BigBiglinn/INSULIN_PUMP/docs/handover/ROUTING_STAGES.md

# Staged re-route log (branch `placement-opt`)

**Board status:** NOT fully connected, NOT electrically verified, NOT fabrication-ready.

**Recovery points (never amended):**
- tag `baseline-routing-e8d141c`: the routed board before placement optimisation;
- commit `9da03dc`: the approved v2 placement, ripped up and not routed.

## 0. Pre-routing reconciliation (owner gate 2)

The full table is in `validation/logs/unrouted_reconciliation.md`, generated by `scripts/reconcile_unrouted.py`. It lists every pair, both endpoints and every pad on each affected net.

The 80 unconnected pairs, each assigned to exactly one group:

| Group | Pairs | Nets | Content |
|---|---|---|---|
| W: WBA55-related, waiting for the ST documents | 12 | 8 | HSE_IN/OUT, LSE_IN, RF_MCU, WBA_VDD11/VDDANA/VDDRF/VDDRFPA. Unchanged since the baseline. |
| P: placeholder or intentionally unfitted endpoint | 11 | 7 | Pairs ending on DNP or PLACEHOLDER parts: R312 bleeder, Q302/R309/R310 output switch, Q303 level shifter, T301 transformer, and R714 RS-485 termination (DNP) |
| R: opened by the approved placement rip-up | 44 | 23 | All on the 23 nets listed in `validation/logs/placement_move_log.txt` |
| G: genuine, existed before placement | 13 | 12 | +3V3, CHG_INT_N, ENC_A_S, ENC_I, ENC_I_M, I2C_SDA ×2, MAIN_SWCLK, PMD_MOSI_M, PMD_READY_M, PMD_SCLK_M, VBAT_FUSED, VBAT_SENSE |

**Correction to the earlier "14 genuine" figure.** One of those 14, RS485_B (R714.2 ↔ U701.7), has R714 as its only missing end, and R714 is DNP (the RS-485 terminator). It is therefore counted under P. The genuine count is 13.

Of the 22 genuine baseline pairs:
- 13 are in G;
- 1 (RS485_B) is in P;
- 8 were on nets that the placement rip-up has since removed in full (CON_SUP_RX/TX, +48V_MOT ×2, ENC_VCC, FLY_PGOOD ×2, FLY_SS). Those connections are now inside groups R and P.

## 0.1 Topology gate for the flyback / 48 V output (owner gate 3)

| Net(s) | Defined by the schematic and ratings? | Decision |
|---|---|---|
| FLY_GATE, FLY_CS, FLY_RT, FLY_SS, FLY_FB (low-voltage node), FLY_COMP, FLY_COMP_RC; FLY_PGOOD local part (U301.11 / R302 / TP302); U301 VCC to C304; PGND pin to EP | Yes. Every part is fitted with status DS, CALC or DECIDED. Connections follow LM51551 SNVSB75E Table 7-1 and Fig. 10-12. Part values are preliminary but do not change the connections. | **Route in Stage 1** |
| FLY_SW, FLY_SEC, FLY_CLAMP (and VBAT/GND at T301) | **No.** T301 is a PLACEHOLDER footprint with an assumed pinout (U-04 / FL-4). The clamp loop geometry depends on the real part (FL-1). | **Blocked:** needs the transformer choice |
| +48V_MOT to J703, TP301, C702 | **No.** The J703 (JST SH, 1.0 mm pitch) rating and the HV48 clearance rule are unapproved (U-17 / FL-6 / CF-6). | **Blocked:** needs approval |
| +48V_RAW (D301 / C309 / C310 / C311 / C312 / R307 / R311) and FLY_SNUB | **Not safely.** Secondary OVP (U-23 / FL-8) may need space on +48V_RAW. The output switch and bleeder (U-06, M8 deferred) share the net. The snubber values depend on T301. | **Blocked:** needs the OVP and output-switch decision |
| FLY_EN | Defined, but it is a safety net (see below) | Its own later stage, reviewed separately |

## 0.2 Safety-control nets (owner gate 6)

**FLY_EN** (K-10, fail-off). Intended pads, from `scripts/design.py`, sheet "Kill path":
- U301.12 (LM51551 UVLO/EN);
- R401.1 (4.7 k pull-down to GND: fail-off default);
- R402.2 (1 k from MCU_48V_EN, so the supervisor can overpower the main MCU);
- Q401.3 (BSS138 drain; gate = SUP_VETO with the R403 10 k pull-up, so the veto is ON by default);
- TP401.1;
- Q303.1, a DNP PLACEHOLDER level shifter for the undesigned output switch. It is optional until U-06 is decided and will remain an unconnected P item.

Intended levels:
- MCU high: 3.3 V × 4.7 / 5.7 = 2.72 V, so the converter runs.
- Pull-down only, or Q401 on: about 0 V, below the 0.4 V EN minimum (SNVSB75E), so it shuts down.

A completed route proves only copper continuity. It does not prove fail-off behaviour; that still needs SG-03/SG-05 on hardware (bench validation is outside this digital handover).

**HB_S2M** (supervisor to main heartbeat): U601.13 (STM32C031 PA2, USART2_TX) to U501.12 (STM32WBA55 PA1, LPUART1_RX), point to point, with no other parts. The pins were checked against the STM32CubeMX 6.18.1 database (`validation/logs/pinmap_check.md`). Routing it does not prove the heartbeat or timeout logic, which is firmware and needs bench verification.

Neither net is routed in Stage 1.

## 1. Stage 1: LM51551 controller nets (11 Oct 2026)

**Checkpoints:**
- `route-stage1-before`: tag, before Stage 1;
- `route-stage1a-hand`: tag, after the power-critical hand routes.

**Route specifications:** `validation/routing/stage1_hand.json` (1a) and `validation/routing/stage1_hand_b.json` (1b), applied with `scripts/route_stage.py hand`.

**Why not Freerouting:** Freerouting 2.1.0 ignored both `-inc` (ignore net classes) and `-mp` (maximum passes). It routed nets outside the stage and did not stop, so I stopped it and used none of its output. Every Stage 1 route is an explicit, reviewable geometry that was checked by DRC.

### 1.1 Results against `route-stage1-before`

Full comparison: `validation/routing/stage1_vs_checkpoint.txt`, from `scripts/compare_stage.py`.

| Check | route-stage1-before | Stage 1 done |
|---|---|---|
| ERC | 6 power_pin_not_driven (U501, intentional) + 1 lib_symbol_mismatch | identical (schematic not modified) |
| DRC copper (clearance, short, crossing, hole, edge) | 0 | 0 |
| Schematic parity | 0 | 0 |
| via_dangling / track_dangling | 6 / 1 | 6 / 1 (same items) |
| Silkscreen warnings (overlap / over copper / edge / mirrored) | 82 / 73 / 3 / 2 | identical |
| Unconnected pairs | 80 | **67** |
| Nets whose copper changed | n/a | FLY_GATE, FLY_CS, FLY_FB, FLY_SS, FLY_RT, FLY_COMP, FLY_COMP_RC, FLY_PGOOD, plus GND and VBAT plane stubs at U301 and C305; **nothing outside this list** |
| BOM re-export | n/a | byte-identical to the committed BOM |

**The 13 net closures:**
- FLY_COMP ×2
- FLY_COMP_RC
- FLY_CS ×4
- FLY_FB ×2
- FLY_GATE
- FLY_PGOOD R302.1–TP302.1
- FLY_RT
- FLY_SS

**Explanation of every changed or "new" unconnected pair:**
- **FLY_PGOOD:** the pair `R302.1–U301.11` is now reported as `Track–U301.11`. The R302/TP302 part is routed; U301.11 is still not connected (blocked, see §1.3). `U301.11–U501.28` is unchanged; it belongs to the signal stage.
- **SW48_GATE, VBAT_FUSED, VBAT_SENSE, WBA_VDDRFPA:** one pair each was relabelled by KiCad after the zone refill, which chose a different nearest endpoint. No copper on these nets changed, and the per-net pair counts are unchanged. These are not new gaps.

### 1.2 Check against the LM51551 layout guidance (SNVSB75E section 10.5.1)

| Item | As routed | Assessment |
|---|---|---|
| Gate drive U301.3 → Q301.4 | 4.67 mm, 0.3 mm wide, **2 vias**. The B.Cu segment is 2.9 mm. | Short, but not ideal. The vias are forced because the gate path must cross the Q301 → R305 current path (the Q301 gate pin faces R305). The B.Cu segment references In2 (VBAT polygon), not the In1 GND plane, so its return path couples through the VBAT plane and its decoupling. **Review item.** |
| Switch current path Q301 source (pads 1–3) → R305.1 | about 6.3 mm, 0.5 mm wide (bar over the source pads), F.Cu, no vias | Meets the "small loop" intent for its part of the loop. 0.5 mm on 1 oz copper is adequate for about 1.1 A rms (FLYBACK_DESIGN.md), with 3.1 A peaks. A wider pour is preferable when the clamp and transformer area is finalised. |
| Kelvin sense U301.5 → R305.1 | 6.8 mm, 0.2 mm wide, F.Cu, no vias. Lands on R305.1 separately from the power track, about 0.6 mm from it. | The sense trace shares no copper with the power path, so the 0.5 mm power track's resistance is outside the measurement. Remaining items: the sense lands at the outer (left) half of the pad rather than its inner edge; the CS return side (R305.2 → GND) goes through the plane, not a Kelvin trace to U301 PGND (this is **FL-3**); and the sense trace runs parallel to the power track for about 3.3 mm. **Review items.** |
| VCC / BIAS (U301.1, .2) → C304.1 | Pins 1 and 2 joined, then 3.9 mm, 0.3 mm wide, to C304.1. C304.1 and C304.2 each keep their own plane via. The 3 old VCC/PGND plane vias next to U301 were removed. | Follows "CVCC near the device": the capacitor is now in the direct VCC path instead of being reached only through the plane. C304's ground returns through a plane via (2.2 µF, 1.6 mm from the pins). |
| PGND (U301.4) → exposed pad | 0.7 mm direct, 0.25 mm wide | Pin 4 now joins the exposed pad directly. |
| Exposed pad (U301.13) to the GND plane | One stub plus 1 via (from the earlier fan-out) | **Review item:** only one via. SNVSB75E's thermal guidance favours several vias under or around the pad. Adding thermal vias is a layout addition I have not made. |
| FB node (U301.8, R307.2, R308.1) | 9.5 mm, 0.15 mm wide, 2 vias, B.Cu hop of 3.55 mm under the R/C column. At least 3.7 mm from the gate segment; nowhere near FLY_SW (x ≥ 170). | The top-layer paths are blocked by the 0.6 mm HV48 clearance around R307.1 (+48V_RAW) and by a GND via. Routing it longer than ideal is a deliberate trade for keeping the high-impedance node away from switching copper. |
| RT, SS, COMP, COMP_RC | 3.4–7.2 mm, F.Cu, no vias | Short and direct; the AGND-side parts keep their own plane vias. |
| C305.2 (SS cap) ground | Its fan-out via was removed. It now shares R308.2's existing GND plane via (0.73 mm track). | Still a direct plane connection. This was needed to open the pin 8 (FB) escape. |

### 1.3 Blocker found in Stage 1 (resolved by D1 option 1, see §3)

**FLY_PGOOD U301.11 → R302.1 is not routed.**

Pin 11 sits between pin 10 (RT, routed) and pin 12 (FLY_EN, reserved). The only direct escape to the west is blocked by R301.2's GND fan-out via at (163.82, 160.0). Moving that via is not possible without one of these:

1. **Rotate R301, R302, C305 and R308 by 180°**, so that their signal pads face U301 and their GND pads face away. This is the cleanest fix but is a component move.
2. **Tie the RT, SS and FB-bottom grounds to the U301 AGND pin or exposed pad with local copper.** This is the SNVSB75E AGND recommendation, but it is the **FL-3** grounding decision.
3. **Give pin 11 the escape via reserved for FLY_EN** (about (164.2, 161.0)). This would push FLY_EN onto a worse path, so it needs a FLY_EN decision first.

### 1.4 Not routed in Stage 1, by design

- FLY_EN (Stage 2, safety review);
- HB_S2M;
- FLY_PGOOD U301.11 → U501.28 (signal stage);
- FLY_SW, FLY_SEC, FLY_CLAMP and FLY_SNUB (T301 placeholder);
- +48V_RAW and +48V_MOT (OVP, output switch, J703 rating);
- all WBA55-dependent nets.

**Pre-existing item noted:** the SW48_GATE autorouted track (a DNP placeholder net) runs on F.Cu at x = 170.33, between Q301's source and drain pads. It passes DRC. It should be removed or re-routed when the output switch (U-06 / M8) is decided, because it lies next to the switch node.

### 1.5 Updated reports

- `validation/drc/pump_v2-drc.rpt` and `.json`
- `validation/erc/pump_v2-erc.rpt`
- `validation/logs/unrouted_reconciliation.md` (W 12 / P 11 / R 31 / G 13 = 67)
- `validation/logs/unrouted_nets.txt` (older grouping, kept for continuity; it still counts RS485_B as genuine)
- `validation/logs/unrouted_corridors.txt`
- `validation/routing/stage1_fcu_controller.png` (F.Cu around U301/Q301; the F.Cu GND pour is shown filled)

## 2. Stage 2: encoder supply, PMD401 5 V, supervisor console (11 Oct 2026)

**Checkpoints:**
- `route-stage2-before` (= `route-stage1-done` copper; the docs commit 4510a91 is in between);
- `route-stage2-done`.

**Route specification:** `validation/routing/stage2_hand.json`, applied with `scripts/route_stage.py hand`. Full comparison: `validation/routing/stage2_vs_checkpoint.txt`.

**Scope change:** +3V3 to R302 was taken out of Stage 2. The approved D1 rotation of R302 moves the pad it lands on, so it is routed in the D1 milestone.

**Freerouting:** I tried it once more, with the restriction set in its own settings file (`ignore_net_classes`, `max_passes`, `job_timeout`). It ignored all three: 51 passes, no timeout, and every net routed. I stopped it, discarded its output and restored the settings file. Every Stage 2 route is explicit.

### 2.1 Routes

| Net | Path | Width | Layers / vias |
|---|---|---|---|
| ENC_VCC | JP701.2 → C701.1 → J705.3. C701 sits in series on the path, so the decoupling capacitor is between the jumper and the connector. | 0.3 mm | F.Cu, 0 vias |
| PMD_5V | JP701.3 → via → B.Cu under the ENC_A/ENC_SHLD F.Cu wall, east of the RS-485 B.Cu run → J702.2 → B.Cu between the PMD_MOSI via and the J702.MP GND via → J701.3 | 0.3 mm | F/B, 3 vias |
| CON_SUP_RX | U601.32 → corridor between the U601 right-hand pins and SUP_VETO (0.25 / 0.26 mm gaps) → via → B.Cu under HB_M2S → J503.4 | 0.2 mm | F/B, 1 via |
| CON_SUP_TX | U601.29 → east below the SUP_VETO via → north at x = 157.85, between SUP_PARK and the flyback controller parts → via → B.Cu north of the J503 row → J503.3 | 0.2 mm | F/B, 1 via |

**Review notes:**
- **CON_SUP_TX** runs about 32 mm, partly past the edge of the flyback controller area (about 2.0 mm edge to edge from the FB via at (160.2, 156.4), about 2.8 mm from the R308 pad). It is a low-speed console UART, so this is acceptable for a bench prototype.
- **CON_SUP_RX** squeezes between the U601 pins and the SUP_VETO track with 0.25 mm gaps. That is legal under the generic rules (0.15 mm), but tight.
- **PMD_5V** is a long B.Cu run along the connector edge. Its current is small: the PMD401 "5V Out" feeds only the encoder, and only when JP701 is set to 2–3.

### 2.2 Results against `route-stage2-before`

| Check | route-stage2-before | route-stage2-done |
|---|---|---|
| ERC | 6 intentional U501 errors + 1 cosmetic U701 warning | identical (schematic not modified) |
| DRC copper (clearance, short, crossing, hole, edge) | 0 | 0 |
| Schematic parity | 0 | 0 |
| via_dangling / track_dangling | 6 / 1 | 6 / 1 (same items) |
| Silkscreen warnings | 82 / 73 / 3 / 2 | identical |
| Unconnected pairs | 67 | **61** |
| Nets whose copper changed | n/a | ENC_VCC, PMD_5V, CON_SUP_TX, CON_SUP_RX only (29 items added, 0 removed) |
| BOM re-export | n/a | byte-identical |

**Pairs closed (6):** ENC_VCC ×2, PMD_5V ×2, CON_SUP_TX, CON_SUP_RX.

**Relabelled pairs:** +3V3, VBAT_FUSED, WBA_VDDRF and WBA_VDDRFPA each show one pair with different reported endpoints after the zone refill. No copper on these nets changed and the per-net counts are unchanged. **No regressions.**

**Electrical testing:** none performed. Copper continuity is not functional verification.

## 3. D1 milestone: R301 / R302 / C305 / R308 rotation (11 Oct 2026)

**Approval:** owner-approved option 1, subject to clearance and connectivity checks.

**Checkpoints:**
- `route-d1-before` (= commit 3f7ba36, `route-stage2-done`);
- `route-d1-done`.

**Route specification:** `validation/routing/d1_rotation.json`, applied with `scripts/route_stage.py hand`, which gained `rotate` and exact-segment `remove_tracks` support. Full comparison: `validation/routing/d1_vs_checkpoint.txt`. Render: `validation/routing/d1_fcu_controller.png`.

**Freerouting:** not used.

### 3.1 What the rotation affected (inspected before any change)

Rotating each part 180° in place swaps its pad positions. Eight copper items landed on the four parts. All of them came from Stage 1 or the original plane fan-out; **no Stage 2 copper was affected.**

| Pad (before) | Copper on it | Action |
|---|---|---|
| R308.2 GND, C305.2 GND | Stubs to a shared GND via at (162.82, 157.47) | Via and stubs removed. After rotation that via would sit between the FB and SS pads. |
| R301.2 GND | Stub to a GND via at (163.82, 160.0) | Removed. It would have landed on the RT pad, and it was the via blocking the U301.11 escape. |
| R302.2 +3V3 | Stub to a +3V3 via at (163.82, 161.8) | Removed. It would have landed on the PGOOD pad, and it never reached a +3V3 plane, because In2 is the VBAT polygon there. |
| R308.1 FB | B.Cu hop with 2 vias from the FB node | Removed. R308.1 now faces U301, so no via is needed. |
| C305.1 SS, R301.1 RT | Stage 1b SS and RT routes | Replaced by shorter direct routes |
| R302.1 PGOOD | Stage 1b TP302 link | Replaced |

### 3.2 New copper

| Net | Route | Width | Vias |
|---|---|---|---|
| FLY_FB | FB vertical closed at the old via jog. Stub (163.55, 156.4) → R308.1. The U301.8 → R307.2 section from Stage 1 is unchanged. | 0.15 mm | **0** (was 2) |
| FLY_SS | U301.9 → under the FB corner → C305.1 | 0.15 mm | 0 |
| FLY_RT | U301.10 → R301.1 | 0.15 mm | 0 |
| FLY_PGOOD | U301.11 → (164.1, 159.75) → x = 163.6 → R302.1. TP302 → channel between the R301 and R302 rows → R302.1. | 0.15 / 0.2 mm | 0 |
| GND | R308.2, C305.2 and R301.2 each get their **own** stub and GND plane via on the west side (x = 160.2) | 0.3 mm | 3 |
| +3V3 | R302.2 → south → west along y = 162.9 → via at (154.6, 163.6), over the In2 +3V3 region (x < 155) | 0.25 mm | 1 |

**Grounding topology unchanged.** Every GND pad still has its own direct plane via, as before. The only difference is which side of the part the via sits on. No local AGND copper, no new GND-to-GND links, and no AGND/PGND change (FL-3 untouched).

### 3.3 Results against commit 3f7ba36 (`route-stage2-done`)

| Check | 3f7ba36 | route-d1-done |
|---|---|---|
| ERC | 6 intentional U501 errors + 1 cosmetic U701 warning | identical (schematic not modified) |
| DRC copper (clearance, short, crossing, hole, edge) | 0 | 0 |
| Schematic parity | 0 | 0 |
| via_dangling / track_dangling | 6 / 1 | 6 / 1 (same items) |
| silk_overlap / silk_over_copper | 82 / 73 | **83 / 71** (see below) |
| silk_edge / unmirrored text | 3 / 2 | 3 / 2 |
| Unconnected pairs | 61 | **59** |
| Footprints changed | n/a | R301, R302, C305 and R308 only: orientation 0° → 180°, positions unchanged |
| Nets whose copper changed | n/a | FLY_FB, FLY_SS, FLY_RT, FLY_PGOOD, GND (local stubs and vias), +3V3 (R302 only). Nothing else. |
| BOM re-export | n/a | byte-identical |

**Pairs closed (2):**
- FLY_PGOOD U301.11 ↔ R302 (local part now complete);
- +3V3 to R302.

**Relabelled pairs, with no copper change on the net:**
- FLY_PGOOD's remaining U501.28 gap is now reported from a track end. It is Stage 5a.
- RS485_B, SW48_GATE, VBAT_FUSED, WBA_VDDRF and WBA_VDDRFPA each show different endpoints after the zone refill. Their per-net counts are unchanged.

**Silkscreen changes:** every one involves the reference text of a rotated part, which rotated with it: 15 items removed, 14 added. They are cosmetic, to be cleaned up with U-32.

**Regressions: none.**

### 3.4 Checks specific to this milestone

| Item | Result |
|---|---|
| HV48 clearance near R307.1 (+48V_RAW) | DRC 0. The nearest new copper is the GND via at (160.2, 156.4), about 1.15 mm from the R307.1 pad (rule 0.6 mm). |
| FLY_EN escape for Stage 3 (pin 12 → via site (164.2, 161.0)) | Still free. The via site is 0.223 mm from the new PGOOD track and the stub path is at least 0.273 mm from foreign copper (rule 0.15 mm). This is only checked at the escape; the full FLY_EN route is Stage 3. |
| FB node | Now 0 vias and shorter. The high-impedance node stays on F.Cu, away from switching copper. |
| CON_SUP_TX (Stage 2) | Unchanged. The nearest D1 copper is the GND vias at x = 160.2, about 1.9 mm away. |

**Electrical testing:** none performed. Copper continuity is not functional verification.

## 4. Stage 3: safety-control nets FLY_EN and HB_S2M (11 Oct 2026)

**Checkpoints:**
- `route-stage3-before` (= commit 6a4367b, `route-d1-done`);
- `route-stage3-done`.

**Route specification:** `validation/routing/stage3_hand.json`, applied with `scripts/route_stage.py hand`. Full comparison and clearance margins: `validation/routing/stage3_vs_checkpoint.txt`.

**Freerouting:** not used.

### 4.1 Pre-routing review (owner items 2–4)

| Item | Evidence | Conclusion |
|---|---|---|
| FLY_EN intent | `scripts/design.py`, sheet "Kill path" (K-10): U301.12 UVLO/EN, R401 4.7 k to GND (fail-off), R402 1 k from MCU_48V_EN, Q401 drain, TP401 | Connect U301.12, R401.1, R402.2, Q401.3 and TP401.1 |
| LM51551 pin 12 (TI SNVSB75E, Rev E, Aug 2023: pin table, §7 electrical characteristics, §9.3.1, §9.3.5) | UVLO/EN/SYNC. Enable 0.4 / 0.52 / 0.7 V; UVLO rising 1.425 / 1.5 / 1.575 V; below VEN, shutdown after about 35 µs. "Must not be left floating." Falling edges on this pin act as a **sync input**. 5 µA UVLO hysteresis current. | Levels as designed: 2.72 V when the MCU drives it, about 0 V with the pull-down or the veto. The 5 µA × 825 Ω gives about 4 mV, which is negligible. **Layout consequence:** keep FLY_EN away from the switch node, so coupled negative glitches cannot act as sync pulses. |
| Q401 pinout (Nexperia BSS138, `docs/datasheets/bss138_nexperia.pdf`, Table 2) | 1 = G, 2 = S, 3 = D | Matches the schematic: G = SUP_VETO, S = GND, D = FLY_EN |
| HB_S2M intent | `scripts/design.py`; `validation/logs/pinmap_check.md` (STM32CubeMX 6.18.1 database) | U601.13 = PA2 USART2_TX (supervisor) → U501.12 = PA1 LPUART1_RX (main). Point to point, no other parts. |
| Q303 (on FLY_EN) | DNP PLACEHOLDER level shifter for the undesigned K-12 output switch (U-06) | **Not connected.** It depends on the unresolved output-switch design. FLY_EN – Q303.1 stays an unconnected P item by design. |
| FLY_EN escape (the 0.223 mm item from D1) | Re-measured along the **full** route after routing (§4.3) | Legal everywhere (rule 0.15 mm). Tightest gap 0.224 mm, at the escape. |

### 4.2 Routes

| Net | Path | Length / vias |
|---|---|---|
| FLY_EN | **Local tree, F.Cu 0.2 mm:**<br>- R402.2 → TP401;<br>- R401.1 → (between the R401/R402 and R405 rows) → TP401;<br>- TP401 → Q401.3, entering from above, clear of the SUP_VETO diagonal.<br>**Long run:** via at (173.4, 133.0), then one straight B.Cu run to the Stage 1 escape via (164.2, 161.0), then U301.12. | 47.4 mm, 2 vias |
| HB_S2M | U501.12 → escape south-west past the pin 11 +3V3 via → F.Cu west at y = 122.3 → south at x = 134.5 → via at (134.5, 161.3) → B.Cu east at y = 161.3 → via under the U601 body at (147.25, 161.3), between SUP_NRST and HB_M2S → U601.13 from its inner end | 64.9 mm, 2 vias |

**Why HB_S2M is long.** U501.12 sits at the corner next to the WBA55 supply-placeholder block (C510–C513, R511–R513, their VDDRF / VDDRFPA F.Cu tracks, and the LSE_OUT / VDDHPA / VDDRFPA B.Cu runs at y ≈ 127.8–128.5). A direct southward route would need a via in that block, and there is no legal space for one on either layer. It would also pre-empt the WBA55 supply layout that D5 defers until the ST documents arrive. The chosen route goes around the block's west edge and touches none of that circuitry.

### 4.3 Clearance margins along the full routes (edge to edge; rule 0.15 mm, HV48 0.6 mm)

| Net | Tightest foreign copper | Next | Switching copper (FLY_SW / GATE / CS / CLAMP / SEC) |
|---|---|---|---|
| FLY_EN | 0.224 mm FLY_PGOOD track (U301 escape) | 0.274 mm U301.11; 0.349 mm U301 EP (GND); 0.423 mm GND via (B.Cu); 0.516 mm SUP_VETO | nearest is the U301.3 gate pin at 1.79 mm. The B.Cu run is at least 2.7 mm from the gate B.Cu segment and about 5 mm from the switch node. |
| HB_S2M | 0.199 mm SUP_NRST (U601 corner) | 0.249 mm U601.14 (HB_M2S); 0.274 mm U501.11 / +3V3 stub | none within 3 mm |

No HV48 net is within the 0.6 mm class clearance of either route.

### 4.4 Results against `route-d1-done`

| Check | route-d1-done | route-stage3-done |
|---|---|---|
| ERC | 6 intentional U501 errors + 1 cosmetic U701 warning | identical (schematic not modified) |
| DRC copper (clearance, short, crossing, hole, edge) | 0 | 0 |
| Schematic parity | 0 | 0 |
| via_dangling / track_dangling | 6 / 1 | 6 / 1 (same items) |
| Silkscreen (overlap / over copper / edge / mirrored) | 83 / 71 / 3 / 2 | identical |
| Unconnected pairs | 59 | **54** |
| Footprints changed | n/a | none |
| Nets whose copper changed | n/a | FLY_EN (+13 items) and HB_S2M (+8 items) only; 0 removed anywhere |
| BOM re-export | n/a | byte-identical |

**Pairs closed (5):**
- FLY_EN R402.2–TP401, R401.1–TP401, TP401–Q401.3 and Q401.3–U301.12;
- HB_S2M U501.12–U601.13.

**Remaining FLY_EN pair:** the DNP placeholder Q303.1 only, which is intentional.

**Relabelled pairs, with no copper change on the net:** CHG_INT_N, SW48_GATE, VBAT_FUSED and WBA_VDDRFPA.

**Regressions: none.**

### 4.5 Safety-control review notes (not resolved by routing)

- **Continuity is not behaviour.** A routed FLY_EN proves only copper continuity. Fail-off behaviour (pull-down default, veto overriding the MCU, shutdown below VEN) needs **SG-03 / SG-05 on hardware**. Neither has been performed.
- **FLY_EN and the VBAT plane.** The FLY_EN B.Cu run lies under the controller area, over the In2 VBAT polygon, which carries the pulsed flyback primary current. The node impedance is about 825 Ω (1 k ∥ 4.7 k). Coupled ripple is expected to be small but has **not been analysed or measured**. The UVLO/SYNC pin interprets falling edges as sync pulses, which is why this needs bench confirmation.
- **HB_S2M length.** HB_S2M is long (64.9 mm) and runs parallel to the board's west region. It is a low-speed UART heartbeat. Its timeout and fault behaviour are firmware, untested.
- **Tight gaps.** HB_S2M passes 0.199 mm from SUP_NRST and 0.249 mm from HB_M2S at the U601 corner. That is legal under the generic rules; a fab rule check is still needed (U-16).
- **Q303 is unconnected.** If the output switch (U-06) is designed with this level shifter, FLY_EN's routing must be revisited.

**Electrical testing:** none performed.

## 5. Stage 4: encoder connections (11 Oct 2026)

**Checkpoints:**
- `route-stage4-before` (= commit a6fd898, `route-stage3-done`);
- `route-stage4-done`.

**Route specification:** `validation/routing/stage4_hand.json`, applied with `scripts/route_stage.py hand`. Full comparison and margins: `validation/routing/stage4_vs_checkpoint.txt`.

**Freerouting:** not used.

### 5.1 Pre-routing verification (owner item 2)

| Net | Endpoints (board = schematic, parity 0) | Intent (source) |
|---|---|---|
| ENC_B | J705.4, D708.1, R709.2, R712.2 | Encoder B from J705 → TVS D708 (E-07) → R709 100 Ω to the main MCU (ENC_B_M, U501 PA8 TIM2_CH2) and R712 100 Ω to the supervisor (S-07). `scripts/design.py` |
| ENC_B_S | R712.1, U601.18 | Supervisor encoder B: U601 PA7 TIM3_CH2 (CubeMX check, `pinmap_check.md`) |
| ENC_A_S | R711.1, U601.17 | Supervisor encoder A: U601 PA6 TIM3_CH1 (CubeMX check) |
| ENC_I | J705.1, R710.2, D709.1 | Encoder index → TVS D709 → R710 to the main MCU (ENC_I_M). R710.2 and D709.1 were already joined; only J705.1 was missing. |

**Caveats recorded, not resolved by routing:**
- J705's pinout is **ASSUMED**: it mirrors the PMD401 sensor connector, "VERIFY vs LL06 encoder cable" (U-14). ENC_A, ENC_VCC and GND were already routed to it on the same assumption.
- D707–D709 are **TBD** TVS parts (U-15). The SOD-323 footprint and the shunt connection are defined; if the chosen part changes the footprint, the pad connections must be re-checked.

**Not touched:** RS485_B → R714, which waits for the owner decision (D3).

### 5.2 Routing method: `scripts/grid_route.py` (new)

Freerouting is not used. I wrote a small, deterministic, two-layer grid router (A\*, 8-directional, via cost 4 mm) that routes **one named connection at a time**:
- All existing copper is a fixed obstacle, at rule clearance + 0.05 mm margin (0.2 mm; 0.7 mm to HV48 nets).
- RF_ANT and RF_MCU get 1 mm extra on every layer; LSE_IN and LSE_OUT get 0.8 mm.
- No via inside any pad.
- **Owner keep-outs:**
  - the WBA55 / U501 / RF / crystal / SWD region, x 129.5–162.5, y 100.5–134 (D5);
  - the flyback / 48 V block, x 159.6–200, y 140.5–168.

Its output is an ordinary explicit route specification (pad-centre endpoints, 45° geometry), which then goes through the same apply, DRC and compare steps.

**Bug found and fixed during this stage.** In the first ENC_A_S / ENC_B_S run, the keep-out rectangles were not applied: a zero-radius rectangle marked no cells. ENC_A_S came out under C518 (the LSE load-capacitor placeholder) inside the WBA55 keep-out. That output was discarded and the router fixed. The Stage 4a routes (ENC_B and ENC_I) were then checked point by point and lie wholly outside both keep-outs. The two supervisor lines were routed on a 0.05 mm grid, so the 0.5 mm-pitch U601 pins sit on grid. One generated ENC_B overlap (duplicated same-net copper at x = 179.1) was merged by hand before applying.

### 5.3 Routes

| Net | Length (net copper) | Vias | Path summary |
|---|---|---|---|
| ENC_B | 58.1 mm | 2 | R712.2 → D708.1 → R709.2 on F.Cu, in the encoder-interface row. J705.4 → north-west on F.Cu along x = 201.6, then diagonally → B.Cu hop → R712.2. |
| ENC_I | 60.8 mm (including pre-existing copper) | 4 (2 new) | J705.1 → via → B.Cu diagonal and vertical at x = 192.6 → via → D709.1 |
| ENC_A_S | 68.0 mm | 4 | U601.17 → via under the U601 body → B.Cu north-east, then north at x = 159.0 in the corridor between the two keep-outs → x = 162.55 along the keep-out edge → F.Cu up x = 168.25 → R711.1 |
| ENC_B_S | 71.8 mm | 4 | U601.18 → via under the U601 body → B.Cu around the ENC_A_S via (small hook) → F.Cu north at x = 153.1 (between HB_M2S and SUP_VETO) → along the keep-out edge → B.Cu → F.Cu up x = 169.1 → R712.1 |

### 5.4 Clearance margins (edge to edge; rule 0.15 mm)

| Net | Tightest foreign copper | Switching or 48 V copper within 3 mm |
|---|---|---|
| ENC_B | 0.199 mm (ENC_A_S via, JP701.3, PMD_5V via); 0.249 mm R704.2, R710.1 | none |
| ENC_I | **0.151 mm PMD_MOSI (B.Cu)**. **Pre-existing:** it is the old ENC_I via at (181.08, 106.63), identical at `route-stage4-before`. Next: 0.189 mm R703.1, then 0.199 mm R705.1 | none |
| ENC_A_S | 0.199 mm ENC_B; 0.209 mm HB_M2S; 0.220 mm SUP_SWCLK (B.Cu) | none |
| ENC_B_S | 0.199 mm CON_SUP_RX (B.Cu); 0.208 mm SUP_SWDIO; 0.221 mm SUP_VETO | none |

### 5.5 Results against `route-stage3-done`

| Check | route-stage3-done | route-stage4-done |
|---|---|---|
| ERC | 6 intentional U501 errors + 1 cosmetic U701 warning | identical (schematic not modified) |
| DRC copper (clearance, short, crossing, hole, edge) | 0 | 0 |
| Schematic parity | 0 | 0 |
| via_dangling / track_dangling | 6 / 1 | 6 / 1 (same items) |
| Silkscreen | 83 / 71 / 3 / 2 | identical |
| Unconnected pairs | 54 | **48** |
| Footprints changed | n/a | none |
| Nets whose copper changed | n/a | ENC_A_S (+19 items), ENC_B (+21), ENC_B_S (+24), ENC_I (+11); 0 removed anywhere |
| BOM re-export | n/a | byte-identical |

**Pairs closed (6):** ENC_B ×3, ENC_I (J705.1), ENC_A_S, ENC_B_S.

**Relabelled pairs, with no copper change on the net:** CHG_INT_N, ENC_I_M and WBA_VDDRFPA.

**Regressions: none.**

### 5.6 Concerns

- **New finding about Stage 3 (HB_S2M near the LSE crystal).** The HB_S2M F.Cu run at x = 134.5 passes 0.60 mm from the Y502 pad 1 (LSE_IN), just outside the Y502 courtyard (x ≤ 134.07). It also crosses the LSE_OUT B.Cu trace at (134.5, 128.46), with both inner planes (In1 GND, In2) between them. It passes DRC, but ST oscillator guidance generally keeps signal lines away from the 32.768 kHz crystal and its traces. The crystal layout is still waiting for the ST documents (D5), so this route may **constrain or conflict with** that layout. **Recommendation:** re-route HB_S2M further west or north when the LSE layout is fixed. Not changed in Stage 4, as instructed.
- **Long supervisor encoder lines.** ENC_A_S and ENC_B_S are 68–72 mm, with 4 vias each. They are slow quadrature inputs, but their signal integrity and their susceptibility to the 48 V switching have not been analysed.
- **Vias under the U601 body.** Three vias now sit under the U601 LQFP body (HB_S2M, ENC_A_S, ENC_B_S). That is acceptable for a package without an exposed pad if the vias are tented; confirm with the assembler (U-16).
- **Pre-existing 0.151 mm gap** (ENC_I via to PMD_MOSI), at the rule minimum. Check against the real fab rules.
- **J705 pinout and TVS parts.** J705's pinout is assumed (U-14) and the TVS parts are TBD (U-15).

**Electrical testing:** none performed. Routing checks are not evidence of electrical operation.

## 6. Stage 5a: U501 side 25–36 connections (11 Oct 2026). Result: **no copper changed, three blockers**

**Checkpoint:** `route-stage5a-before` (= commit a3ef25b, `route-stage4-done`). The board and all KiCad files are identical to that checkpoint.

**Freerouting:** not used.

**HB_S2M:** not re-routed (owner instruction). See §6.3.

### 6.1 Verification of the three connections

| Net (open pair) | Pin (STM32CubeMX 6.18.1, `pinmap_check.md`) | Electrical level and supply evidence | Copper / corridor finding | Decision |
|---|---|---|---|---|
| **FLY_PGOOD** (U501.28 ↔ R302/TP302 copper) | U501.28 = PA12, GPIO: confirmed | LM51551 PGOOD is open-drain (SNVSB75E), pulled up to +3V3 by R302 100 k. Pin voltage ≤ VBIAS + 0.3 V holds for VBAT ≥ 3.0 V. A 3.3 V level on a VDD-domain pin needs no 5 V tolerance. **Electrically confirmed.** | **Pin 28 cannot be escaped.** The pre-existing escapes of pin 29 (RS485_RO, diagonal from (151.84, 119.75) to (153.04, 120.96)) and pin 30 (LED_MAIN, diagonal from (151.91, 119.25) to (153.6, 120.94)) cross directly in front of pin 28 on F.Cu. MAIN_SWDIO (pin 27) turns down beside it. A 0.15 mm track straight east from pin 28 would hit RS485_RO and LED_MAIN. There is no room for a via between the pad end (x = 151.88) and those tracks. `scripts/grid_route.py` (0.05 mm grid, `validation/routing/stage5a_request.json`) found no exit from the pad. | **Left open. Blocker: needs re-routing of pre-existing RS485_RO and LED_MAIN copper (approval D7).** |
| **PMD_READY_M** (R706.1 ↔ U501.33) | U501.33 = PB15, GPIO: confirmed | The PMD401 manual (150025-01, §3.5) gives Ready as an output with a "~20k pull-up" but **does not state the pull-up rail** (3.3 V or 5 V). If it is 5 V, PB15 must be 5 V-tolerant: **U-10, which needs DS14127 (unread).** | not attempted | **Left open: depends on an unresolved electrical property (D8).** |
| **MAIN_SWCLK** (existing stub ↔ U501.26) | U501.26 = PA14 SWCLK: confirmed; 3.3 V internal SWD | Level fine | The existing B.Cu stub from J502 ends at (145.91, 124.19), south-west of U501 and beside the LSE pins 16/17 and the LSE_OUT escape. Pin 26 is on the opposite (right) side. Under the QFN, B.Cu is blocked by the MAIN_SWDIO run along the bottom pin row, and F.Cu is the exposed pad. Any completion must cross the LSE pin-escape area, or replace the approved SWD copper. | **Left open: depends on the crystal layout (D5) or on re-routing existing SWD copper (approval).** |

**Consistency note.** The 5 V-tolerance question behind PMD_READY_M (U-10) applies equally to the PMD401- and encoder-facing nets that were already routed at the baseline and in Stage 4 (PMD_FAULT_M, PMD_SCLK_M side, ENC_A_M/B_M/I_M and so on). It is a **schematic-level** risk: leaving one track open does not remove it. It is resolved only by the ST datasheet (FT pin list), by PiezoMotor confirming the pull-up rail, or by a schematic change.

### 6.2 Checks (no copper change)

| Check | route-stage4-done | after Stage 5a |
|---|---|---|
| ERC | 6 power_pin_not_driven (intentional) + 1 lib_symbol_mismatch | identical |
| DRC copper | 0 | 0 |
| Schematic parity | 0 | 0 |
| Unconnected pairs | 48 | **48** (unchanged) |
| Warnings | 6 / 1 / 3 / 83 / 71 / 2 | identical |

**Regressions: none.** Nothing was routed.

### 6.3 Outstanding layout issue: HB_S2M near the LSE crystal (recorded; owner instruction not to re-route yet)

The Stage 3 HB_S2M F.Cu run at x = 134.5 passes **0.60 mm from Y502 pad 1 (LSE_IN)**, just outside the Y502 courtyard (x ≤ 134.07). It also **crosses the LSE_OUT B.Cu trace** at (134.5, 128.46), with In1 (GND) and In2 between the layers. It passes DRC. The 32.768 kHz crystal layout is pending the ST crystal and layout documentation (D5).

**Action:** revisit and re-route HB_S2M once the LSE crystal placement and routing constraints are settled.

**Electrical testing:** none performed.

## 7. D7 investigation: freeing U501 pin 28 (FLY_PGOOD) by re-routing the pin 29 and pin 30 escapes (11 Oct 2026). Result: **not feasible within the approved scope; no copper changed**

**Owner decisions:**
- **D7:** investigate a controlled re-route of RS485_RO (pin 29) and LED_MAIN (pin 30) only. Present the proposal before any copper change.
- **D8:** PMD_READY_M and other possibly voltage-incompatible inputs stay unrouted.
- **D9:** MAIN_SWCLK is deferred to a joint review with the crystal layout and the SWD stub.

**Method.** Everything was done on scratch copies of the board at `route-stage5a-done`. The project PCB is unchanged (`git diff route-stage5a-done -- hardware/kicad/` is empty). Evidence is in `validation/routing/d7_investigation/`. Freerouting was not used.

### 7.1 Current geometry at pin 28 (measured, F.Cu edge to edge)

| Neighbour | Gap from the pin 28 pad |
|---|---|
| RS485_RO diagonal (151.84, 119.75) → (153.04, 120.96), crossing in front of pin 28 | **0.163 mm** |
| MAIN_SWDIO escape (pin 27) | 0.274 mm |
| RS485_RO stub at pin 29 | 0.274 mm |
| LED_MAIN diagonal (153.60, 120.94) → (151.91, 119.25), also crossing in front | 0.565 mm |
| **0.6 mm via anywhere on y = 120.25 between x = 151.93 and 153.33** | **no legal position** (rule 0.15 mm) |

**Pre-existing leftovers found on these two nets:**
- LED_MAIN's pin 30 stub has duplicated, overlapping segments: (151.44, 119.25)–(151.57, 119.25) appears twice.
- RS485_RO has a zero-length segment at (151.44, 119.75).

### 7.2 Why pins 29 and 30 alone cannot free pin 28

The F.Cu region to the right of pins 26–33 is a pocket only about **2.2 mm wide**:
- It runs from the pin ends at x = 151.88 to a wall of F.Cu verticals: MAIN_BOOT0 at x = 154.15, MAIN_NRST at 154.53, **WBA_VDDHPA (a WBA55 supply placeholder) at 155.16**, and MAIN_SWO at 155.81.
- Its top is taken by the MAIN_BOOT0 (pin 34) and MAIN_NRST (pin 36) escape diagonals.

Inside the pocket, the escape vias of **pin 32 (RS485_DI, at (152.68, 118.12))** and **pin 31 (RS485_DE, at (152.81, 119.36))** sit directly in front of pins 30 and 29. Each lower pin's escape is therefore pushed down one row, and pin 28 is the one left without an exit. Re-routing pins 29 and 30 cannot change that while the pin 31 and 32 vias stay.

The pocket is also enclosed by the **RF_ANT placeholder feed** (L502 → J501):
- F.Cu up x = 162.15, then diagonally north-west to J501;
- B.Cu along y = 131.1, beside the crystal/RF capacitor row.

Any route out of U501's right-hand side must therefore cross **under RF_ANT on B.Cu**. Nine existing nets already do so: RS485_RO, RS485_DE, RS485_DI, MCU_48V_EN, PMD_FAULT_M, ENC_A_M, ENC_B_M, PMD_SS_M and WBA_VDDHPA.

### 7.3 Scratch variants

| Variant | Scope | Result |
|---|---|---|
| A | RS485_RO and LED_MAIN escapes removed. FLY_PGOOD first, RF_ANT avoided on all layers. | FLY_PGOOD: **no route**. It cannot leave the pocket without crossing RF_ANT. |
| A′ | As A, but RF_ANT avoided on its own layer only (B.Cu crossing allowed) | FLY_PGOOD routes (70.8 mm, 4 vias), but its escape then **blocks RS485_RO and LED_MAIN: no route for either** |
| C | **Expanded scope:** pins 28–31 hand fan-out, RS485_DE via moved to (154.6, 118.75) | DRC **fails**: new escapes cross MAIN_NRST, MAIN_BOOT0, MAIN_SWO and WBA_VDDHPA (6 tracks_crossing, 1 clearance, 1 short with MAIN_NRST). The moved via sits beyond the wall. |
| D | **Expanded scope:** RS485_DI and RS485_DE vias also freed; two routing orders | One of RS485_RO / LED_MAIN always left **unroutable** |

### 7.4 Expected consequences of any eventual fix (for the decision)

**Copper changed.** A fix would have to re-fan the right and top escapes of U501 pins 24–38 together:
- RS485_DI, RS485_DE, LED_MAIN, RS485_RO, FLY_PGOOD and MAIN_SWDIO;
- probably MAIN_BOOT0, MAIN_NRST and MAIN_SWO;
- and the **WBA_VDDHPA placeholder**, a WBA55 supply that D5 defers.

No schematic change would be needed for the re-fan itself.

**FLY_PGOOD itself.** Even with an escape, its route crosses under the RF_ANT placeholder feed on B.Cu and runs about 70 mm, with 4 vias, through the kill-path cluster area. In the scratch result it is at least 2.98 mm from SUP_PARK, does not cross FLY_EN, and comes down x = 159.55, just outside the flyback keep-out, to TP302.

**RF.** RF_ANT itself is a placeholder (U-20, AN5948 pending). A B.Cu crossing under an F.Cu line with In1 GND as its reference is normal practice, but the RF feed will be re-laid once the ST documents arrive. That reshapes this whole pocket.

### 7.5 Recommendation (owner decision)

1. **Do not re-route pins 29 and 30 alone.** It cannot free pin 28, and it would touch two nets for no gain.
2. **Fold D7 into the U501 fan-out review together with D5 and D9.** Once DS14127 and AN5948 define the VDDHPA, RF feed and crystal layout, re-fan U501 pins 24–38 once, in a single approved change.
3. **Alternative, not evaluated and needing owner, firmware and CubeMX review:** assigning FLY_PGOOD to a different free U501 GPIO with better access is a **schematic and pin-map change**. I have not proposed a specific pin.

**Board status.** Unchanged since `route-stage5a-done`: 48 unconnected pairs; ERC 6 + 1; DRC 0 copper violations, 0 parity. Electrically untested, incomplete, NOT fabrication-ready.

**Tool change.** `scripts/grid_route.py` now accepts `{"m": margin, "same_layer": true}` for avoid-nets, which allows crossing beneath an outer-layer line on the opposite outer layer. It was used only on scratch boards here.

## 8. D7 ruling: FLY_PGOOD → U501.28 deferred into a coordinated U501 fan-out review (11 Oct 2026; no copper change)

**Owner ruling (summary of the 11 Oct instruction):**
- Defer the FLY_PGOOD → U501.28 fix, and fold it into a complete review of the U501 fan-out for pins 24–38.
- Make no copper change now. Preserve the current PCB and every routing checkpoint.
- Keep FLY_PGOOD → U501.28, PMD_READY_M and MAIN_SWCLK unconnected.
- Wait for the official ST MCU datasheet and the relevant RF application and layout documentation before redesigning the fan-out.
- Do not assume that a B.Cu crossing under RF_ANT is acceptable. It needs an electromagnetic and layout review first.
- Remove the duplicated LED_MAIN segments and the zero-length RS485_RO segment only as part of a controlled, reviewed cleanup.
- Do not move FLY_PGOOD to another MCU pin without explicit owner approval of the schematic and firmware/CubeMX change, after the alternatives have been reviewed.
- D8 stays blocked until PB15 voltage tolerance and the PMD401 output voltage are confirmed. D9 stays blocked until the crystal and SWD layout review.

The board is unchanged from `route-stage5a-done`, and its status is unchanged (§7.5): incomplete, electrically untested, NOT fabrication-ready.

### 8.1 Deferred connections

| Connection | Ratsnest gap (mm) | Blocker | Needed to unblock |
|---|---|---|---|
| FLY_PGOOD U301.11 – U501.28 | 41.7 | Pin 28 has no legal escape in the current fan-out (§7). The only scratch route found crosses under RF_ANT on B.Cu (not accepted without review), is about 70 mm long and uses 4 vias. | DS14127 and the ST RF layout guidance (AN5948), then the §8.3 review and owner approval of the proposed geometry |
| PMD_READY_M U501.33 – R706.1 | 36.3 | **D8:** PB15 voltage tolerance not verified (U-10). The PMD401 Ready output has a "~20k pull-up", but the manual does not state the rail. | DS14127 PB15 I/O structure, **and** a PiezoMotor statement of the Ready output high level or pull-up rail |
| MAIN_SWCLK track – U501.26 | 7.0 | **D9:** completion depends on the crystal layout and the existing J502 SWD stub | Crystal (HSE/LSE) layout from the ST documents, then a joint crystal and SWD review |

### 8.2 Scope: U501 pins 24–38 (nets read from the PCB at `route-stage5a-done`)

| Pin | Net | Current state (PCB) | Point to settle in the review |
|---|---|---|---|
| 24 | MAIN_SWO | Routed; F.Cu vertical at x ≈ 155.81 forms the pocket's outer wall | Whether its run can move outward to widen the pocket |
| 25 | (PA15, no connection) | Unused | Free space only; using it for a signal is a pin-map change (see §8.5) |
| 26 | MAIN_SWCLK | **Unconnected** at the pin; a J502 SWD stub exists | D9 |
| 27 | MAIN_SWDIO | Routed; escape passes 0.274 mm from the pin 28 pad | Escape order next to pin 28 |
| 28 | FLY_PGOOD | **Unconnected** (D7) | Escape, via position, layer change, and route past or under the RF feed |
| 29 | RS485_RO | Routed: F.Cu diagonal to x = 153.045, via at about (153.23, 124.89), then B.Cu along y = 124.93 under RF_ANT | Re-fan; review the existing RF crossing |
| 30 | LED_MAIN | Routed: F.Cu diagonal to x = 153.60, via at about (153.60, 121.93), B.Cu, then F.Cu at x = 159.7 | Re-fan |
| 31 | RS485_DE | Routed; escape via at (152.81, 119.36), directly in front of pin 29 | Via position (root cause, §7.2) |
| 32 | RS485_DI | Routed; escape via at (152.68, 118.12), directly in front of pin 30 | Via position (root cause, §7.2) |
| 33 | PMD_READY_M | **Unconnected** (D8) | Reserve an escape path even while D8 is blocked |
| 34 | MAIN_BOOT0 | Routed; diagonal, then F.Cu vertical at x ≈ 154.15 | Part of the pocket's top and wall |
| 35 | +3V3 | Supply pin | Decoupling placement per DS14127; must not be lengthened by the re-fan |
| 36 | MAIN_NRST | Routed; diagonal, then F.Cu vertical at x ≈ 154.53 | Part of the pocket's top and wall |
| 37 | RF_MCU | **Unconnected** at the pin (placeholder RF match L502 → J501, U-20) | RF feed geometry from AN5948 and the stack-up |
| 38 | WBA_VDDHPA | Routed placeholder; F.Cu vertical at x ≈ 155.16 | Supply topology from DS14127 (D5) |

Pins 39 (WBA_VDDANA) and 40 (WBA_VDDRF) are outside the requested range, but they sit beside pins 37 and 38 and share the same supply blocker. The review should look at them at the same time.

### 8.3 Review method (to be run when the documents arrive)

Evaluate everything together, not net by net:
1. **Pin escape order.** Choose one order for pins 24–38 that gives every pin, including 28 and 33, an exit. Treat the RS485_DE and RS485_DI escape vias in front of pins 29 and 30 as movable.
2. **Via placement.** Keep vias out of the pin fronts and out of pads. Check each against the 0.15 mm rule and against the planes (In1 GND, In2 +3V3 in this area).
3. **Layer transitions.** Count the vias per net. Every transition must keep a continuous reference plane.
4. **RF clearances.** Lay out the RF feed (RF_MCU → match → J501) to AN5948 and the stack-up (U-20) **first**, then route around it.
   - Do not assume a B.Cu crossing under RF_ANT is acceptable. Look at the crossing angle, the distance to the matching network, the reference-plane continuity, and the ST guidance on routing near the RF line.
   - The **nine existing B.Cu crossings** under RF_ANT (§7.2) go into the same review. They have not been accepted either.
5. **Switching-sensitive routes.** Check against:
   - the kill-path nets (FLY_PGOOD, FLY_EN, SUP_PARK);
   - the WBA55 SMPS inductor and supply placeholders (L501, VDD11);
   - the HSE and LSE crystals;
   - HB_S2M, which already passes 0.60 mm from Y502 pad 1 (§5 note).
6. **Deliverable before any copper change:**
   - the proposed geometry, the affected nets and the clearance measurements;
   - a DRC (with parity) of a scratch copy;
   - `compare_stage.py` against `route-stage5a-done`.

   The owner approves this before anything goes onto the project PCB. It is applied under new `route-u501fanout-before` / `-done` tags.

### 8.4 Controlled cleanup of leftover segments (part of the reviewed change, not applied)

The PCB at `route-stage5a-done` contains these segments:

| Net | Layer | Segment | Length | Note |
|---|---|---|---|---|
| LED_MAIN | F.Cu | (151.438, 119.25) → (151.57, 119.25) | 0.132 mm | Duplicate pair: the same segment also exists reversed, (151.57, 119.25) → (151.438, 119.25). Both lie on the pin 30 stub. |
| RS485_RO | F.Cu | (151.438, 119.75) → (151.438, 119.75) | about 0.001 mm | Zero-length segment at the pin 29 pad centre |
| RS485_RO | F.Cu / B.Cu | 0.017 mm and 0.052 mm jogs at the via near (153.23, 124.89) | — | Functional short jogs, not duplicates. Listed for review only. |

**Procedure:**
1. `route_stage.py remove_tracks` asserts exactly one match per segment, so it cannot remove one copy of an identical pair. A duplicate-aware removal mode, matching either direction and removing one copy, is needed. That script change is itself part of the review.
2. After removal, verify that U501.29 and U501.30 still connect to their nets, that the unconnected count is still 48, and that DRC still shows 0 copper violations and 0 parity issues.
3. Run `compare_stage.py` against `route-stage5a-done`.
4. Commit separately, or inside the fan-out change, as the owner prefers.

### 8.5 Moving FLY_PGOOD to another pin

Not done and not evaluated. It would change the schematic and the pin map, and it would need:
- a written list of the alternative pins;
- a CubeMX check (`scripts/verify_pinmap.py`);
- firmware review;
- explicit owner approval.

PA15 (pin 25) is the only unused pin in this range. It is mentioned here as a fact, not as a proposal.

### 8.6 Documents and decisions still needed

**Documents:**
- **DS14127 (STM32WBA55 datasheet):** PB15 I/O structure (D8); supply requirements for pins 35, 38, 39 and 40 (D5, U-05); HSE/LSE pin and crystal requirements (D9).
- **AN5948 (ST RF application and layout guidance) and the stack-up (U-20):** RF feed geometry, and whether and how signals may cross or run near it.
- **RM0493, ES0592, the NUCLEO schematic and UM3301:** for the remaining WBA55 supply and RF items (U-05). Not needed for the escape order itself.
- **PiezoMotor:** the PMD401 Ready output high level or pull-up rail (D8).

**Owner decisions after the documents arrive:**
- approve or reject the proposed pin 24–38 fan-out geometry (§8.3);
- accept or reject any B.Cu crossing under the RF feed, existing or new;
- approve the leftover-segment cleanup and the `remove_tracks` duplicate mode (§8.4);
- D9: whether the J502 SWD stub may be re-routed;
- optionally, a decision on reviewing alternative FLY_PGOOD pins (§8.5).
