BigBiglinn/INSULIN_PUMP/docs/handover/images/pcb_placement_fab.png

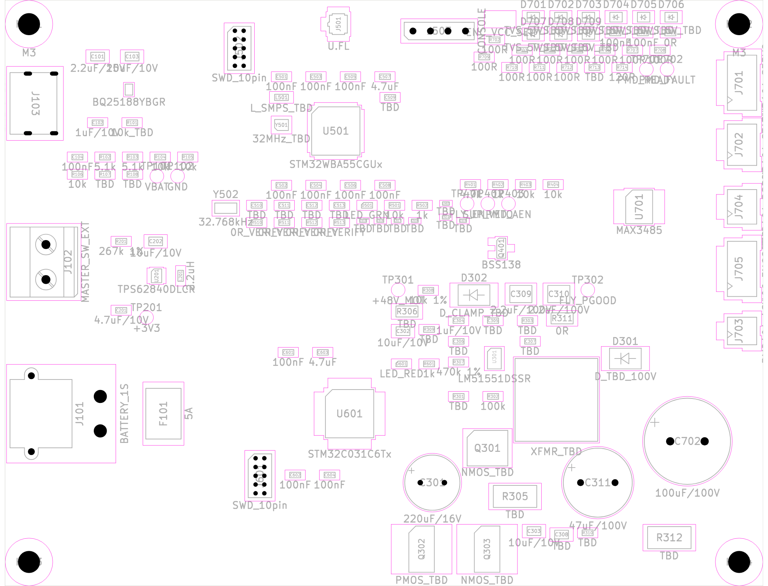
docs/handover/images/pcb_placement_fab.png
