BigBiglinn/INSULIN_PUMP/docs/handover/images/pcb_routed_top_bottom.png

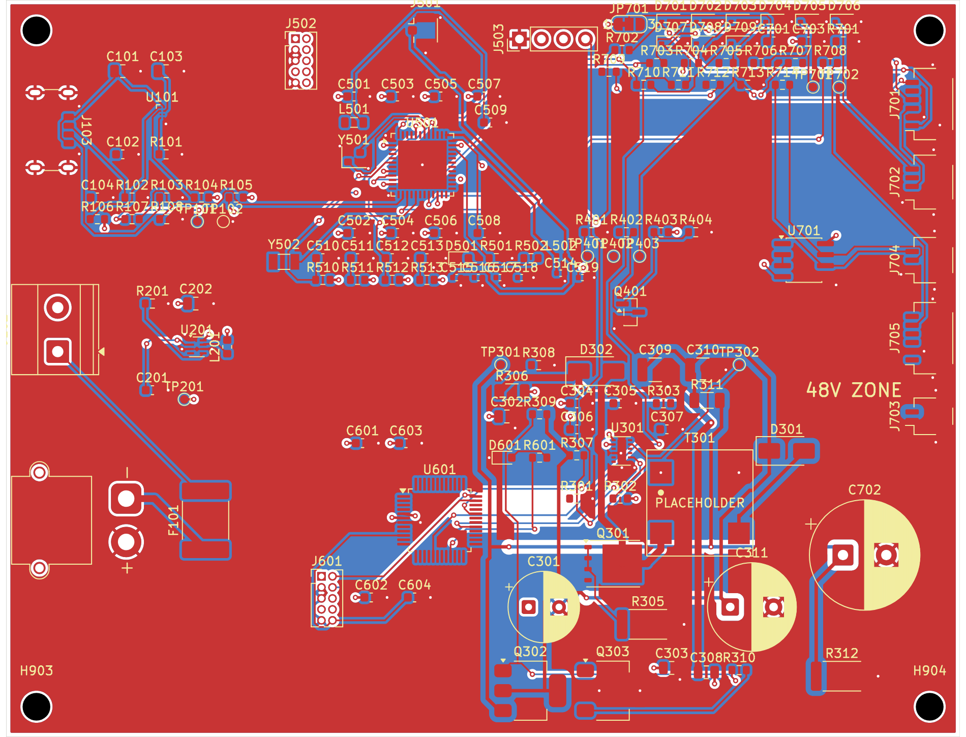
docs/handover/images/pcb_routed_top_bottom.png
