BigBiglinn/INSULIN_PUMP/docs/report_assets/board_3d_bottom.png

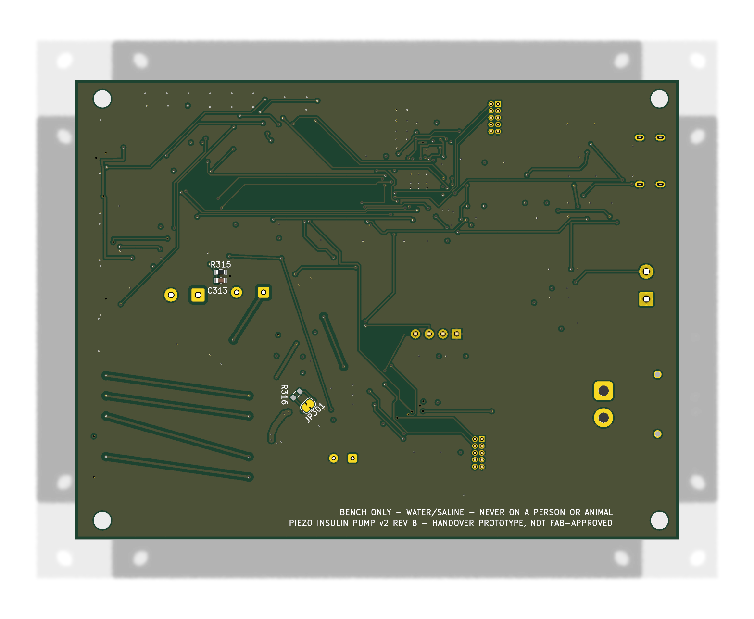
docs/report_assets/board_3d_bottom.png
