BigBiglinn/INSULIN_PUMP/docs/report_assets/board_3d_top.png

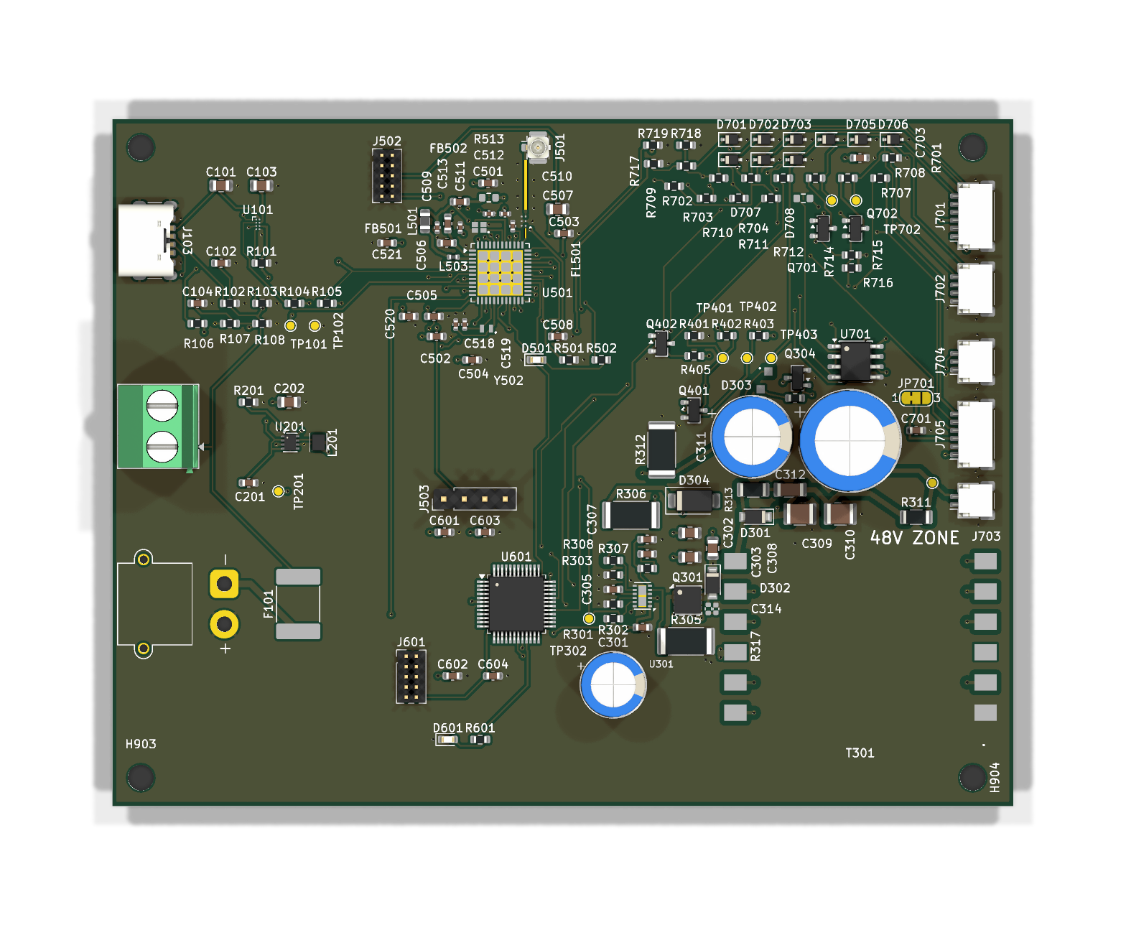
docs/report_assets/board_3d_top.png
