BigBiglinn/INSULIN_PUMP/docs/bom.csv

Refs | Value | Footprint | MPN | Status | Qty | DNP
C101 | 2.2uF/25V | Capacitor_SMD:C_0805_2012Metric |  | DS | 1
C102 | 1uF/10V | Capacitor_SMD:C_0603_1608Metric |  | DS | 1
C103,C202,C507 | 10uF/10V | Capacitor_SMD:C_0805_2012Metric |  | DS | 3
C104 | 100nF | Capacitor_SMD:C_0603_1608Metric |  | CALC | 1
C201 | 4.7uF/10V | Capacitor_SMD:C_0603_1608Metric |  | DS | 1
C301 | 220uF/16V | Capacitor_THT:CP_Radial_D8.0mm_P3.50mm |  | DECIDED | 1
C302,C303 | 10uF/10V X5R | Capacitor_SMD:C_0805_2012Metric |  | CALC | 2
C304 | 2.2uF/10V | Capacitor_SMD:C_0603_1608Metric |  | DS | 1
C305 | 1uF/10V X7R | Capacitor_SMD:C_0603_1608Metric |  | CALC | 1
C306 | 180nF | Capacitor_SMD:C_0603_1608Metric |  | CALC | 1
C307 | 3.3nF | Capacitor_SMD:C_0603_1608Metric |  | CALC | 1
C308 | 100nF/50V X7R | Capacitor_SMD:C_0805_2012Metric |  | CALC | 1
C309,C310 | 2.2uF/100V X7R | Capacitor_SMD:C_1210_3225Metric |  | CALC | 2
C311 | 47uF/100V | Capacitor_THT:CP_Radial_D10.0mm_P5.00mm |  | DECIDED | 1
C312 | 100pF/250V C0G | Capacitor_SMD:C_1206_3216Metric |  | CALC | 1
C313 | 10nF | Capacitor_SMD:C_0603_1608Metric |  | CALC | 1
C314 | TBD | Capacitor_SMD:C_0402_1005Metric |  | PLACEHOLDER | 1 | DNP
C501,C502,C503,C504,C601,C602,C604,C701,C703 | 100nF | Capacitor_SMD:C_0603_1608Metric |  | ASSUMED | 9
C505,C508 | 100nF | Capacitor_SMD:C_0603_1608Metric |  | DS | 2
C506 | 10uF/10V | Capacitor_SMD:C_0603_1608Metric | Murata GRM188C81A106MA73 | DS | 1
C509 | 4.7uF | Capacitor_SMD:C_0402_1005Metric | Murata GRM155R60J475ME47D | DS | 1
C510 | 470nF | Capacitor_SMD:C_0402_1005Metric |  | DS | 1
C511,C512,C513 | 100nF | Capacitor_SMD:C_0402_1005Metric |  | DS | 3
C518,C519 | 6pF C0G | Capacitor_SMD:C_0402_1005Metric |  | DS | 2
C520,C521 | 1uF | Capacitor_SMD:C_0603_1608Metric |  | DS | 2
C603 | 4.7uF | Capacitor_SMD:C_0603_1608Metric |  | ASSUMED | 1
C702 | 100uF/100V | Capacitor_THT:CP_Radial_D12.5mm_P5.00mm |  | DECIDED | 1
D301 | PNE20010ER | Diode_SMD:Nexperia_CFP3_SOD-123W | Nexperia PNE20010ER | DS | 1
D302 | PMEG10020ELR | Diode_SMD:Nexperia_CFP3_SOD-123W | Nexperia PMEG10020ELR | DS | 1
D303 | BZX84B51 | pump_v2:SOT-23_Zener_A1_K3 | Vishay BZX84B51-E3-08 | CALC | 1
D304 | SMAJ15A | Diode_SMD:D_SMA | Littelfuse SMAJ15A | CALC | 1
D501 | LED_GRN | LED_SMD:LED_0603_1608Metric |  | ASSUMED | 1
D601 | LED_RED | LED_SMD:LED_0603_1608Metric |  | ASSUMED | 1
D701,D702,D703,D704,D705,D706,D707,D708,D709 | PESD5V0S1BA | Diode_SMD:D_SOD-323 | Nexperia PESD5V0S1BA,115 | DS | 9
F101 | 5A | Fuse:Fuse_2920_7451Metric |  | TBD | 1
FB501,FB502 | 47R@100MHz | Capacitor_SMD:C_0603_1608Metric | Taiyo Yuden LSMGA160808T470RG | DS | 2
FL501 | MLPF-WB-04D3 | pump_v2:ST_MLPF-WB-04D3 | ST MLPF-WB-04D3 | DS | 1
J101 | BATTERY_1S | Connector_AMASS:AMASS_XT30PW-M_1x02_P2.50mm_Horizontal | AMASS XT30PW-M | ASSUMED | 1
J102 | MASTER_SW_EXT | TerminalBlock_Phoenix:TerminalBlock_Phoenix_MKDS-1,5-2-5.08_1x02_P5.08mm_Horizontal |  | ASSUMED | 1
J103 | USB_C_PWR | Connector_USB:USB_C_Receptacle_GCT_USB4125-xx-x_6P_TopMnt_Horizontal | GCT USB4125 | ASSUMED | 1
J501 | U.FL | Connector_Coaxial:U.FL_Hirose_U.FL-R-SMT-1_Vertical | Hirose U.FL-R-SMT-1 | ASSUMED | 1
J502,J601 | SWD_10pin | Connector_PinHeader_1.27mm:PinHeader_2x05_P1.27mm_Vertical |  | ASSUMED | 2
J503 | CONSOLE | Connector_PinHeader_2.54mm:PinHeader_1x04_P2.54mm_Vertical |  | ASSUMED | 1
J701 | PMD401_SERVO | Connector_JST:JST_SH_SM06B-SRSS-TB_1x06-1MP_P1.00mm_Horizontal | JST SM06B-SRSS-TB | DS | 1
J702 | PMD401_STATUS | Connector_JST:JST_SH_SM04B-SRSS-TB_1x04-1MP_P1.00mm_Horizontal | JST SM04B-SRSS-TB | DS | 1
J703 | PMD401_48V | Connector_JST:JST_SH_SM02B-SRSS-TB_1x02-1MP_P1.00mm_Horizontal | JST SM02B-SRSS-TB | DS | 1
J704 | PMD401_RS485 | Connector_JST:JST_SH_SM03B-SRSS-TB_1x03-1MP_P1.00mm_Horizontal | JST SM03B-SRSS-TB | DS | 1
J705 | LL06_ENCODER | Connector_JST:JST_SH_SM06B-SRSS-TB_1x06-1MP_P1.00mm_Horizontal | JST SM06B-SRSS-TB | ASSUMED | 1
JP301 | BRIDGED | Jumper:SolderJumper-2_P1.3mm_Bridged_RoundedPad1.0x1.5mm |  | CALC | 1
JP701 | ENC_VCC_SEL | Jumper:SolderJumper-3_P1.3mm_Bridged12_RoundedPad1.0x1.5mm_NumberLabels |  | ASSUMED | 1
L201 | 2.2uH | Inductor_SMD:L_Murata_DFE201610P | Murata DFE201612E-2R2M=P2 | DS | 1
L501 | 2.2uH | Inductor_SMD:L_0805_2012Metric | Murata LQM21PN2R2MGH | DS | 1
L503 | 10nH | Inductor_SMD:L_0402_1005Metric | Murata LQG15HS10NJ02D | DS | 1
Q301 | AONR34332C | Package_SON:VSON-8_3.3x3.3mm_P0.65mm_NexFET | AOS AONR34332C | DS | 1
Q304 | BSS138 | Package_TO_SOT_SMD:SOT-23 | BSS138 (e.g. Nexperia BSS138P) | CALC | 1
Q401 | BSS138 | Package_TO_SOT_SMD:SOT-23 | BSS138 | DECIDED | 1
Q402 | BSS138 | Package_TO_SOT_SMD:SOT-23 | BSS138 (e.g. Nexperia BSS138P) | DECIDED | 1
Q701,Q702 | BSS138 | Package_TO_SOT_SMD:SOT-23 | BSS138 (e.g. Nexperia BSS138P) | DS | 2
R101,R104,R105,R106 | 10k | Resistor_SMD:R_0603_1608Metric |  | DS | 4
R102,R103 | 5.1k | Resistor_SMD:R_0603_1608Metric |  | ASSUMED | 2
R107,R108 | 200k 1% | Resistor_SMD:R_0603_1608Metric |  | CALC | 2
R201 | 267k 1% | Resistor_SMD:R_0603_1608Metric |  | DS | 1
R301 | 73.2k 1% | Resistor_SMD:R_0603_1608Metric |  | CALC | 1
R302 | 100k | Resistor_SMD:R_0603_1608Metric |  | ASSUMED | 1
R303 | 3.01k 1% | Resistor_SMD:R_0603_1608Metric |  | CALC | 1
R305 | 22m 1% 1W | Resistor_SMD:R_2512_6332Metric |  | CALC | 1
R306 | 330R 1W | Resistor_SMD:R_2512_6332Metric |  | CALC | 1
R307 | 470k 0.1% | Resistor_SMD:R_0603_1608Metric |  | CALC | 1
R308 | 10k 0.1% | Resistor_SMD:R_0603_1608Metric |  | CALC | 1
R311 | 0R | Resistor_SMD:R_1206_3216Metric |  | ASSUMED | 1
R312 | 10k 1% 1W | Resistor_SMD:R_2512_6332Metric |  | CALC | 1
R313 | 220R 1206 | Resistor_SMD:R_1206_3216Metric |  | CALC | 1
R314,R702,R703,R704 | 1k | Resistor_SMD:R_0603_1608Metric |  | CALC | 4
R315 | 10k | Resistor_SMD:R_0603_1608Metric |  | CALC | 1
R316 | TBD | Resistor_SMD:R_0603_1608Metric |  | PLACEHOLDER | 1 | DNP
R317 | TBD | Resistor_SMD:R_0402_1005Metric |  | PLACEHOLDER | 1 | DNP
R401 | 4.7k | Resistor_SMD:R_0603_1608Metric |  | DECIDED | 1
R402 | 1k | Resistor_SMD:R_0603_1608Metric |  | DECIDED | 1
R403,R405 | 10k | Resistor_SMD:R_0603_1608Metric |  | DECIDED | 2
R501 | 10k | Resistor_SMD:R_0603_1608Metric |  | ASSUMED | 1
R502,R601 | 1k | Resistor_SMD:R_0603_1608Metric |  | ASSUMED | 2
R513 | 0R | Resistor_SMD:R_0603_1608Metric |  | DS | 1 | DNP
R701 | 0R | Resistor_SMD:R_0603_1608Metric |  | ASSUMED | 1
R705,R706,R707,R708,R709,R710,R711,R712 | 100R | Resistor_SMD:R_0603_1608Metric |  | DECIDED | 8
R714 | 120R | Resistor_SMD:R_0603_1608Metric |  | ASSUMED | 1 | DNP
R715,R716 | 100k | Resistor_SMD:R_0603_1608Metric |  | CALC | 2
R717,R719 | 15k | Resistor_SMD:R_0603_1608Metric |  | CALC | 2
R718 | 33k | Resistor_SMD:R_0603_1608Metric |  | CALC | 1
T301 | HPH6-0090L | pump_v2:Coilcraft_HPH6 | Coilcraft HPH6-0090L | DS | 1
U101 | BQ25188YBGR | pump_v2:TI_YBG0008_DSBGA-8_P0.4mm_UNVERIFIED | BQ25188YBGR | DECIDED | 1
U201 | TPS62840DLCR | Package_SON:Texas_VSON-HR-8_1.5x2mm_P0.5mm | TPS62840DLCR | DECIDED | 1
U301 | LM51551DSSR | Package_SON:WSON-12-1EP_3x2mm_P0.5mm_EP1x2.65 | LM51551DSSR | DECIDED | 1
U501 | STM32WBA55CGUx | Package_DFN_QFN:QFN-48-1EP_7x7mm_P0.5mm_EP5.6x5.6mm | STM32WBA55CGU6 (temp suffix TBD) | DECIDED | 1
U601 | STM32C031C6Tx | Package_QFP:LQFP-48_7x7mm_P0.5mm | STM32C031C6T6 (package ASSUMED) | DECIDED | 1
U701 | MAX3485 | Package_SO:SOIC-8_3.9x4.9mm_P1.27mm | MAX3485 SOIC-8 (suffix TBD) | DECIDED | 1
Y501 | 32MHz | pump_v2:Crystal_NX1612SA | NDK NX1612SA-32MHZ-EXS00A-CS09166 | DS | 1
Y502 | 32.768kHz | pump_v2:Crystal_NX1610SE | NDK NX1610SE-32.768KHZ-EXS00A-MU01501 | DS | 1
