BigBiglinn/INSULIN_PUMP/validation/logs/pinmap_check.md

# MCU pin-map check against STM32CubeMX database

Database: `C:\Users\cherr/AppData/Local/Programs/STM32CubeMX/db/mcu` (STM32CubeMX 6.18.1). Generated by `scripts/verify_pinmap.py`.

This checks that each assigned function exists on that package pin in ST's data, and that
no signal is used twice. It does not check clock trees, peripheral conflicts at run time,
5 V tolerance, or electrical ratings (ST datasheet still required).

## U501 STM32WBA55CGUx

| Pin | CubeMX name | Type | Net | Intended | Result |
| --- | --- | --- | --- | --- | --- |
| 1 | VSSSMPS | Power | `GND` |  | power pin |
| 2 | VDDSMPS | Power | `WBA_VDDSMPS` |  | power pin |
| 3 | VLXSMPS | Power | `WBA_VLXSMPS` |  | power pin |
| 4 | PB12 | I/O | `CON_MAIN_TX` | USART1_TX | OK |
| 5 | PA8 | I/O | `ENC_B_M` | TIM2_CH2 | OK |
| 6 | PA7 | I/O | `I2C_SDA` | I2C3_SDA | OK |
| 7 | PA6 | I/O | `I2C_SCL` | I2C3_SCL | OK |
| 8 | VDDA | Power | `+3V3` |  | power pin |
| 9 | PA5 | I/O | `PMD_SS_M` | SPI3_NSS | OK |
| 10 | PA2 | I/O | `CHG_INT_N` | GPIO | OK |
| 11 | VDD | Power | `+3V3` |  | power pin |
| 12 | PA1 | I/O | `HB_S2M` | LPUART1_RX | OK |
| 13 | PA0 | I/O | `PMD_SCLK_M` | SPI3_SCK | OK |
| 14 | PB9 | I/O | `VBAT_SENSE` | ADC4_IN10 | OK |
| 15 | PB8 | I/O | `PMD_MOSI_M` | SPI3_MOSI | OK |
| 16 | PC15-OSC32_OUT | I/O | `LSE_OUT` | RCC_OSC32_OUT | OK |
| 17 | PC14-OSC32_IN | I/O | `LSE_IN` | RCC_OSC32_IN | OK |
| 18 | PC13 | I/O | `NC` |  | no function claimed |
| 19 | PB7 | I/O | `MCU_48V_EN` | GPIO | OK |
| 20 | PB6 | I/O | `ENC_A_M` | TIM2_CH1 | OK |
| 21 | PB5 | I/O | `HB_M2S` | LPUART1_TX | OK |
| 22 | VDD | Power | `+3V3` |  | power pin |
| 23 | PB4 (NJTRST) | I/O | `PMD_FAULT_M` | GPIO | OK |
| 24 | PB3 (JTDO/TRACESWO) | I/O | `MAIN_SWO` | DEBUG_JTDO-SWO | OK |
| 25 | PA15 (JTDI) | I/O | `NC` |  | no function claimed |
| 26 | PA14 (JTCK/SWCLK) | I/O | `MAIN_SWCLK` | DEBUG_JTCK-SWCLK | OK |
| 27 | PA13 (JTMS/SWDIO) | I/O | `MAIN_SWDIO` | DEBUG_JTMS-SWDIO | OK |
| 28 | PA12 | I/O | `FLY_PGOOD` | GPIO | OK |
| 29 | PA11 | I/O | `RS485_RO` | USART2_RX | OK |
| 30 | PB2 | I/O | `LED_MAIN` | GPIO | OK |
| 31 | PB1 | I/O | `RS485_DE` | USART2_DE | OK |
| 32 | PB0 | I/O | `RS485_DI` | USART2_TX | OK |
| 33 | PB15 | I/O | `PMD_READY_M` | GPIO | OK |
| 34 | PH3-BOOT0 | I/O | `MAIN_BOOT0` | GPIO | OK |
| 35 | VDD | Power | `+3V3` |  | power pin |
| 36 | NRST | Reset | `MAIN_NRST` | <Reset> | OK |
| 37 | RF | MonoIO | `RF_MCU` | <MonoIO> | OK |
| 38 | VDDHPA | Power | `WBA_VDDHPA` |  | power pin |
| 39 | VDDANA | Power | `WBA_VDD11` |  | power pin |
| 40 | VDDRF | Power | `+3V3` |  | power pin |
| 41 | OSC_OUT | I/O | `HSE_OUT` |  | unchecked |
| 42 | OSC_IN | I/O | `HSE_IN` |  | unchecked |
| 43 | VDDRFPA | Power | `WBA_VDDRFPA` |  | power pin |
| 44 | VDD | Power | `+3V3` |  | power pin |
| 45 | VDD11 | Power | `WBA_VDD11` |  | power pin |
| 46 | PA10 | I/O | `NC` |  | no function claimed |
| 47 | PA9 | I/O | `NC` |  | no function claimed |
| 48 | PB14 | I/O | `ENC_I_M` | GPIO | OK |
| 49 | VSS (exposed pad) | Power | `GND` |  | power pin |

## U601 STM32C031C(4-6)Tx

| Pin | CubeMX name | Type | Net | Intended | Result |
| --- | --- | --- | --- | --- | --- |
| 1 | PC13 | I/O | `NC` |  | no function claimed |
| 2 | PC14-OSCX_IN (PC14) | I/O | `NC` |  | no function claimed |
| 3 | PC15-OSCX_OUT (PC15) | I/O | `NC` |  | no function claimed |
| 4 | PF3 | I/O | `NC` |  | no function claimed |
| 5 | VREF+ | MonoIO | `+3V3` |  | unchecked |
| 6 | VDD/VDDA | Power | `+3V3` |  | power pin |
| 7 | VSS/VSSA | Power | `GND` |  | power pin |
| 8 | PF0-OSC_IN (PF0) | I/O | `NC` |  | no function claimed |
| 9 | PF1-OSC_OUT (PF1) | I/O | `NC` |  | no function claimed |
| 10 | PF2-NRST | I/O | `SUP_NRST` | <NRST> | OK |
| 11 | PA0 | I/O | `NC` |  | no function claimed |
| 12 | PA1 | I/O | `NC` |  | no function claimed |
| 13 | PA2 | I/O | `HB_S2M` | USART2_TX | OK |
| 14 | PA3 | I/O | `HB_M2S` | USART2_RX | OK |
| 15 | PA4 | I/O | `NC` |  | no function claimed |
| 16 | PA5 | I/O | `NC` |  | no function claimed |
| 17 | PA6 | I/O | `ENC_A_S` | TIM3_CH1 | OK |
| 18 | PA7 | I/O | `ENC_B_S` | TIM3_CH2 | OK |
| 19 | PB0 | I/O | `SUP_VETO` | GPIO | OK |
| 20 | PB1 | I/O | `SUP_PARK` | GPIO | OK |
| 21 | PB2 | I/O | `LED_SUP` | GPIO | OK |
| 22 | PB10 | I/O | `NC` |  | no function claimed |
| 23 | PB11 | I/O | `NC` |  | no function claimed |
| 24 | PB12 | I/O | `NC` |  | no function claimed |
| 25 | PB13 | I/O | `NC` |  | no function claimed |
| 26 | PB14 | I/O | `NC` |  | no function claimed |
| 27 | PB15 | I/O | `NC` |  | no function claimed |
| 28 | PA8 | I/O | `NC` |  | no function claimed |
| 29 | PA9/NC | I/O | `CON_SUP_TX` | USART1_TX | OK |
| 30 | PC6 | I/O | `NC` |  | no function claimed |
| 31 | PC7 | I/O | `NC` |  | no function claimed |
| 32 | PA10/NC | I/O | `CON_SUP_RX` | USART1_RX | OK |
| 33 | PA11 [PA9]/PA9 [PA11] | I/O | `NC` |  | no function claimed |
| 34 | PA12 [PA10]/PA10 [PA12] | I/O | `NC` |  | no function claimed |
| 35 | PA13 | I/O | `SUP_SWDIO` | DEBUG_SWDIO | OK |
| 36 | PA14-BOOT0 | I/O | `SUP_SWCLK` | DEBUG_SWCLK | OK |
| 37 | PA15 | I/O | `NC` |  | no function claimed |
| 38 | PD0 | I/O | `NC` |  | no function claimed |
| 39 | PD1 | I/O | `NC` |  | no function claimed |
| 40 | PD2 | I/O | `NC` |  | no function claimed |
| 41 | PD3 | I/O | `NC` |  | no function claimed |
| 42 | PB3 | I/O | `NC` |  | no function claimed |
| 43 | PB4 | I/O | `NC` |  | no function claimed |
| 44 | PB5 | I/O | `NC` |  | no function claimed |
| 45 | PB6 | I/O | `NC` |  | no function claimed |
| 46 | PB7 | I/O | `NC` |  | no function claimed |
| 47 | PB8 | I/O | `NC` |  | no function claimed |
| 48 | PB9 | I/O | `NC` |  | no function claimed |

**Result: 0 failing assignment(s).**
