BigBiglinn/INSULIN_PUMP/validation/logs/unrouted_reconciliation.md

# Unconnected-pair reconciliation (generated by scripts/reconcile_unrouted.py)

Current DRC: 48 pairs. Baseline (tag baseline-routing-e8d141c): 35 pairs.

| Group | Pairs | Nets |
|---|---|---|
| W: WBA55-related, waiting for the ST documents | 12 | 8 |
| P: Placeholder or intentionally unfitted endpoint (DNP / PLACEHOLDER part) | 11 | 7 |
| R: Opened by the approved placement rip-up | 15 | 8 |
| G: Genuine missing connections that existed before the placement change | 10 | 9 |

## W. WBA55-related, waiting for the ST documents (12 pairs)

| Net | Gap mm | End A | End B | Flags | Net ripped | Baseline pairs on net |
|---|---|---|---|---|---|---|
| HSE_IN | 9.4 | U501.42 | Y501.1 | - | no | 2 |
| HSE_IN | 17.8 | C516.1 | U501.42 | C516:DNP C516:PLACEHOLDER | no | 2 |
| HSE_OUT | 8.2 | U501.41 | Y501.3 | - | no | 2 |
| HSE_OUT | 18.6 | C517.1 | U501.41 | C517:DNP C517:PLACEHOLDER | no | 2 |
| LSE_IN | 15.9 | C518.1 | U501.17 | C518:DNP C518:PLACEHOLDER | no | 2 |
| LSE_IN | 16.0 | U501.17 | Y502.1 | Y502:DNP Y502:PLACEHOLDER | no | 2 |
| RF_MCU | 16.5 | Track [/Main MCU STM32WBA55/RF | U501.37 | - | no | 1 |
| WBA_VDD11 | 5.7 | L501.2 | U501.45 | L501:PLACEHOLDER | no | 2 |
| WBA_VDD11 | 8.5 | U501.45 | C509.1 | C509:PLACEHOLDER | no | 2 |
| WBA_VDDANA | 19.1 | Track [/Main MCU STM32WBA55/WB | U501.39 | - | no | 1 |
| WBA_VDDRF | 16.9 | Track [/Main MCU STM32WBA55/WB | U501.40 | - | no | 1 |
| WBA_VDDRFPA | 13.7 | Track [/Main MCU STM32WBA55/WB | Track [/Main MCU STM32WBA55/WB | - | no | 1 |

## P. Placeholder or intentionally unfitted endpoint (DNP / PLACEHOLDER part) (11 pairs)

| Net | Gap mm | End A | End B | Flags | Net ripped | Baseline pairs on net |
|---|---|---|---|---|---|---|
| +48V_MOT | 20.7 | TP301.1 | R312.1 | R312:DNP R312:PLACEHOLDER | yes | 2 |
| +48V_MOT | 45.6 | R312.1 | Q302.3 | Q302:DNP Q302:PLACEHOLDER R312:DNP R312:PLACEHOLDER | yes | 2 |
| +48V_RAW | 5.7 | R311.1 | R309.2 | R309:DNP R309:PLACEHOLDER | yes | 0 |
| +48V_RAW | 6.3 | Q302.2 | Q302.2 | Q302:DNP Q302:PLACEHOLDER | yes | 0 |
| +48V_RAW | 19.0 | Q302.2 | PTH pad 1 [/48V flyback/+48V_R | Q302:DNP Q302:PLACEHOLDER | yes | 0 |
| +48V_RAW | 25.2 | Q302.2 | R307.1 | Q302:DNP Q302:PLACEHOLDER | yes | 0 |
| FLY_EN | 44.8 | Track [FLY_EN] on B.Cu, length | Q303.1 | Q303:DNP Q303:PLACEHOLDER | yes | 0 |
| FLY_SEC | 3.2 | D301.2 | T301.4 | T301:PLACEHOLDER | yes | 0 |
| FLY_SW | 3.9 | T301.2 | D302.2 | T301:PLACEHOLDER | yes | 0 |
| RS485_B | 21.2 | R714.2 | Track [/PMD401 & encoder inter | R714:DNP | no | 1 |
| SW48_GATE | 21.8 | R309.1 | Track [/48V flyback/SW48_GATE] | R309:DNP R309:PLACEHOLDER | no | 1 |

## R. Opened by the approved placement rip-up (15 pairs)

| Net | Gap mm | End A | End B | Flags | Net ripped | Baseline pairs on net |
|---|---|---|---|---|---|---|
| +48V_MOT | 3.9 | J703.2 | TP301.1 | - | yes | 2 |
| +48V_MOT | 4.0 | R311.2 | J703.2 | - | yes | 2 |
| +48V_MOT | 8.5 | PTH pad 1 [+48V_MOT] of C702 | R311.2 | - | yes | 2 |
| +48V_RAW | 2.1 | D301.1 | C312.2 | - | yes | 0 |
| +48V_RAW | 3.5 | C310.1 | C309.1 | - | yes | 0 |
| +48V_RAW | 3.5 | D301.1 | C310.1 | - | yes | 0 |
| +48V_RAW | 5.2 | C309.1 | R311.1 | - | yes | 0 |
| +48V_RAW | 16.4 | PTH pad 1 [/48V flyback/+48V_R | C312.2 | - | yes | 0 |
| CON_MAIN_TX | 29.3 | PTH pad 2 [/Main MCU STM32WBA5 | U501.4 | - | yes | 0 |
| FLY_CLAMP | 1.8 | C308.1 | D302.1 | - | yes | 0 |
| FLY_CLAMP | 8.2 | R306.1 | C308.1 | - | yes | 0 |
| FLY_PGOOD | 41.5 | U501.28 | Track [FLY_PGOOD] on F.Cu, len | - | yes | 2 |
| FLY_SEC | 2.1 | R313.1 | D301.2 | - | yes | 0 |
| FLY_SNUB | 2.8 | R313.2 | C312.1 | - | yes | 0 |
| FLY_SW | 3.7 | D302.2 | Q301.5 | - | yes | 0 |

## G. Genuine missing connections that existed before the placement change (10 pairs)

| Net | Gap mm | End A | End B | Flags | Net ripped | Baseline pairs on net |
|---|---|---|---|---|---|---|
| CHG_INT_N | 11.6 | U101.A1 | Track [CHG_INT_N] on F.Cu, len | - | no | 1 |
| ENC_I_M | 15.1 | U501.48 | Via [ENC_I_M] on F.Cu - B.Cu | - | no | 1 |
| I2C_SDA | 12.4 | U101.C1 | R105.1 | - | no | 2 |
| I2C_SDA | 19.3 | R105.1 | U501.6 | - | no | 2 |
| MAIN_SWCLK | 7.0 | Track [/Main MCU STM32WBA55/MA | U501.26 | - | no | 1 |
| PMD_MOSI_M | 26.0 | Track [PMD_MOSI_M] on B.Cu, le | R702.1 | - | no | 1 |
| PMD_READY_M | 36.3 | U501.33 | R706.1 | - | no | 1 |
| PMD_SCLK_M | 36.3 | U501.13 | R704.1 | - | no | 1 |
| VBAT_FUSED | 7.4 | U101.C2 | Track [/Power input & charger/ | - | no | 1 |
| VBAT_SENSE | 28.0 | Track [VBAT_SENSE] on F.Cu, le | Track [VBAT_SENSE] on F.Cu, le | - | no | 1 |

## Pads of every net that has an unconnected pair

| Net | Pads (part flags in brackets) |
|---|---|
| +48V_MOT | C702.1, J703.2, Q302.3 [DNP/PLACEHOLDER], R311.2, R312.1 [DNP/PLACEHOLDER], TP301.1 |
| +48V_RAW | C309.1, C310.1, C311.1, C312.2, D301.1, Q302.2 [DNP/PLACEHOLDER], Q302.2 [DNP/PLACEHOLDER], R307.1, R309.2 [DNP/PLACEHOLDER], R311.1 |
| CHG_INT_N | R106.1, U101.A1, U501.10 |
| CON_MAIN_TX | J503.2, U501.4 |
| ENC_I_M | R710.1, U501.48 |
| FLY_CLAMP | C308.1, D302.1, R306.1 |
| FLY_EN | Q303.1 [DNP/PLACEHOLDER], Q401.3, R401.1, R402.2, TP401.1, U301.12 |
| FLY_PGOOD | R302.1, TP302.1, U301.11, U501.28 |
| FLY_SEC | D301.2, R313.1, T301.4 [PLACEHOLDER] |
| FLY_SNUB | C312.1, R313.2 |
| FLY_SW | D302.2, Q301.5, T301.2 [PLACEHOLDER] |
| HSE_IN | C516.1 [DNP/PLACEHOLDER], U501.42, Y501.1 |
| HSE_OUT | C517.1 [DNP/PLACEHOLDER], U501.41, Y501.3 |
| I2C_SDA | R105.1, U101.C1, U501.6 |
| LSE_IN | C518.1 [DNP/PLACEHOLDER], U501.17, Y502.1 [DNP/PLACEHOLDER] |
| MAIN_SWCLK | J502.4, U501.26 |
| PMD_MOSI_M | R702.1, U501.15 |
| PMD_READY_M | R706.1, U501.33 |
| PMD_SCLK_M | R704.1, U501.13 |
| RF_MCU | C514.1 [DNP/PLACEHOLDER], L502.1 [PLACEHOLDER], U501.37 |
| RS485_B | J704.2, R714.2 [DNP], U701.7 |
| SW48_GATE | Q302.1 [DNP/PLACEHOLDER], R309.1 [DNP/PLACEHOLDER], R310.1 [DNP/PLACEHOLDER] |
| VBAT_FUSED | C102.1, F101.2, J102.1, U101.C2 |
| VBAT_SENSE | C104.1, R107.2, R108.1, U501.14 |
| WBA_VDD11 | C509.1 [PLACEHOLDER], L501.2 [PLACEHOLDER], U501.45 |
| WBA_VDDANA | C511.1 [PLACEHOLDER], R511.1 [DNP/PLACEHOLDER], U501.39 |
| WBA_VDDRF | C512.1 [PLACEHOLDER], R512.1 [DNP/PLACEHOLDER], U501.40 |
| WBA_VDDRFPA | C513.1 [PLACEHOLDER], R513.1 [DNP/PLACEHOLDER], U501.43 |

Baseline nets with unconnected pairs that have none now: ['+3V3', 'CON_SUP_RX', 'CON_SUP_TX', 'ENC_A_S', 'ENC_I', 'ENC_VCC', 'FLY_SS']
