BigBiglinn/INSULIN_PUMP/validation/placement/placement_applied_v2.png

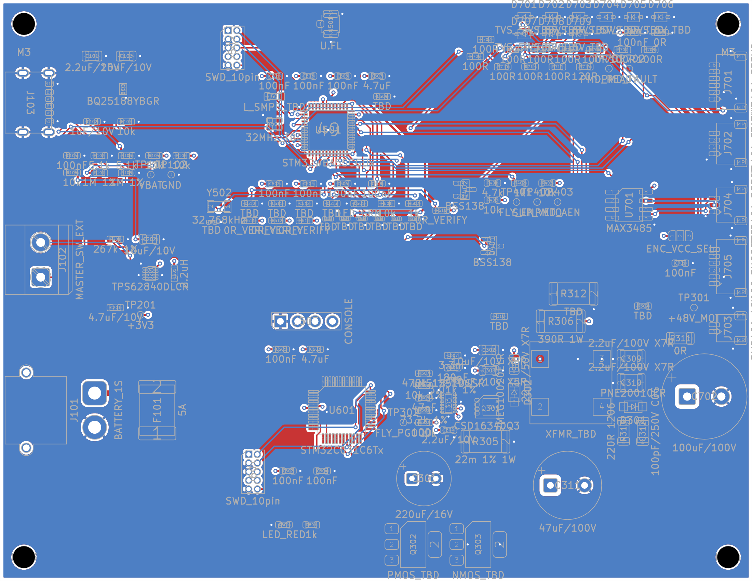
validation/placement/placement_applied_v2.png
