BigBiglinn/INSULIN_PUMP/validation/placement/placement_baseline_e8d141c.png

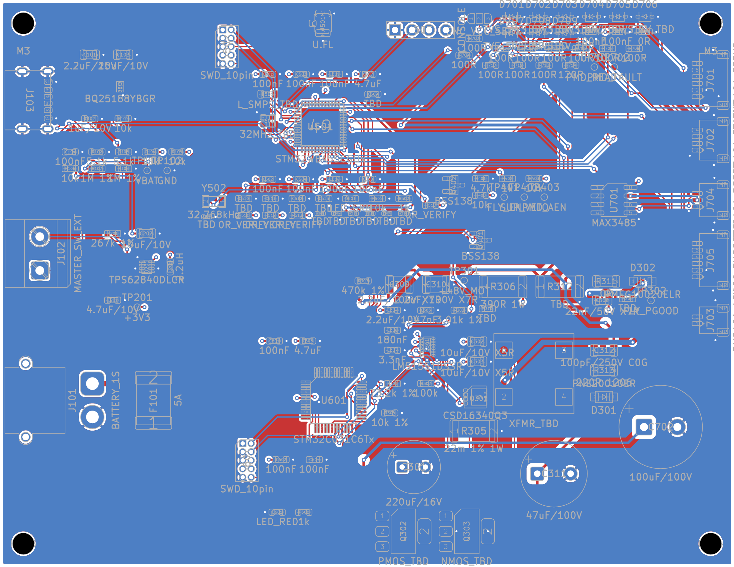
validation/placement/placement_baseline_e8d141c.png
