BigBiglinn/INSULIN_PUMP/validation/routing/d1_fcu_controller.png

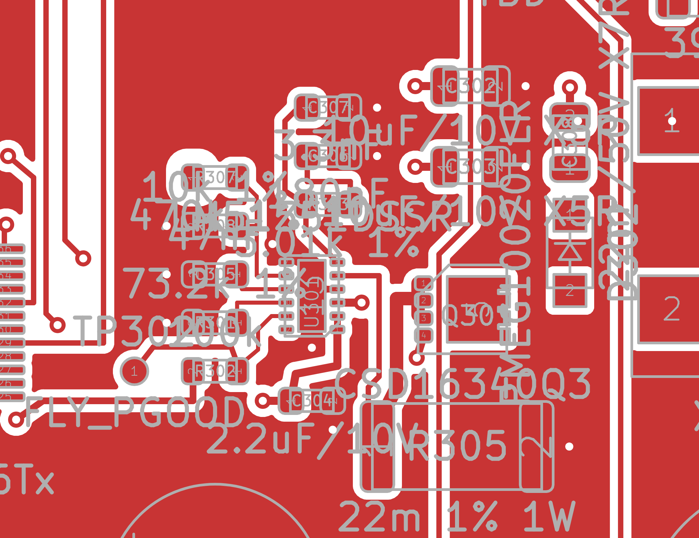
validation/routing/d1_fcu_controller.png
