BigBiglinn/INSULIN_PUMP/validation/routing/p2/p2_board_fcu.png

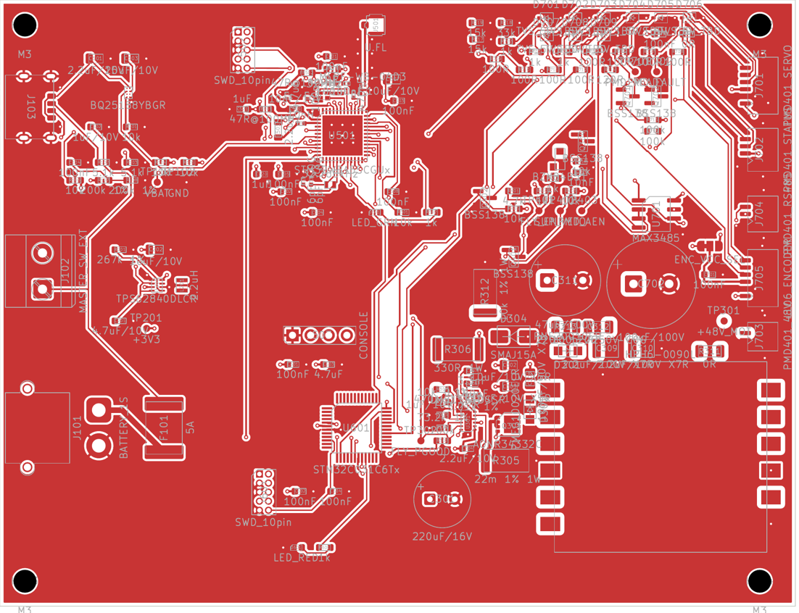
validation/routing/p2/p2_board_fcu.png
