BigBiglinn/INSULIN_PUMP/validation/routing/p2/p2_u501_bcu.png

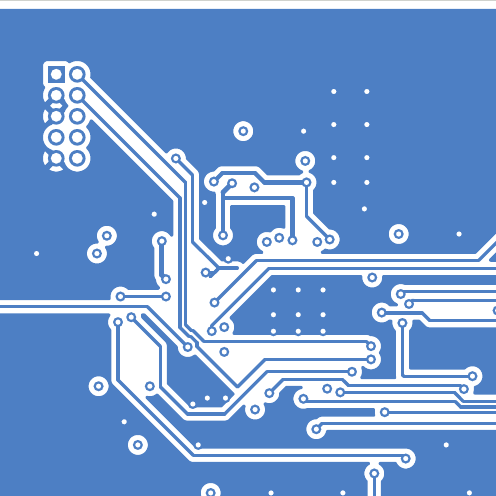
validation/routing/p2/p2_u501_bcu.png
