BigBiglinn/INSULIN_PUMP/validation/routing/p4/p4_bcu.png

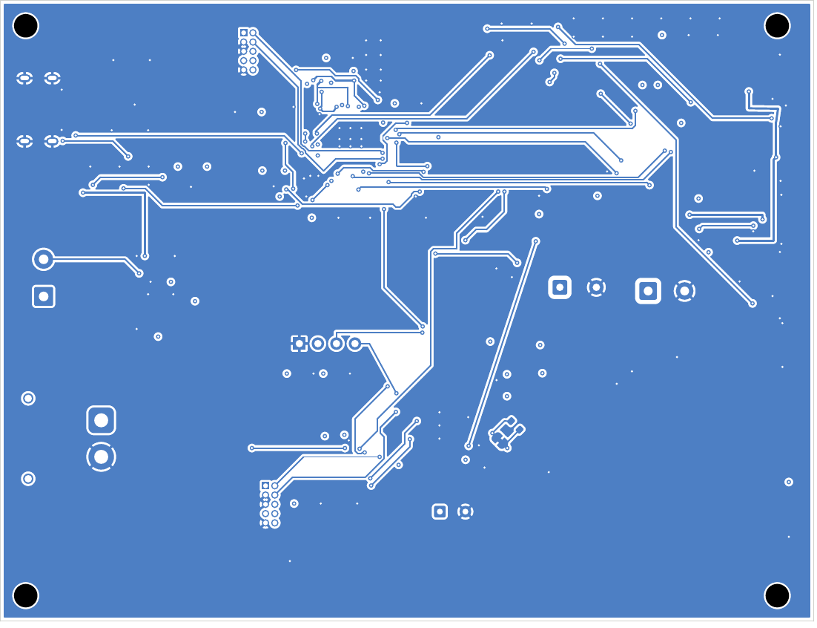
validation/routing/p4/p4_bcu.png
