BigBiglinn/INSULIN_PUMP/validation/routing/p4/p4_fcu.png

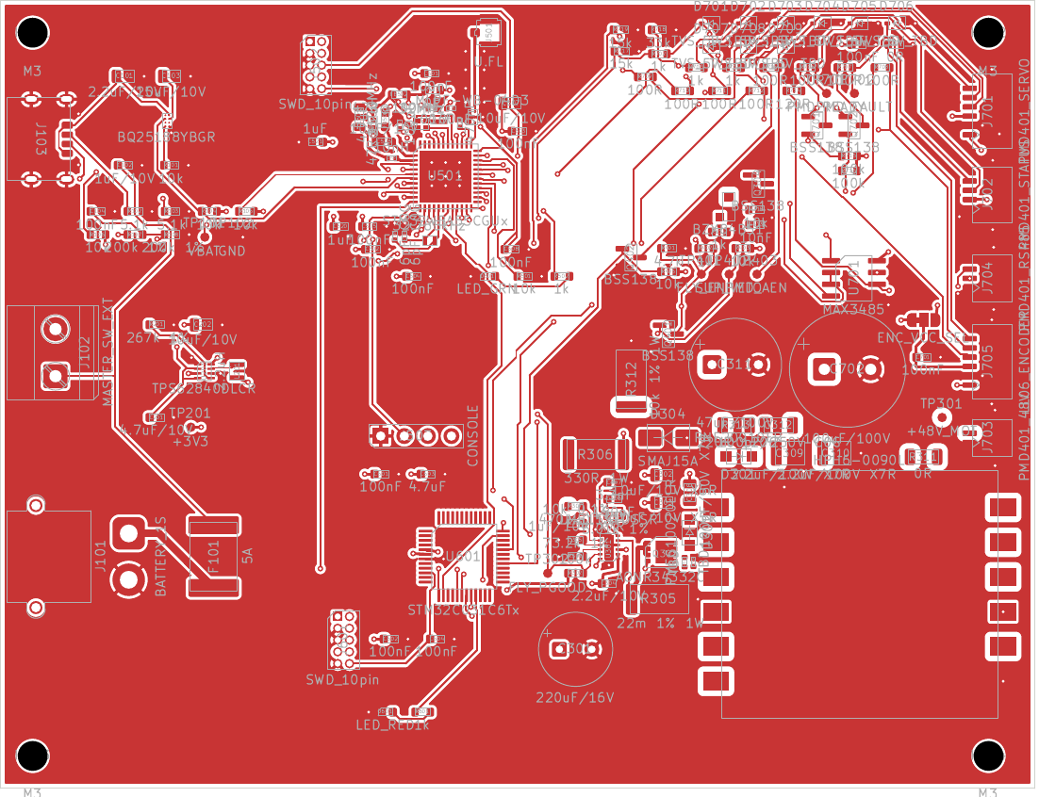
validation/routing/p4/p4_fcu.png
