BigBiglinn/INSULIN_PUMP/validation/routing/p5/p5_bcu.png

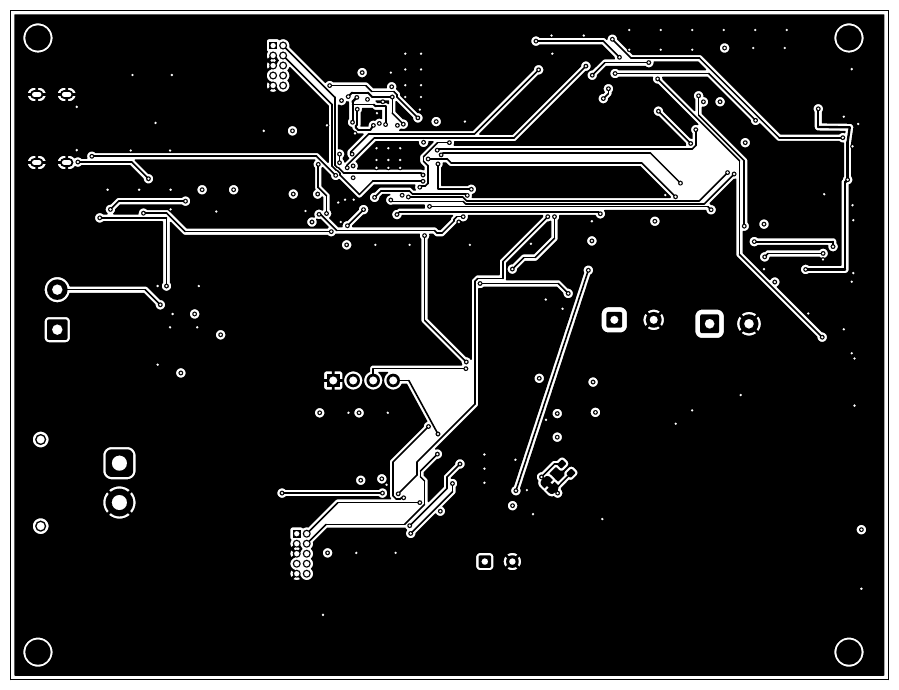
validation/routing/p5/p5_bcu.png
