BigBiglinn/INSULIN_PUMP/validation/routing/p5/p5_fcu.png

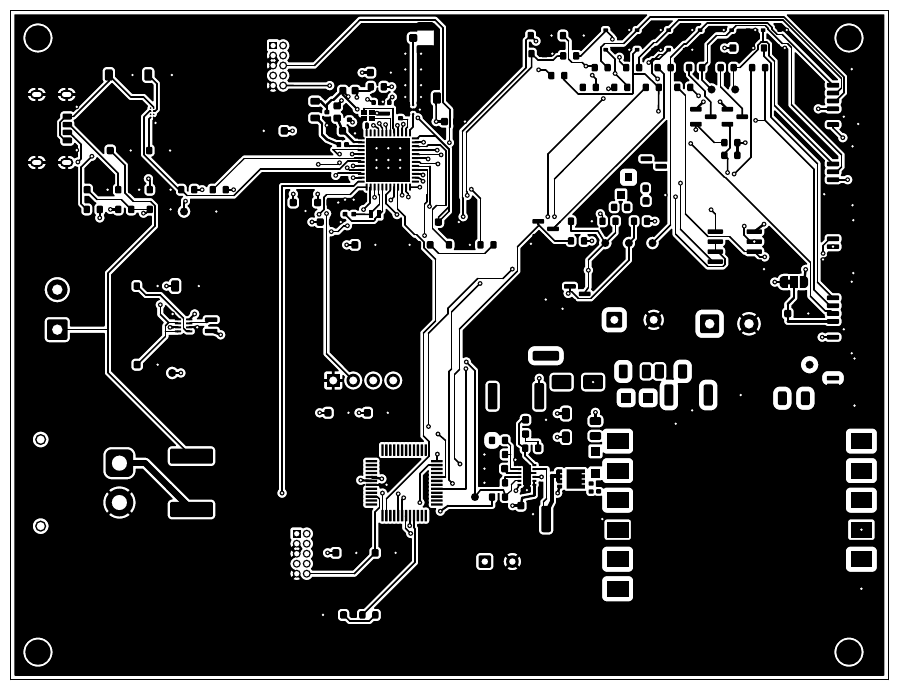
validation/routing/p5/p5_fcu.png
