BigBiglinn/INSULIN_PUMP/validation/routing/pcb_p1_placement.png

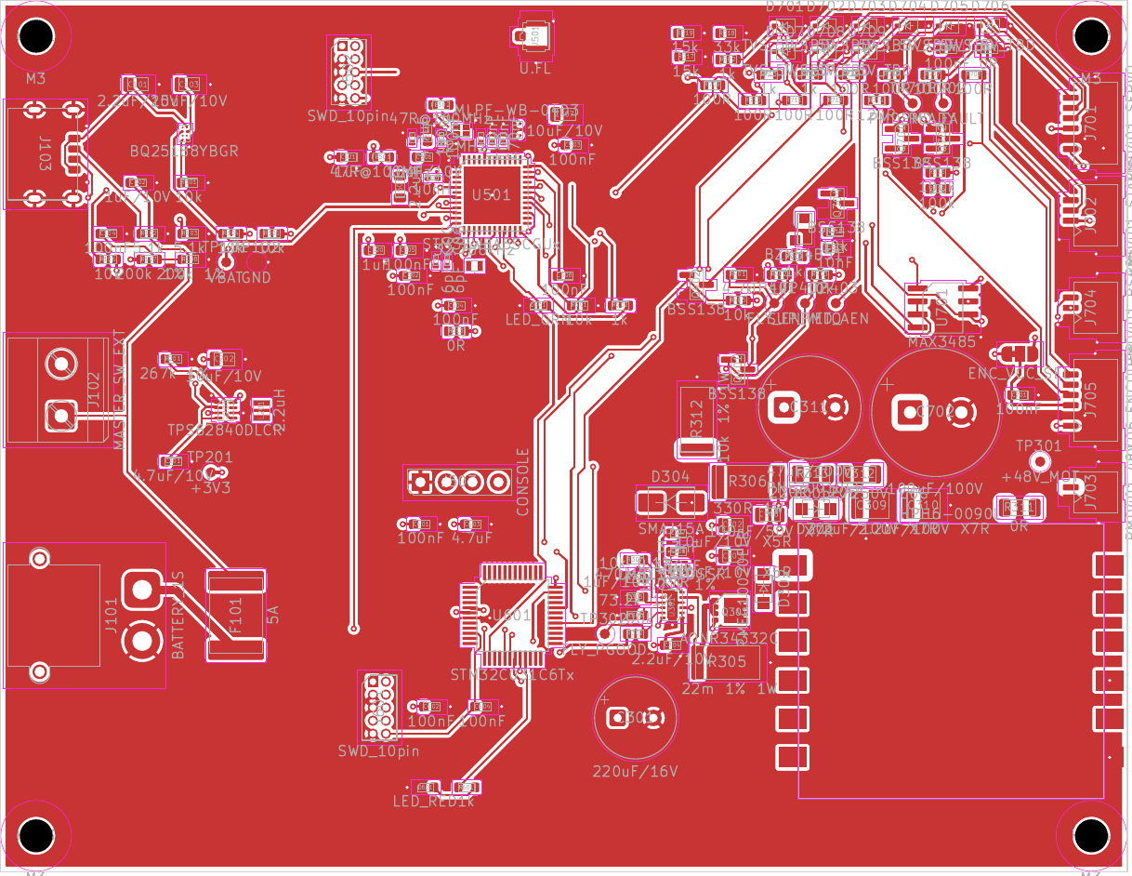
validation/routing/pcb_p1_placement.png
