BigBiglinn/INSULIN_PUMP/validation/routing/stage1_fcu_controller.png

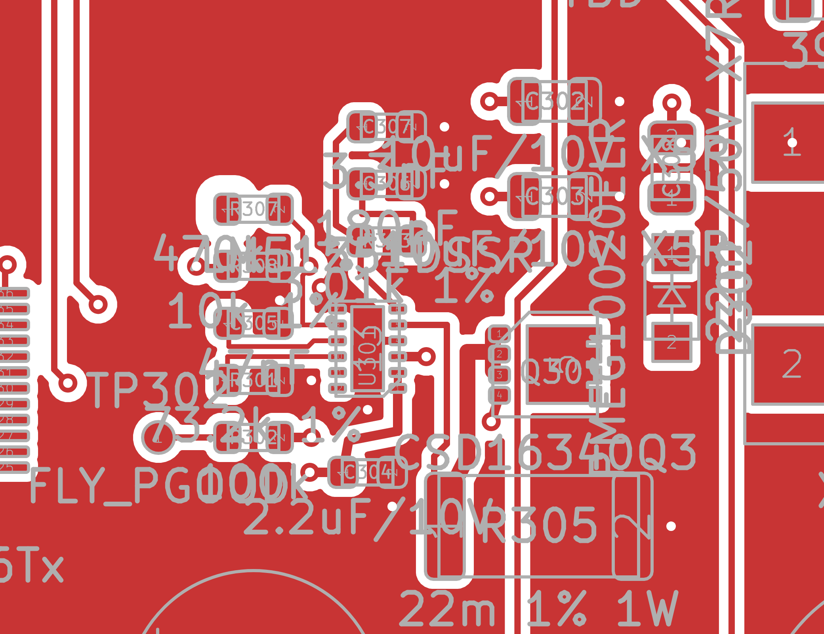
validation/routing/stage1_fcu_controller.png
