BigBiglinn/INSULIN_PUMP/validation/routing/pcb_p1_copper_changes.txt

Adding duplicate image handler for 'PNG file'
Adding duplicate image handler for 'JPEG file'
Adding duplicate image handler for 'TIFF file'
Adding duplicate image handler for 'GIF file'
Adding duplicate image handler for 'PNM file'
Adding duplicate image handler for 'PCX file'
Adding duplicate image handler for 'IFF file'
Adding duplicate image handler for 'Windows icon file'
Adding duplicate image handler for 'Windows cursor file'
Adding duplicate image handler for 'Windows animated cursor file'
Adding duplicate image handler for 'TGA file'
Adding duplicate image handler for 'XPM file'
Adding duplicate image handler for 'WebP file'
track mm before 2474 after 2163; vias 225 -> 206
nets with copper change 17
+3V3: 63.6 -> 62.2 mm, vias 35 -> 33
BUCK_SW: 7.7 -> 0.0 mm, vias 0 -> 0
GND: 114.8 -> 108.6 mm, vias 99 -> 94
LSE_OUT: 26.7 -> 0.0 mm, vias 2 -> 0
MAIN_NRST: 34.6 -> 24.6 mm, vias 2 -> 1
MAIN_SWO: 50.4 -> 30.3 mm, vias 0 -> 0
PMD_FAULT_M: 57.3 -> 43.6 mm, vias 2 -> 2
RF_ANT: 50.9 -> 0.0 mm, vias 2 -> 0
RF_MCU: 3.1 -> 0.0 mm, vias 0 -> 0
SW48_DRV: 41.3 -> 0.0 mm, vias 0 -> 0
SW48_GATE: 45.1 -> 0.0 mm, vias 0 -> 0
VBAT: 49.1 -> 50.4 mm, vias 10 -> 10
WBA_VDDANA: 5.1 -> 0.0 mm, vias 0 -> 0
WBA_VDDHPA: 47.8 -> 0.0 mm, vias 3 -> 0
WBA_VDDRF: 5.1 -> 0.0 mm, vias 0 -> 0
WBA_VDDRFPA: 21.2 -> 0.0 mm, vias 4 -> 0
WBA_VLXSMPS: 6.9 -> 0.0 mm, vias 0 -> 0
unchanged routed nets 62
footprints 147 -> 154 moved 28
