BigBiglinn/INSULIN_PUMP/docs/report_assets/layer_B.Cu.pdf

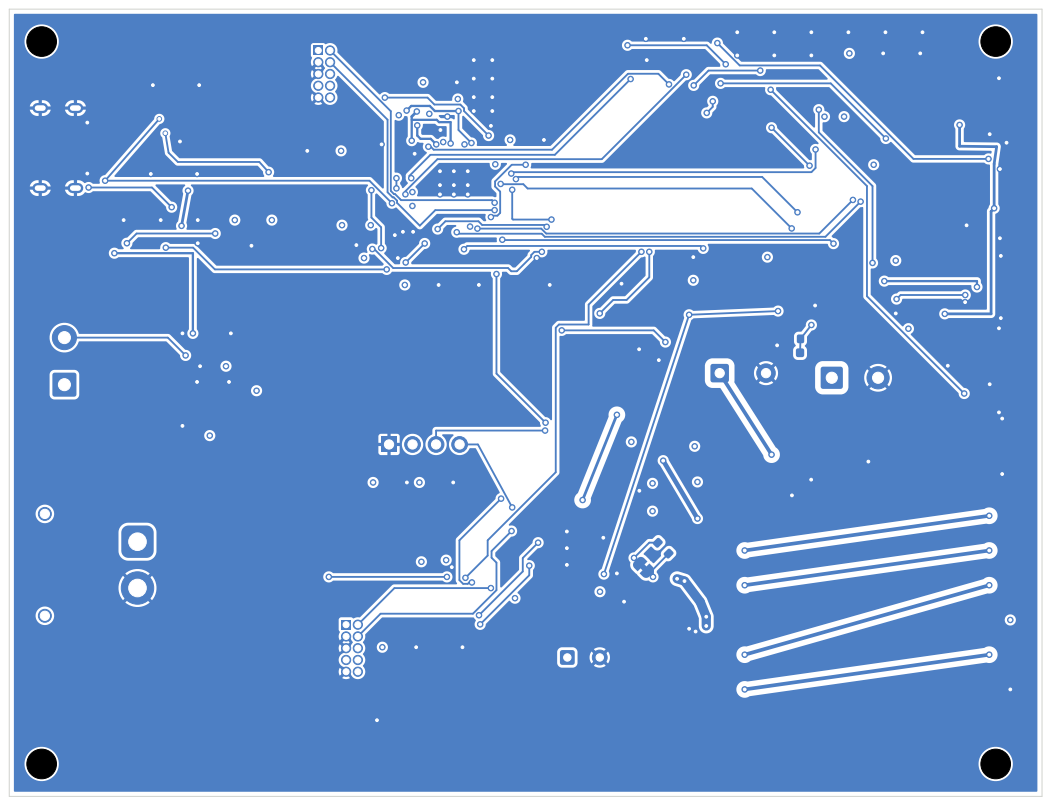
[picture p24: page 1]
