BigBiglinn/INSULIN_PUMP/docs/report_assets/layer_F.Cu.pdf

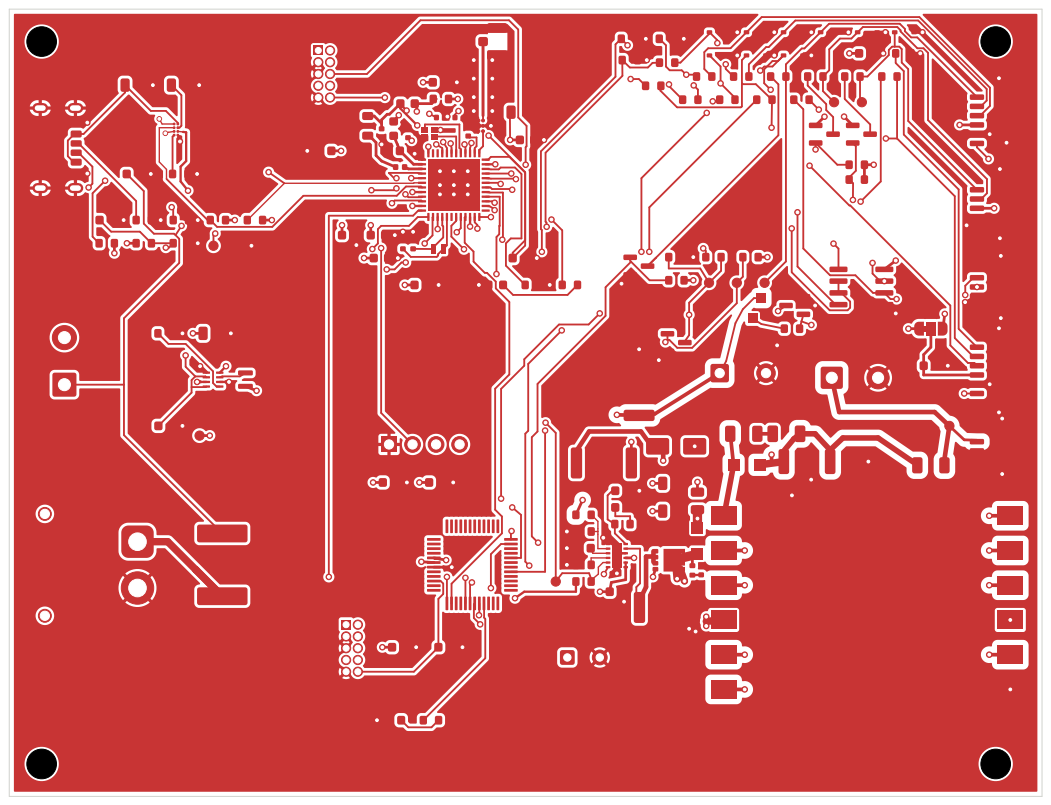
[picture p25: page 1]
