BigBiglinn/INSULIN_PUMP/docs/report_assets/layer_In1.Cu.pdf

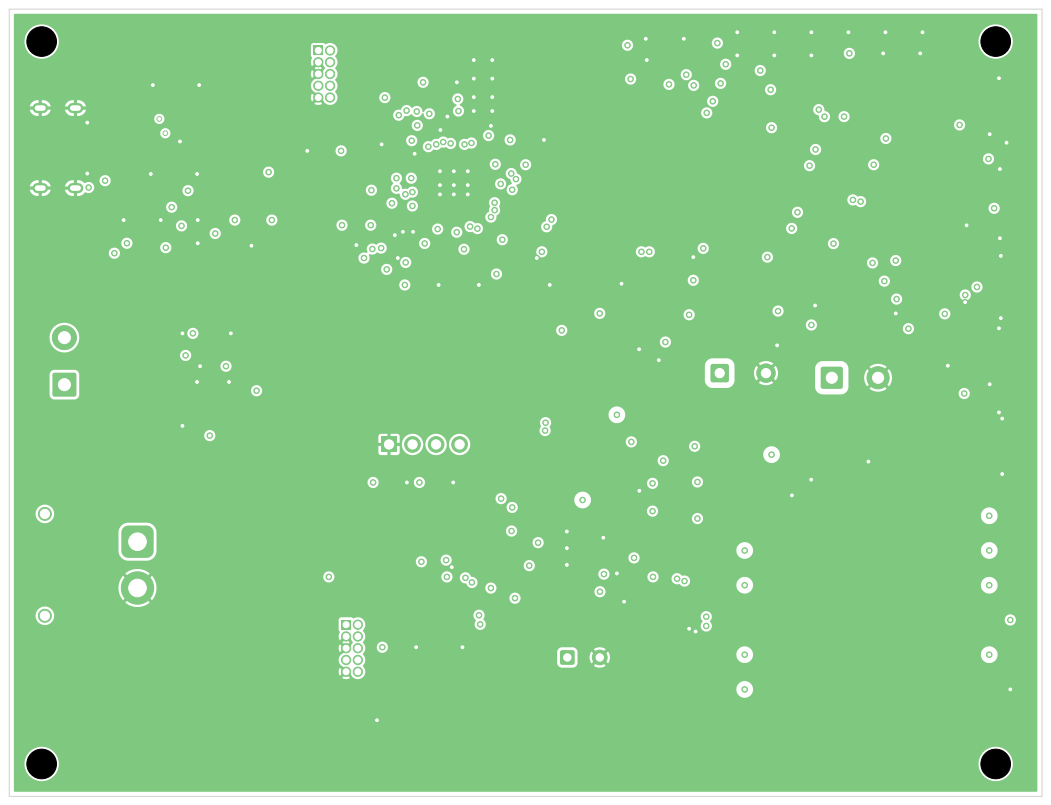
[picture p26: page 1]
