BigBiglinn/INSULIN_PUMP/docs/report_assets/layer_In2.Cu.pdf

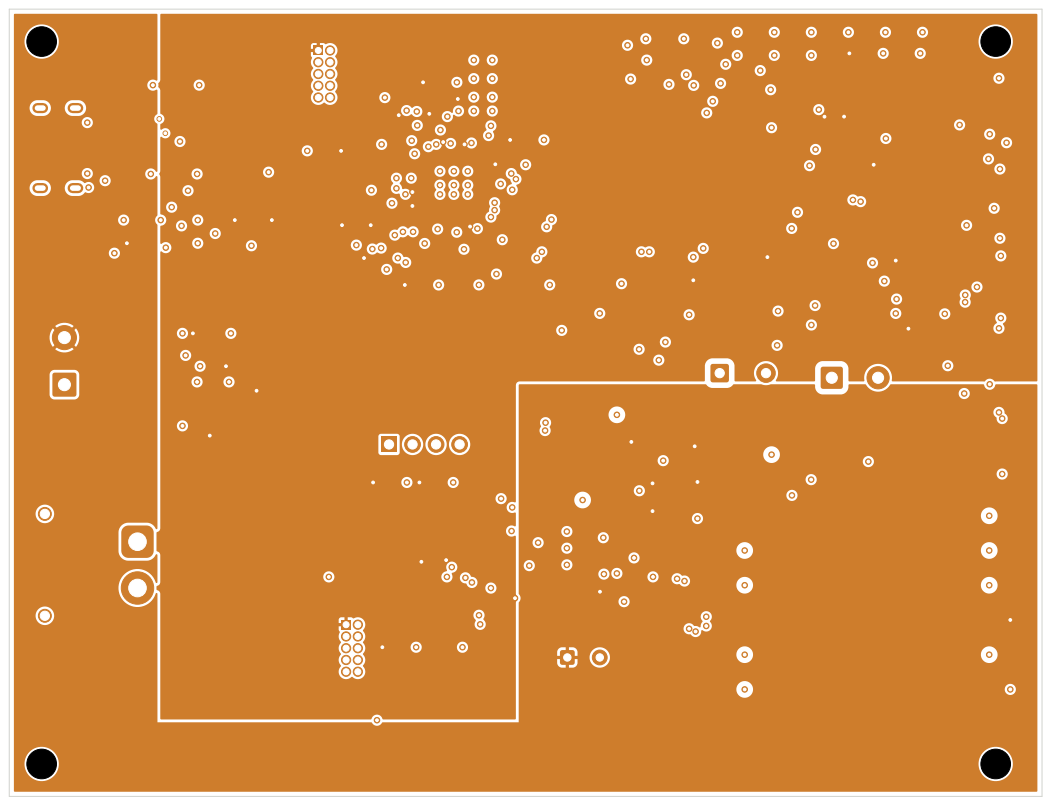
[picture p27: page 1]
