BigBiglinn/INSULIN_PUMP/(list of files, drawings)

Other design files:
validation/routing/pcb_p1_plan.json
validation/routing/pcb_p1b_plan.json
validation/routing/pcb_p1c_plan.json
