BigBiglinn/INSULIN_PUMP/hardware/kicad/pump_v2.kicad_pcb

## KiCad design hardware/kicad/pump_v2.kicad_pcb (2026-11-01)

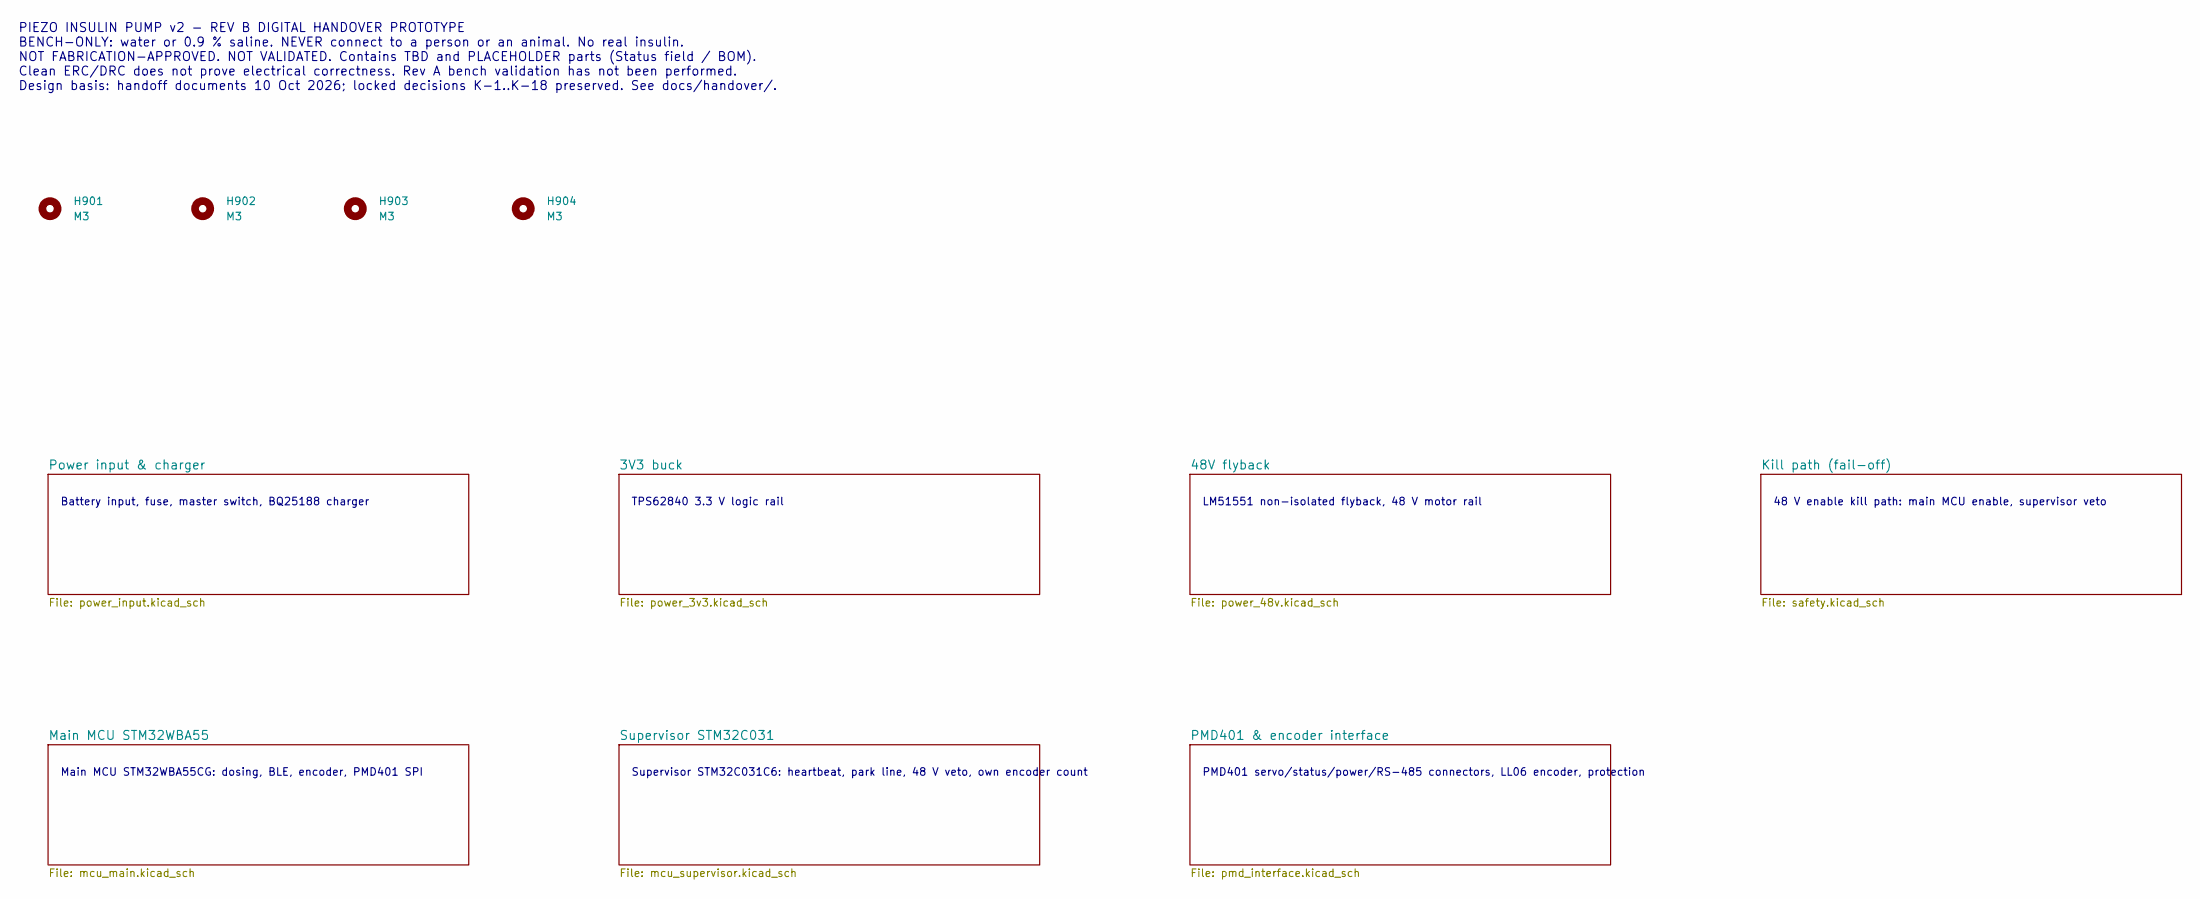
[picture p28: schematic pump_v2.kicad_sch, Piezo Insulin Pump v2 - Rev B handover prototype]

Parts:
H901, H902, H903, H904: M3; MountingHole_3.2mm_M3

Notes on the sheet:
PIEZO INSULIN PUMP v2 - REV B DIGITAL HANDOVER PROTOTYPE BENCH-ONLY: water or 0.9 % saline. NEVER connect to a person or an animal. No real insulin. NOT FABRICATION-APPROVED. NOT VALIDATED. Contains TBD and PLACEHOLDER parts (Status field / BOM). Clean ERC/DRC does not prove electrical correctness.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
Battery input, fuse, master switch, BQ25188 charger
TPS62840 3.3 V logic rail
LM51551 non-isolated flyback, 48 V motor rail
48 V enable kill path: main MCU enable, supervisor veto
Main MCU STM32WBA55CG: dosing, BLE, encoder, PMD401 SPI
Supervisor STM32C031C6: heartbeat, park line, 48 V veto, own encoder count
PMD401 servo/status/power/RS-485 connectors, LL06 encoder, protection

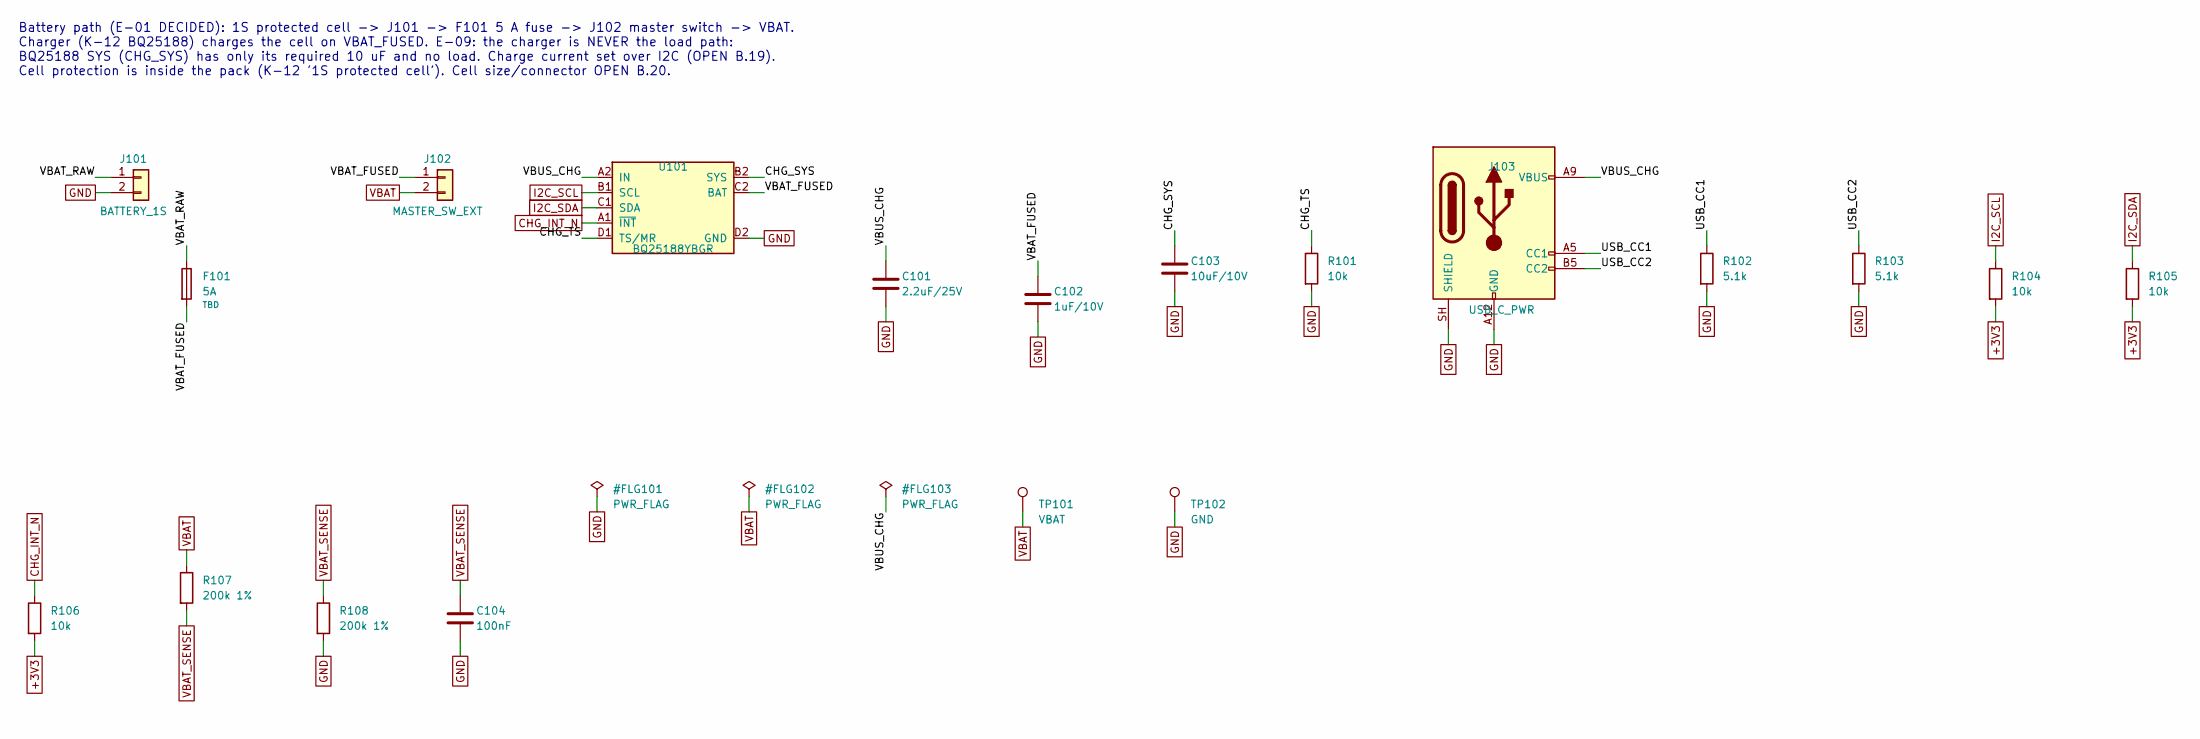
[picture p29: schematic power_input.kicad_sch, Battery input, fuse, master switch, BQ25188 charger]

Parts:
C101: 2.2uF/25V; C_0805_2012Metric
C102: 1uF/10V; C_0603_1608Metric
C103: 10uF/10V; C_0805_2012Metric
C104: 100nF; C_0603_1608Metric
F101: 5A; Fuse_2920_7451Metric
J101: BATTERY_1S; AMASS_XT30PW-M_1x02_P2.50mm_Horizontal; MPN AMASS XT30PW-M
J102: MASTER_SW_EXT; TerminalBlock_Phoenix_MKDS-1,5-2-5.08_1x02_P5.08mm_Horizont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
J103: USB_C_PWR; USB_C_Receptacle_GCT_USB4125-xx-x_6P_TopMnt_Horizontal; MPN GCT USB4125
R101, R104, R105, R106: 10k; R_0603_1608Metric
R102, R103: 5.1k; R_0603_1608Metric
R107, R108: 200k 1%; R_0603_1608Metric
TP101: VBAT; TestPoint_Pad_D1.0mm
TP102: GND; TestPoint_Pad_D1.0mm
U101: BQ25188YBGR; TI_YBG0008_DSBGA-8_P0.4mm_UNVERIFIED; MPN BQ25188YBGR

Connections:
+3V3: R104.2, R105.2, R106.2; also elsewhere on the board
/Power input & charger/CHG_SYS: C103.1, U101.B2 (SYS)
/Power input & charger/CHG_TS: R101.1, U101.D1 (TS/MR)
/Power input & charger/USB_CC1: J103.A5 (CC1), R102.1
/Power input & charger/USB_CC2: J103.B5 (CC2), R103.1
/Power input & charger/VBAT_FUSED: C102.1, F101.2, J102.1, U101.C2 (BAT)
/Power input & charger/VBAT_RAW: F101.1, J101.1
/Power input & charger/VBUS_CHG: C101.1, J103.A9 (VBUS), J103.B9 (VBUS), U101.A2 (IN)
CHG_INT_N: R106.1, U101.A1 (~INT); also elsewhere on the board
GND: C101.2, C102.2, C103.2, C104.2, J101.2, J103.A12 (GND), J103.B12 (GND), J103.SH (SHIELD), R101.2, R102.2, R103.2, R108.2, TP102.1, U101.D2 (GND); also elsewhere on the board
I2C_SCL: R104.1, U101.B1 (SCL); also elsewhere on the board
I2C_SDA: R105.1, U101.C1 (SDA); also elsewhere on the board
VBAT: J102.2, R107.1, TP101.1; also elsewhere on the board
VBAT_SENSE: C104.1, R107.2, R108.1; also elsewhere on the board

Notes on the sheet:
Battery path (E-01 DECIDED): 1S protected cell -> J101 -> F101 5 A fuse -> J102 master switch -> VBAT. Charger (K-12 BQ25188) charges the cell on VBAT_FUSED. E-09: the charger is NEVER the load path: BQ25188 SYS (CHG_SYS) has only its required 10 uF and no load. Charge current set over I2C (OPEN B.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

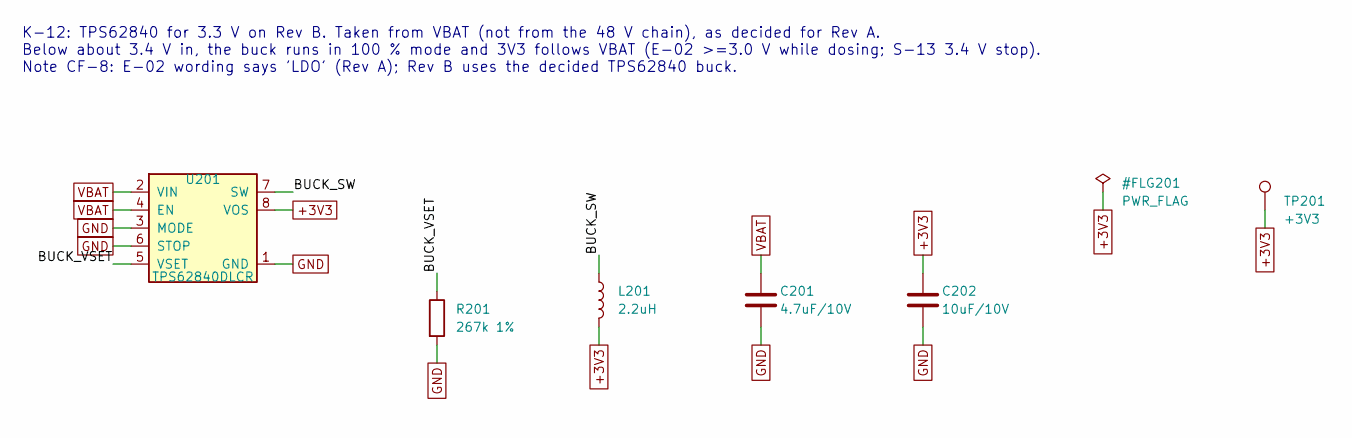
[picture p30: schematic power_3v3.kicad_sch, TPS62840 3.3 V logic rail]

Parts:
C201: 4.7uF/10V; C_0603_1608Metric
C202: 10uF/10V; C_0805_2012Metric
L201: 2.2uH; L_Murata_DFE201610P; MPN Murata DFE201612E-2R2M=P2
R201: 267k 1%; R_0603_1608Metric
TP201: +3V3; TestPoint_Pad_D1.0mm
U201: TPS62840DLCR; Texas_VSON-HR-8_1.5x2mm_P0.5mm; MPN TPS62840DLCR

Connections:
+3V3: C202.1, L201.2, TP201.1, U201.8 (VOS); also elsewhere on the board
/3V3 buck/BUCK_SW: L201.1, U201.7 (SW)
/3V3 buck/BUCK_VSET: R201.1, U201.5 (VSET)
GND: C201.2, C202.2, R201.2, U201.1 (GND), U201.3 (MODE), U201.6 (STOP); also elsewhere on the board
VBAT: C201.1, U201.2 (VIN), U201.4 (EN); also elsewhere on the board

Notes on the sheet:
K-12: TPS62840 for 3.3 V on Rev B. Taken from VBAT (not from the 48 V chain), as decided for Rev A. Below about 3.4 V in, the buck runs in 100 % mode and 3V3 follows VBAT (E-02 >=3.0 V while dosing; S-13 3.4 V stop). Note CF-8: E-02 wording says 'LDO' (Rev A); Rev B uses the decided TPS62840 buck.

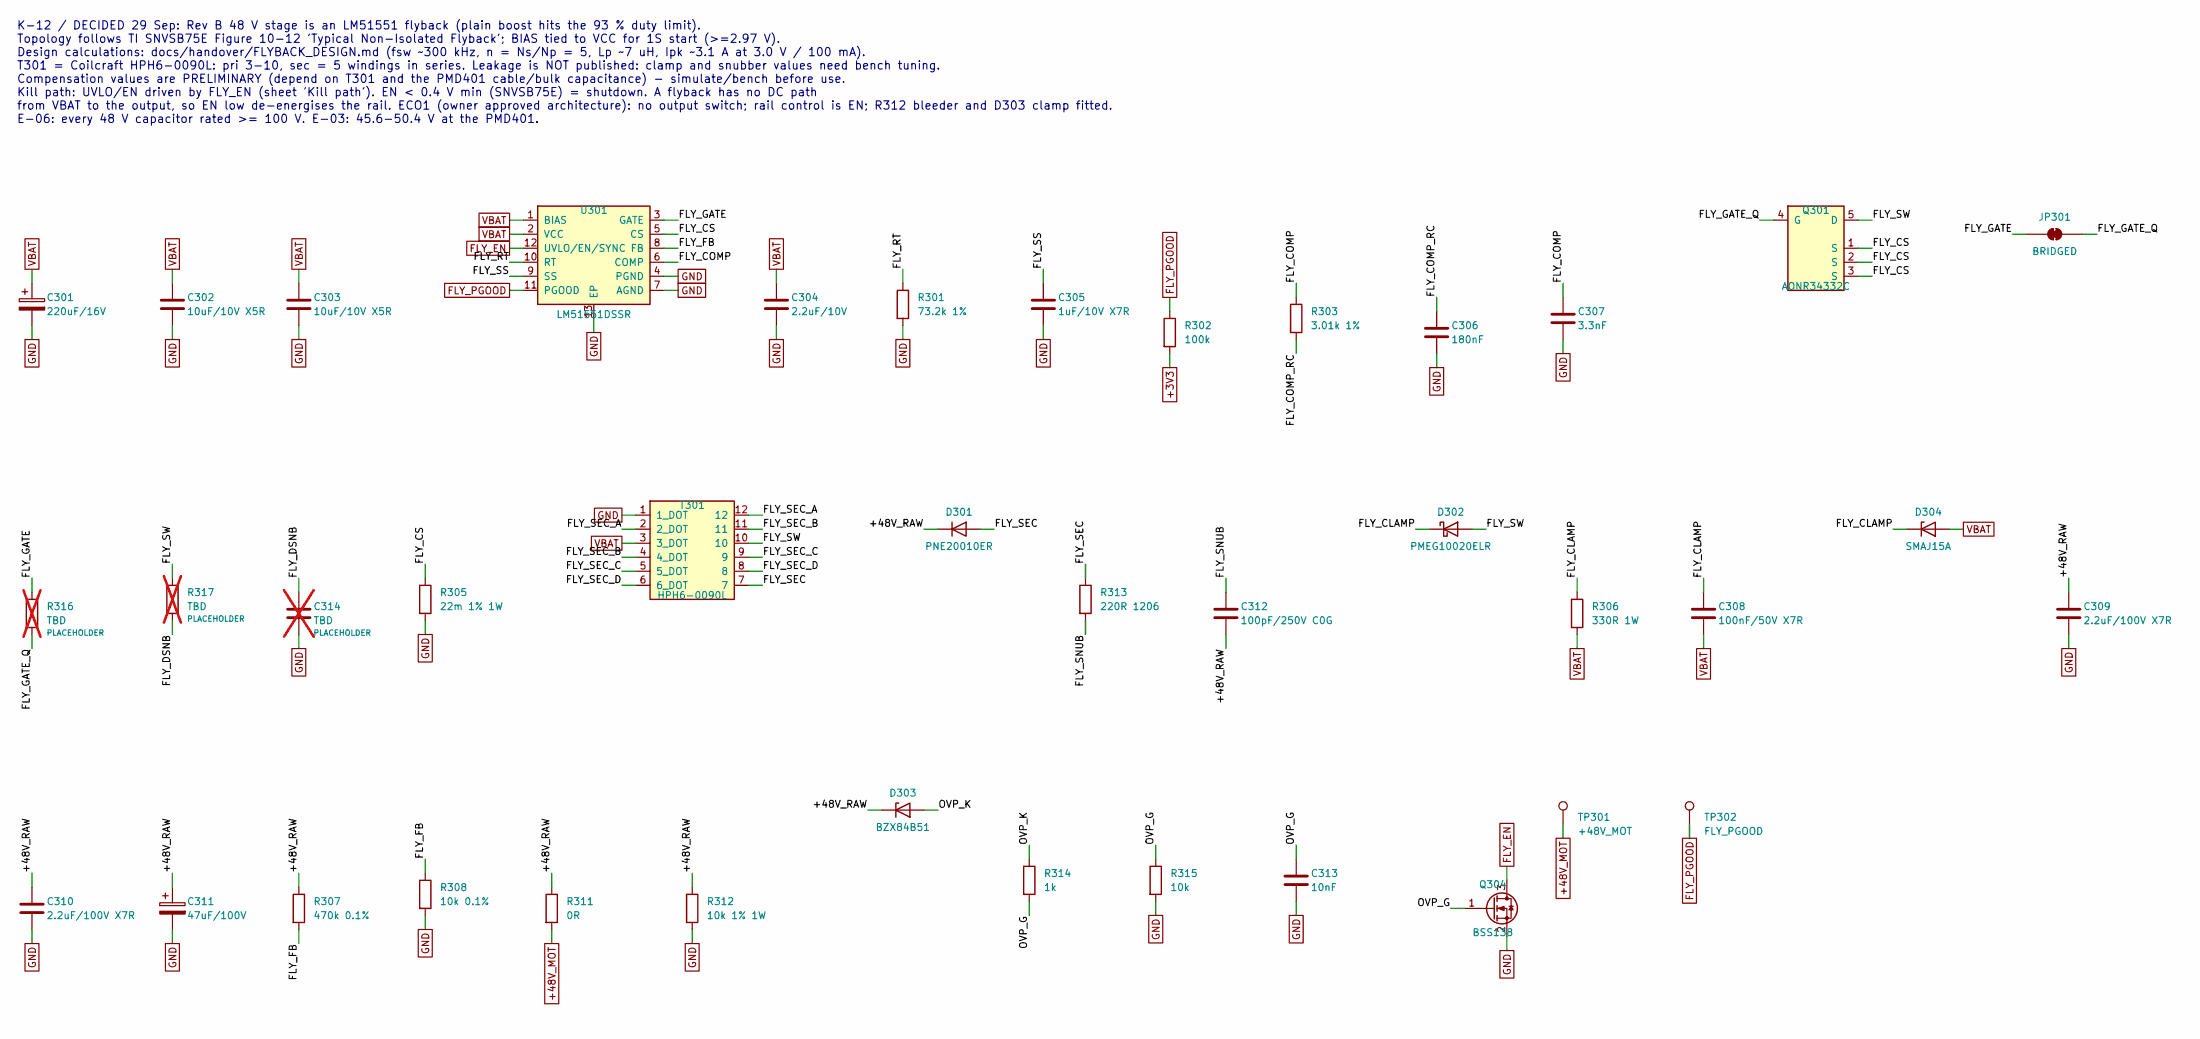
[picture p31: schematic power_48v.kicad_sch, LM51551 non-isolated flyback, 48 V motor rail]

Parts:
C301: 220uF/16V; CP_Radial_D8.0mm_P3.50mm
C302, C303: 10uF/10V X5R; C_0805_2012Metric
C304: 2.2uF/10V; C_0603_1608Metric
C305: 1uF/10V X7R; C_0603_1608Metric
C306: 180nF; C_0603_1608Metric
C307: 3.3nF; C_0603_1608Metric
C308: 100nF/50V X7R; C_0805_2012Metric
C309, C310: 2.2uF/100V X7R; C_1210_3225Metric
C311: 47uF/100V; CP_Radial_D10.0mm_P5.00mm
C312: 100pF/250V C0G; C_1206_3216Metric
C313: 10nF; C_0603_1608Metric
C314: TBD; C_0402_1005Metric; not fitted
D301: PNE20010ER; Nexperia_CFP3_SOD-123W; MPN Nexperia PNE20010ER
D302: PMEG10020ELR; Nexperia_CFP3_SOD-123W; MPN Nexperia PMEG10020ELR
D303: BZX84B51; SOT-23_Zener_A1_K3; MPN Vishay BZX84B51-E3-08
D304: SMAJ15A; D_SMA; MPN Littelfuse SMAJ15A
JP301: BRIDGED; SolderJumper-2_P1.3mm_Bridged_RoundedPad1.0x1.5mm
Q301: AONR34332C; VSON-8_3.3x3.3mm_P0.65mm_NexFET; MPN AOS AONR34332C
Q304: BSS138; SOT-23; MPN BSS138 (e.g. Nexperia BSS138P)
R301: 73.2k 1%; R_0603_1608Metric
R302: 100k; R_0603_1608Metric
R303: 3.01k 1%; R_0603_1608Metric
R305: 22m 1% 1W; R_2512_6332Metric
R306: 330R 1W; R_2512_6332Metric
R307: 470k 0.1%; R_0603_1608Metric
R308: 10k 0.1%; R_0603_1608Metric
R311: 0R; R_1206_3216Metric
R312: 10k 1% 1W; R_2512_6332Metric
R313: 220R 1206; R_1206_3216Metric
R314: 1k; R_0603_1608Metric
R315: 10k; R_0603_1608Metric
R316: TBD; R_0603_1608Metric; not fitted
R317: TBD; R_0402_1005Metric; not fitted
T301: HPH6-0090L; Coilcraft_HPH6; MPN Coilcraft HPH6-0090L
TP301: +48V_MOT; TestPoint_Pad_D1.0mm
TP302: FLY_PGOOD; TestPoint_Pad_D1.0mm
U301: LM51551DSSR; WSON-12-1EP_3x2mm_P0.5mm_EP1x2.65; MPN LM51551DSSR

Connections:
+3V3: R302.2; also elsewhere on the board
+48V_MOT: R311.2, TP301.1; also elsewhere on the board
/48V flyback/+48V_RAW: C309.1, C310.1, C311.1, C312.2, D301.1 (K), D303.1 (K), R307.1, R311.1, R312.1
/48V flyback/FLY_CLAMP: C308.1, D302.1 (K), D304.1 (K), R306.1
/48V flyback/FLY_COMP: C307.1, R303.1, U301.6 (COMP)
/48V flyback/FLY_COMP_RC: C306.1, R303.2
/48V flyback/FLY_CS: Q301.1 (S), Q301.2 (S), Q301.3 (S), R305.1, U301.5 (CS)
/48V flyback/FLY_DSNB: C314.1, R317.2
/48V flyback/FLY_FB: R307.2, R308.1, U301.8 (FB)
/48V flyback/FLY_GATE: JP301.1 (A), R316.1, U301.3 (GATE)
/48V flyback/FLY_GATE_Q: JP301.2 (B), Q301.4 (G), R316.2
/48V flyback/FLY_RT: R301.1, U301.10 (RT)
/48V flyback/FLY_SEC: D301.2 (A), R313.1, T301.7
/48V flyback/FLY_SEC_A: T301.2 (2_DOT), T301.12
/48V flyback/FLY_SEC_B: T301.4 (4_DOT), T301.11
/48V flyback/FLY_SEC_C: T301.5 (5_DOT), T301.9
/48V flyback/FLY_SEC_D: T301.6 (6_DOT), T301.8
/48V flyback/FLY_SNUB: C312.1, R313.2
/48V flyback/FLY_SS: C305.1, U301.9 (SS)
/48V flyback/FLY_SW: D302.2 (A), Q301.5 (D), R317.1, T301.10
/48V flyback/OVP_G: C313.1, Q304.1 (G), R314.2, R315.1
/48V flyback/OVP_K: D303.2 (A), R314.1
FLY_EN: Q304.3 (D), U301.12 (UVLO/EN/SYNC); also elsewhere on the board
FLY_PGOOD: R302.1, TP302.1, U301.11 (PGOOD); also elsewhere on the board
GND: C301.2, C302.2, C303.2, C304.2, C305.2, C306.2, C307.2, C309.2, C310.2, C311.2, C313.2, C314.2, Q304.2 (S), R301.2, R305.2, R308.2, R312.2, R315.2, T301.1 (1_DOT), U301.4 (PGND), U301.7 (AGND), U301.13 (EP); also elsewhere on the board
VBAT: C301.1, C302.1, C303.1, C304.1, C308.2, D304.2 (A), R306.2, T301.3 (3_DOT), U301.1 (BIAS), U301.2 (VCC); also elsewhere on the board

Notes on the sheet:
K-12 / DECIDED 29 Sep: Rev B 48 V stage is an LM51551 flyback (plain boost hits the 93 % duty limit). Topology follows TI SNVSB75E Figure 10-12 'Typical Non-Isolated Flyback'; BIAS tied to VCC for 1S start (>=2.97 V). Design calculations: docs/handover/FLYBACK_DESIGN.md (fsw ~300 kHz, n = Ns/Np = 5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

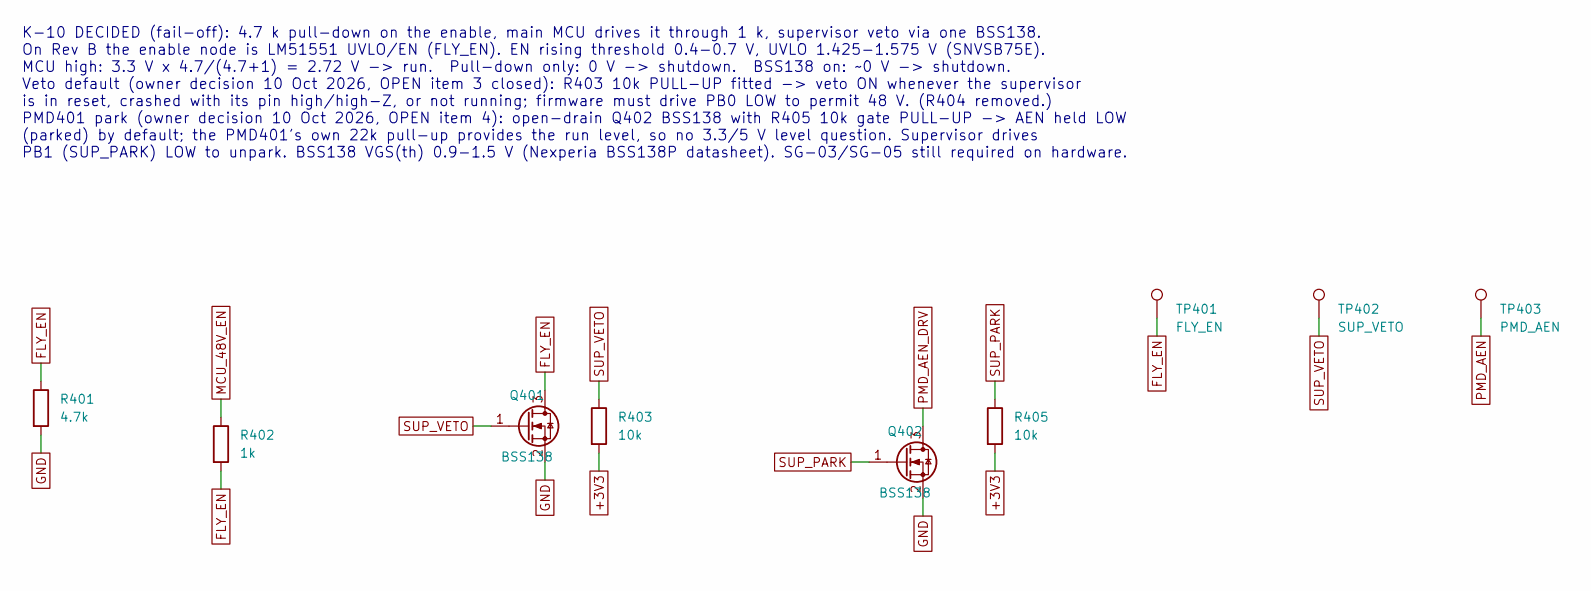
[picture p32: schematic safety.kicad_sch, 48 V enable kill path: main MCU enable, supervisor veto]

Parts:
Q401: BSS138; SOT-23; MPN BSS138
Q402: BSS138; SOT-23; MPN BSS138 (e.g. Nexperia BSS138P)
R401: 4.7k; R_0603_1608Metric
R402: 1k; R_0603_1608Metric
R403, R405: 10k; R_0603_1608Metric
TP401: FLY_EN; TestPoint_Pad_D1.0mm
TP402: SUP_VETO; TestPoint_Pad_D1.0mm
TP403: PMD_AEN; TestPoint_Pad_D1.0mm

Connections:
+3V3: R403.2, R405.2; also elsewhere on the board
FLY_EN: Q401.3 (D), R401.1, R402.2, TP401.1; also elsewhere on the board
GND: Q401.2 (S), Q402.2 (S), R401.2; also elsewhere on the board
MCU_48V_EN: R402.1; also elsewhere on the board
PMD_AEN: TP403.1; also elsewhere on the board
PMD_AEN_DRV: Q402.3 (D); also elsewhere on the board
SUP_PARK: Q402.1 (G), R405.1; also elsewhere on the board
SUP_VETO: Q401.1 (G), R403.1, TP402.1; also elsewhere on the board

Notes on the sheet:
K-10 DECIDED (fail-off): 4.7 k pull-down on the enable, main MCU drives it through 1 k, supervisor veto via one BSS138. On Rev B the enable node is LM51551 UVLO/EN (FLY_EN). EN rising threshold 0.4-0.7 V, UVLO 1.425-1.575 V (SNVSB75E). MCU high: 3.3 V x 4.7/(4.7+1) = 2.72 V -> run. Pull-down only: 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

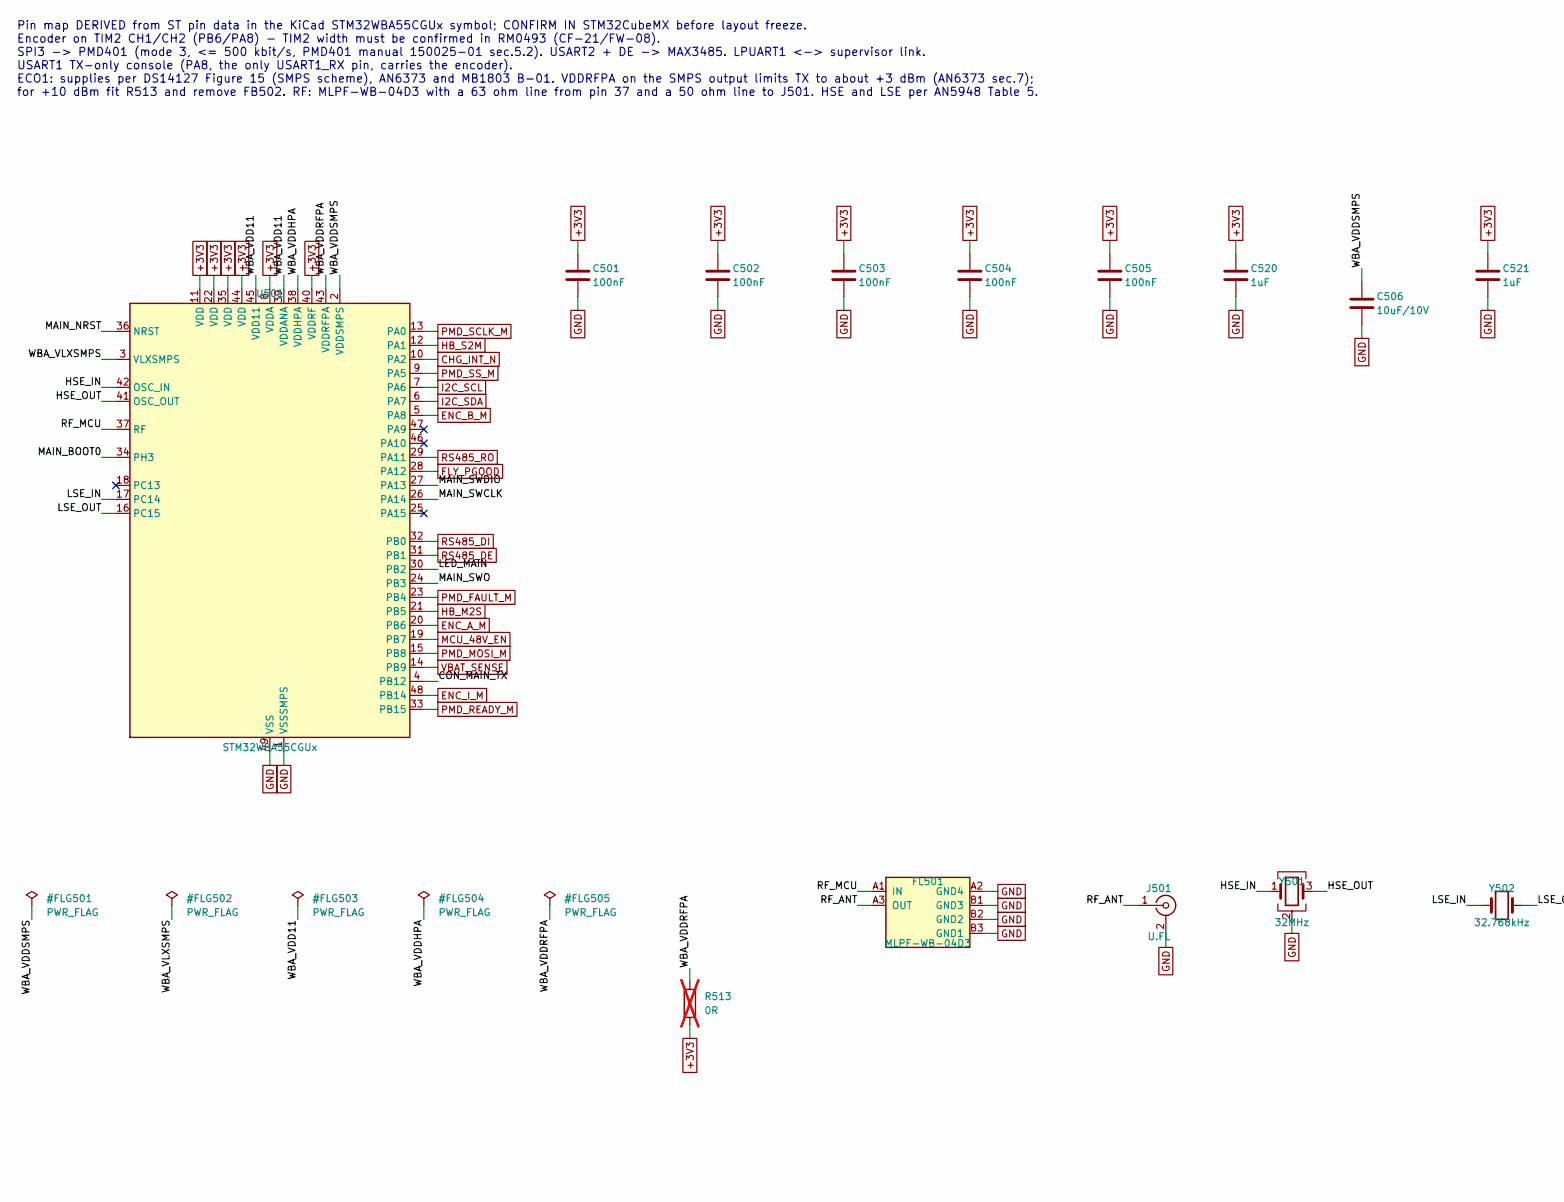
[picture p33: schematic mcu_main.kicad_sch, Main MCU STM32WBA55CG: dosing, BLE, encoder, PMD401 SPI, part in row 1, column 1]

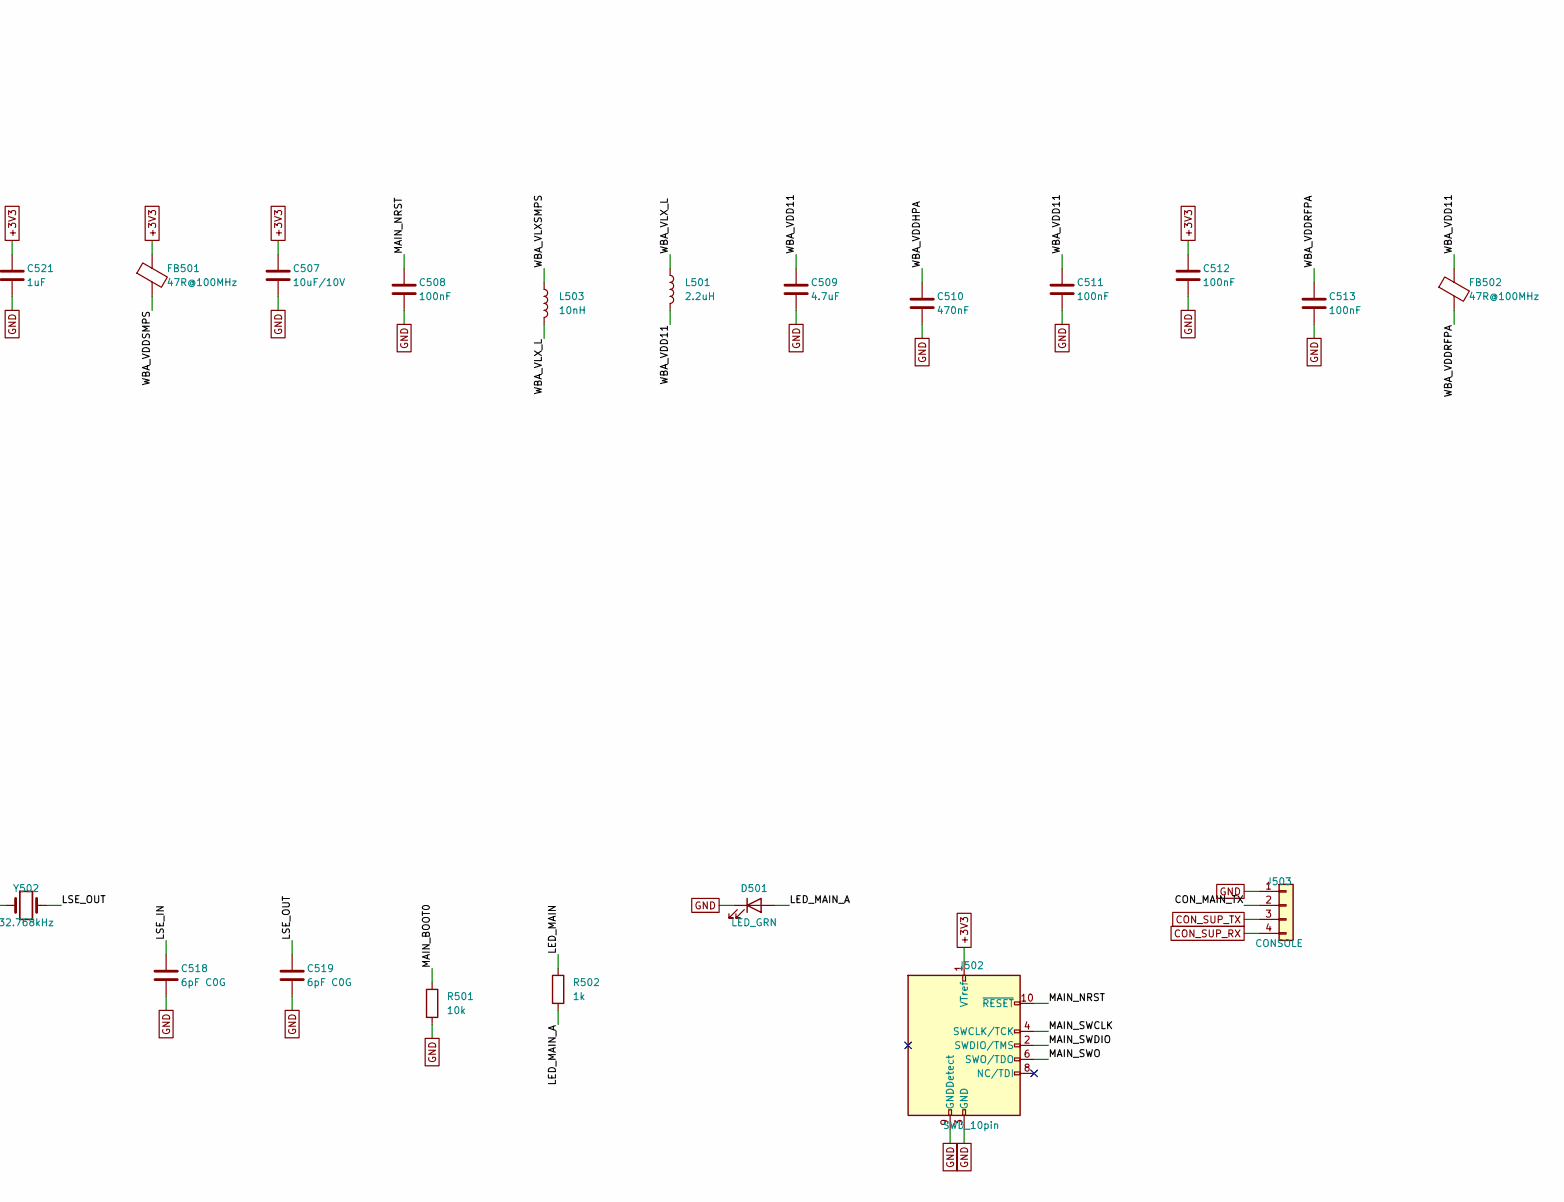
[picture p34: schematic mcu_main.kicad_sch, Main MCU STM32WBA55CG: dosing, BLE, encoder, PMD401 SPI, part in row 1, column 2]

Parts:
C501, C502, C503, C504, C505, C508: 100nF; C_0603_1608Metric
C506: 10uF/10V; C_0603_1608Metric; MPN Murata GRM188C81A106MA73
C507: 10uF/10V; C_0805_2012Metric
C509: 4.7uF; C_0402_1005Metric; MPN Murata GRM155R60J475ME47D
C510: 470nF; C_0402_1005Metric
C511, C512, C513: 100nF; C_0402_1005Metric
C518, C519: 6pF C0G; C_0402_1005Metric
C520, C521: 1uF; C_0603_1608Metric
D501: LED_GRN; LED_0603_1608Metric
FB501, FB502: 47R@100MHz; C_0603_1608Metric; MPN Taiyo Yuden LSMGA160808T470RG
FL501: MLPF-WB-04D3; ST_MLPF-WB-04D3; MPN ST MLPF-WB-04D3
J501: U.FL; U.FL_Hirose_U.FL-R-SMT-1_Vertical; MPN Hirose U.FL-R-SMT-1
J502: SWD_10pin; PinHeader_2x05_P1.27mm_Vertical
J503: CONSOLE; PinHeader_1x04_P2.54mm_Vertical
L501: 2.2uH; L_0805_2012Metric; MPN Murata LQM21PN2R2MGH
L503: 10nH; L_0402_1005Metric; MPN Murata LQG15HS10NJ02D
R501: 10k; R_0603_1608Metric
R502: 1k; R_0603_1608Metric
R513: 0R; R_0603_1608Metric; not fitted
U501: STM32WBA55CGUx; QFN-48-1EP_7x7mm_P0.5mm_EP5.6x5.6mm; MPN STM32WBA55CGU6 (temp suffix TBD)
Y501: 32MHz; Crystal_NX1612SA; MPN NDK NX1612SA-32MHZ-EXS00A-CS09166
Y502: 32.768kHz; Crystal_NX1610SE; MPN NDK NX1610SE-32.768KHZ-EXS00A-MU01501

Connections:
+3V3: C501.1, C502.1, C503.1, C504.1, C505.1, C507.1, C512.1, C520.1, C521.1, FB501.1, J502.1 (VTref), R513.2, U501.8 (VDDA), U501.11 (VDD), U501.22 (VDD), U501.35 (VDD), U501.40 (VDDRF), U501.44 (VDD); also elsewhere on the board
/Main MCU STM32WBA55/CON_MAIN_TX: J503.2, U501.4 (PB12)
/Main MCU STM32WBA55/HSE_IN: U501.42 (OSC_IN), Y501.1
/Main MCU STM32WBA55/HSE_OUT: U501.41 (OSC_OUT), Y501.3
/Main MCU STM32WBA55/LED_MAIN: R502.1, U501.30 (PB2)
/Main MCU STM32WBA55/LED_MAIN_A: D501.2 (A), R502.2
/Main MCU STM32WBA55/LSE_IN: C518.1, U501.17 (PC14), Y502.1
/Main MCU STM32WBA55/LSE_OUT: C519.1, U501.16 (PC15), Y502.2
/Main MCU STM32WBA55/MAIN_BOOT0: R501.1, U501.34 (PH3)
/Main MCU STM32WBA55/MAIN_NRST: C508.1, J502.10 (~RESET), U501.36 (NRST)
/Main MCU STM32WBA55/MAIN_SWCLK: J502.4 (SWCLK/TCK), U501.26 (PA14)
/Main MCU STM32WBA55/MAIN_SWDIO: J502.2 (SWDIO/TMS), U501.27 (PA13)
/Main MCU STM32WBA55/MAIN_SWO: J502.6 (SWO/TDO), U501.24 (PB3)
/Main MCU STM32WBA55/RF_ANT: FL501.A3 (OUT), J501.1 (In)
/Main MCU STM32WBA55/RF_MCU: FL501.A1 (IN), U501.37 (RF)
/Main MCU STM32WBA55/WBA_VDD11: C509.1, C511.1, FB502.1, L501.2, U501.39 (VDDANA), U501.45 (VDD11)
/Main MCU STM32WBA55/WBA_VDDHPA: C510.1, U501.38 (VDDHPA)
/Main MCU STM32WBA55/WBA_VDDRFPA: C513.1, FB502.2, R513.1, U501.43 (VDDRFPA)
/Main MCU STM32WBA55/WBA_VDDSMPS: C506.1, FB501.2, U501.2 (VDDSMPS)
/Main MCU STM32WBA55/WBA_VLXSMPS: L503.1, U501.3 (VLXSMPS)
/Main MCU STM32WBA55/WBA_VLX_L: L501.1, L503.2
CHG_INT_N: U501.10 (PA2); also elsewhere on the board
CON_SUP_RX: J503.4; also elsewhere on the board
CON_SUP_TX: J503.3; also elsewhere on the board
ENC_A_M: U501.20 (PB6); also elsewhere on the board
ENC_B_M: U501.5 (PA8); also elsewhere on the board
ENC_I_M: U501.48 (PB14); also elsewhere on the board
FLY_PGOOD: U501.28 (PA12); also elsewhere on the board
GND: C501.2, C502.2, C503.2, C504.2, C505.2, C506.2, C507.2, C508.2, C509.2, C510.2, C511.2, C512.2, C513.2, C518.2, C519.2, C520.2, C521.2, D501.1 (K), FL501.A2 (GND4), FL501.B1 (GND3), FL501.B2 (GND2), FL501.B3 (GND1), J501.2 (Ext), J502.3 (GND), J502.5 (GND), J502.9 (GNDDetect), J503.1, R501.2, U501.1 (VSSSMPS), U501.49 (VSS), Y501.2 (G), Y501.4 (G); also elsewhere on the board
HB_M2S: U501.21 (PB5); also elsewhere on the board
HB_S2M: U501.12 (PA1); also elsewhere on the board
I2C_SCL: U501.7 (PA6); also elsewhere on the board
I2C_SDA: U501.6 (PA7); also elsewhere on the board
MCU_48V_EN: U501.19 (PB7); also elsewhere on the board
PMD_FAULT_M: U501.23 (PB4); also elsewhere on the board
PMD_MOSI_M: U501.15 (PB8); also elsewhere on the board
PMD_READY_M: U501.33 (PB15); also elsewhere on the board
PMD_SCLK_M: U501.13 (PA0); also elsewhere on the board
PMD_SS_M: U501.9 (PA5); also elsewhere on the board
RS485_DE: U501.31 (PB1); also elsewhere on the board
RS485_DI: U501.32 (PB0); also elsewhere on the board
RS485_RO: U501.29 (PA11); also elsewhere on the board
VBAT_SENSE: U501.14 (PB9); also elsewhere on the board

Notes on the sheet:
Pin map DERIVED from ST pin data in the KiCad STM32WBA55CGUx symbol; CONFIRM IN STM32CubeMX before layout freeze. Encoder on TIM2 CH1/CH2 (PB6/PA8) - TIM2 width must be confirmed in RM0493 (CF-21/FW-08). SPI3 -> PMD401 (mode 3, <= 500 kbit/s, PMD401 manual 150025-01 sec.5.2). USART2 + DE -> MAX3485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

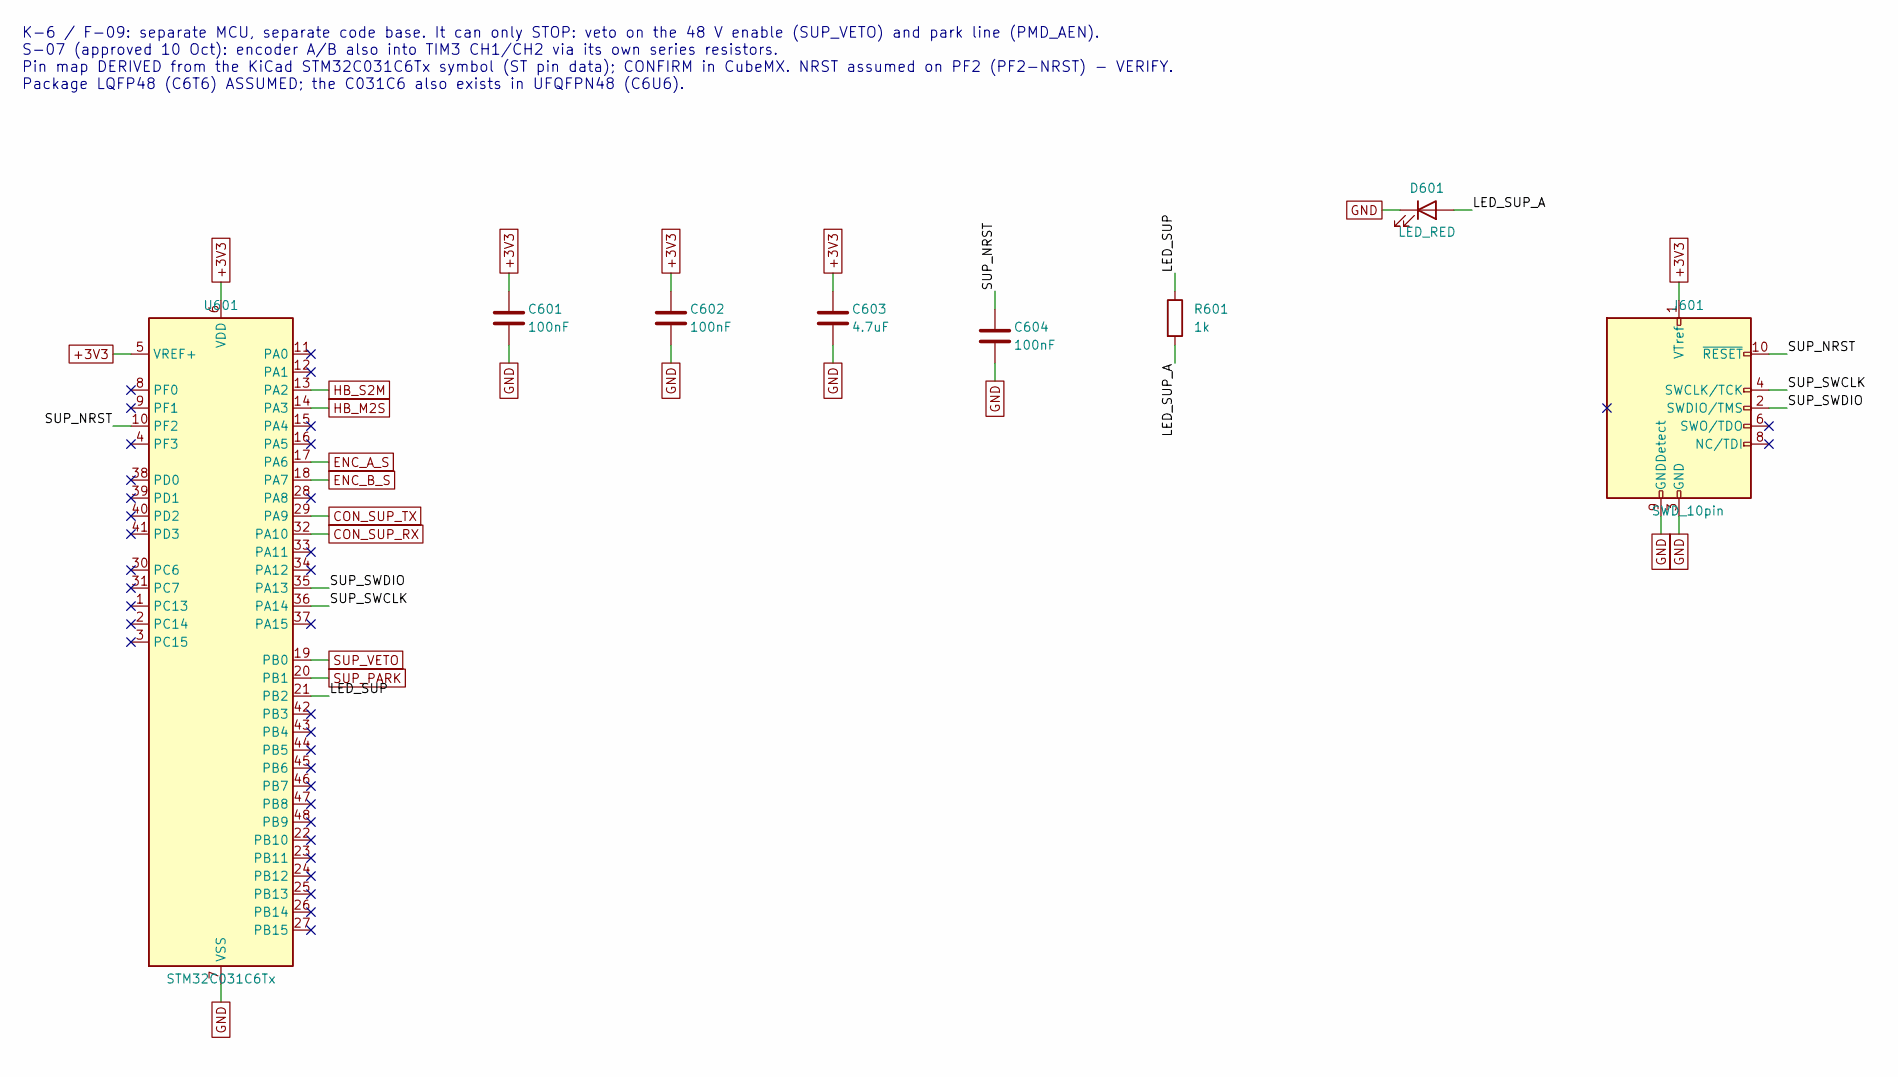
[picture p35: schematic mcu_supervisor.kicad_sch, Supervisor STM32C031C6: heartbeat, park line, 48 V veto, ow…]

Parts:
C601, C602, C604: 100nF; C_0603_1608Metric
C603: 4.7uF; C_0603_1608Metric
D601: LED_RED; LED_0603_1608Metric
J601: SWD_10pin; PinHeader_2x05_P1.27mm_Vertical
R601: 1k; R_0603_1608Metric
U601: STM32C031C6Tx; LQFP-48_7x7mm_P0.5mm; MPN STM32C031C6T6 (package ASSUMED)

Connections:
+3V3: C601.1, C602.1, C603.1, J601.1 (VTref), U601.5 (VREF+), U601.6 (VDD); also elsewhere on the board
/Supervisor STM32C031/LED_SUP: R601.1, U601.21 (PB2)
/Supervisor STM32C031/LED_SUP_A: D601.2 (A), R601.2
/Supervisor STM32C031/SUP_NRST: C604.1, J601.10 (~RESET), U601.10 (PF2)
/Supervisor STM32C031/SUP_SWCLK: J601.4 (SWCLK/TCK), U601.36 (PA14)
/Supervisor STM32C031/SUP_SWDIO: J601.2 (SWDIO/TMS), U601.35 (PA13)
CON_SUP_RX: U601.32 (PA10); also elsewhere on the board
CON_SUP_TX: U601.29 (PA9); also elsewhere on the board
ENC_A_S: U601.17 (PA6); also elsewhere on the board
ENC_B_S: U601.18 (PA7); also elsewhere on the board
GND: C601.2, C602.2, C603.2, C604.2, D601.1 (K), J601.3 (GND), J601.5 (GND), J601.9 (GNDDetect), U601.7 (VSS); also elsewhere on the board
HB_M2S: U601.14 (PA3); also elsewhere on the board
HB_S2M: U601.13 (PA2); also elsewhere on the board
SUP_PARK: U601.20 (PB1); also elsewhere on the board
SUP_VETO: U601.19 (PB0); also elsewhere on the board

Notes on the sheet:
K-6 / F-09: separate MCU, separate code base. It can only STOP: veto on the 48 V enable (SUP_VETO) and park line (PMD_AEN). S-07 (approved 10 Oct): encoder A/B also into TIM3 CH1/CH2 via its own series resistors. Pin map DERIVED from the KiCad STM32C031C6Tx symbol (ST pin data); CONFIRM in CubeMX. 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
