BigBiglinn/INSULIN_PUMP/hardware/kicad/pump_v2.kicad_pcb

## KiCad design hardware/kicad/pump_v2.kicad_pcb (continued)

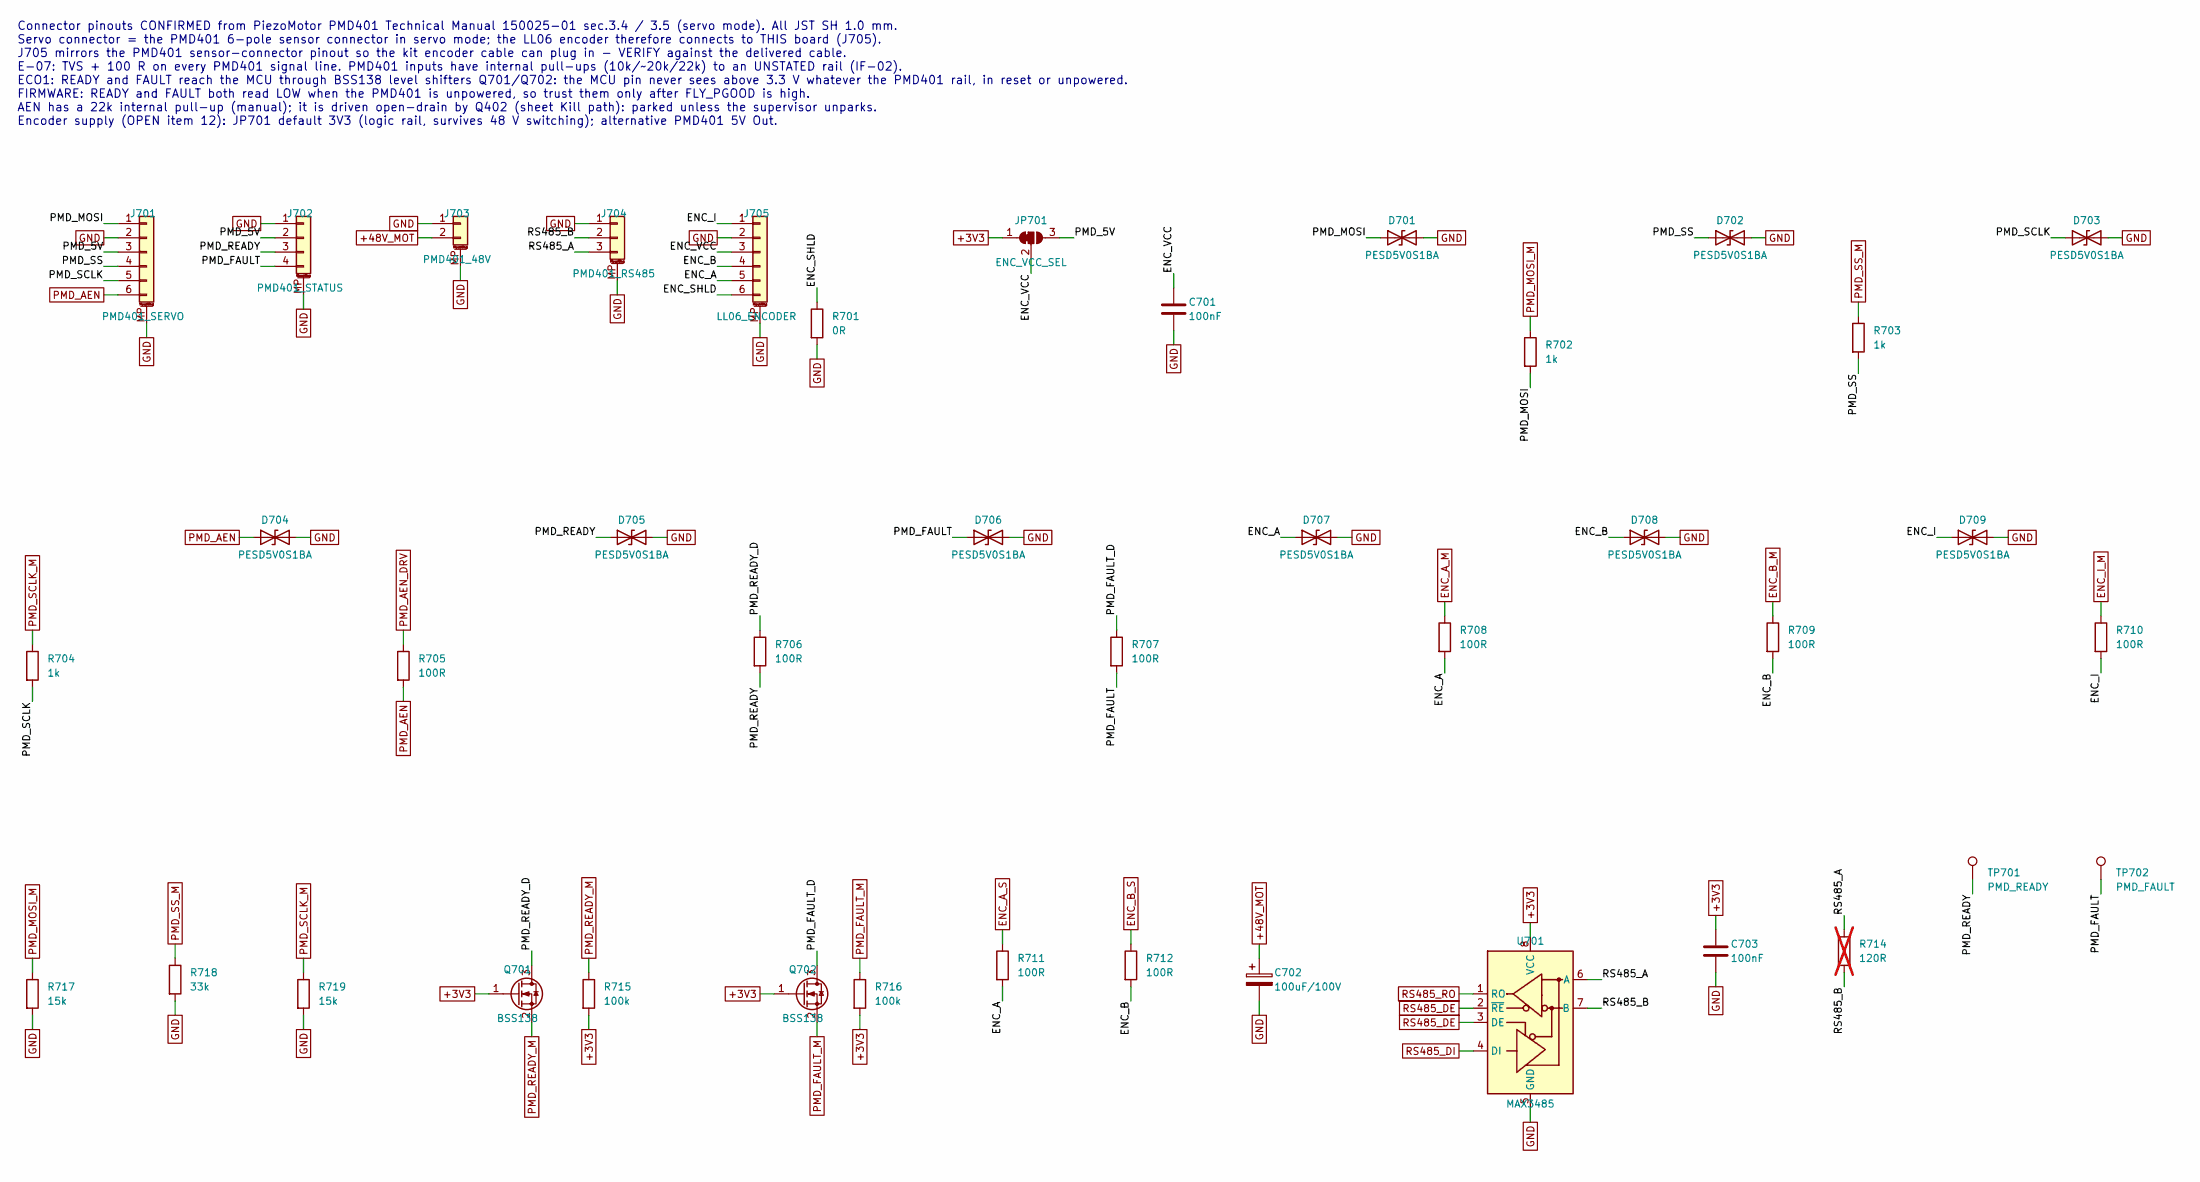
[picture p36: schematic pmd_interface.kicad_sch, PMD401 servo/status/power/RS-485 connectors, LL06 encoder, …]

Parts:
C701, C703: 100nF; C_0603_1608Metric
C702: 100uF/100V; CP_Radial_D12.5mm_P5.00mm
D701, D702, D703, D704, D705, D706, D707, D708, D709: PESD5V0S1BA; D_SOD-323; MPN Nexperia PESD5V0S1BA,115
J701: PMD401_SERVO; JST_SH_SM06B-SRSS-TB_1x06-1MP_P1.00mm_Horizontal; MPN JST SM06B-SRSS-TB
J702: PMD401_STATUS; JST_SH_SM04B-SRSS-TB_1x04-1MP_P1.00mm_Horizontal; MPN JST SM04B-SRSS-TB
J703: PMD401_48V; JST_SH_SM02B-SRSS-TB_1x02-1MP_P1.00mm_Horizontal; MPN JST SM02B-SRSS-TB
J704: PMD401_RS485; JST_SH_SM03B-SRSS-TB_1x03-1MP_P1.00mm_Horizontal; MPN JST SM03B-SRSS-TB
J705: LL06_ENCODER; JST_SH_SM06B-SRSS-TB_1x06-1MP_P1.00mm_Horizontal; MPN JST SM06B-SRSS-TB
JP701: ENC_VCC_SEL; SolderJumper-3_P1.3mm_Bridged12_RoundedPad1.0x1.5mm_NumberL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
Q701, Q702: BSS138; SOT-23; MPN BSS138 (e.g. Nexperia BSS138P)
R701: 0R; R_0603_1608Metric
R702, R703, R704: 1k; R_0603_1608Metric
R705, R706, R707, R708, R709, R710, R711, R712: 100R; R_0603_1608Metric
R714: 120R; R_0603_1608Metric; not fitted
R715, R716: 100k; R_0603_1608Metric
R717, R719: 15k; R_0603_1608Metric
R718: 33k; R_0603_1608Metric
TP701: PMD_READY; TestPoint_Pad_D1.0mm
TP702: PMD_FAULT; TestPoint_Pad_D1.0mm
U701: MAX3485; SOIC-8_3.9x4.9mm_P1.27mm; MPN MAX3485 SOIC-8 (suffix TBD)

Connections:
+3V3: C703.1, JP701.1 (A), Q701.1 (G), Q702.1 (G), R715.2, R716.2, U701.8 (VCC); also elsewhere on the board
+48V_MOT: C702.1, J703.2; also elsewhere on the board
/PMD401 & encoder interface/ENC_A: D707.1 (A1), J705.5, R708.2, R711.2
/PMD401 & encoder interface/ENC_B: D708.1 (A1), J705.4, R709.2, R712.2
/PMD401 & encoder interface/ENC_I: D709.1 (A1), J705.1, R710.2
/PMD401 & encoder interface/ENC_SHLD: J705.6, R701.1
/PMD401 & encoder interface/ENC_VCC: C701.1, J705.3, JP701.2 (C)
/PMD401 & encoder interface/PMD_5V: J701.3, J702.2, JP701.3 (B)
/PMD401 & encoder interface/PMD_FAULT: D706.1 (A1), J702.4, R707.2, TP702.1
/PMD401 & encoder interface/PMD_FAULT_D: Q702.3 (D), R707.1
/PMD401 & encoder interface/PMD_MOSI: D701.1 (A1), J701.1, R702.2
/PMD401 & encoder interface/PMD_READY: D705.1 (A1), J702.3, R706.2, TP701.1
/PMD401 & encoder interface/PMD_READY_D: Q701.3 (D), R706.1
/PMD401 & encoder interface/PMD_SCLK: D703.1 (A1), J701.5, R704.2
/PMD401 & encoder interface/PMD_SS: D702.1 (A1), J701.4, R703.2
/PMD401 & encoder interface/RS485_A: J704.3, R714.1, U701.6 (A)
/PMD401 & encoder interface/RS485_B: J704.2, R714.2, U701.7 (B)
ENC_A_M: R708.1; also elsewhere on the board
ENC_A_S: R711.1; also elsewhere on the board
ENC_B_M: R709.1; also elsewhere on the board
ENC_B_S: R712.1; also elsewhere on the board
ENC_I_M: R710.1; also elsewhere on the board
GND: C701.2, C702.2, C703.2, D701.2 (A2), D702.2 (A2), D703.2 (A2), D704.2 (A2), D705.2 (A2), D706.2 (A2), D707.2 (A2), D708.2 (A2), D709.2 (A2), J701.2, J701.MP (MountPin), J702.1, J702.MP (MountPin), J703.1, J703.MP (MountPin), J704.1, J704.MP (MountPin), J705.2, J705.MP (MountPin), R701.2, R717.2, R718.2, R719.2, U701.5 (GND); also elsewhere on the board
PMD_AEN: D704.1 (A1), J701.6, R705.2; also elsewhere on the board
PMD_AEN_DRV: R705.1; also elsewhere on the board
PMD_FAULT_M: Q702.2 (S), R716.1; also elsewhere on the board
PMD_MOSI_M: R702.1, R717.1; also elsewhere on the board
PMD_READY_M: Q701.2 (S), R715.1; also elsewhere on the board
PMD_SCLK_M: R704.1, R719.1; also elsewhere on the board
PMD_SS_M: R703.1, R718.1; also elsewhere on the board
RS485_DE: U701.2 (~RE), U701.3 (DE); also elsewhere on the board
RS485_DI: U701.4 (DI); also elsewhere on the board
RS485_RO: U701.1 (RO); also elsewhere on the board

Notes on the sheet:
Connector pinouts CONFIRMED from PiezoMotor PMD401 Technical Manual 150025-01 sec.3.4 / 3.5 (servo mode). All JST SH 1.0 mm. Servo connector = the PMD401 6-pole sensor connector in servo mode; the LL06 encoder therefore connects to THIS board (J705). J705 mirrors the PMD401 sensor-connector pinout 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

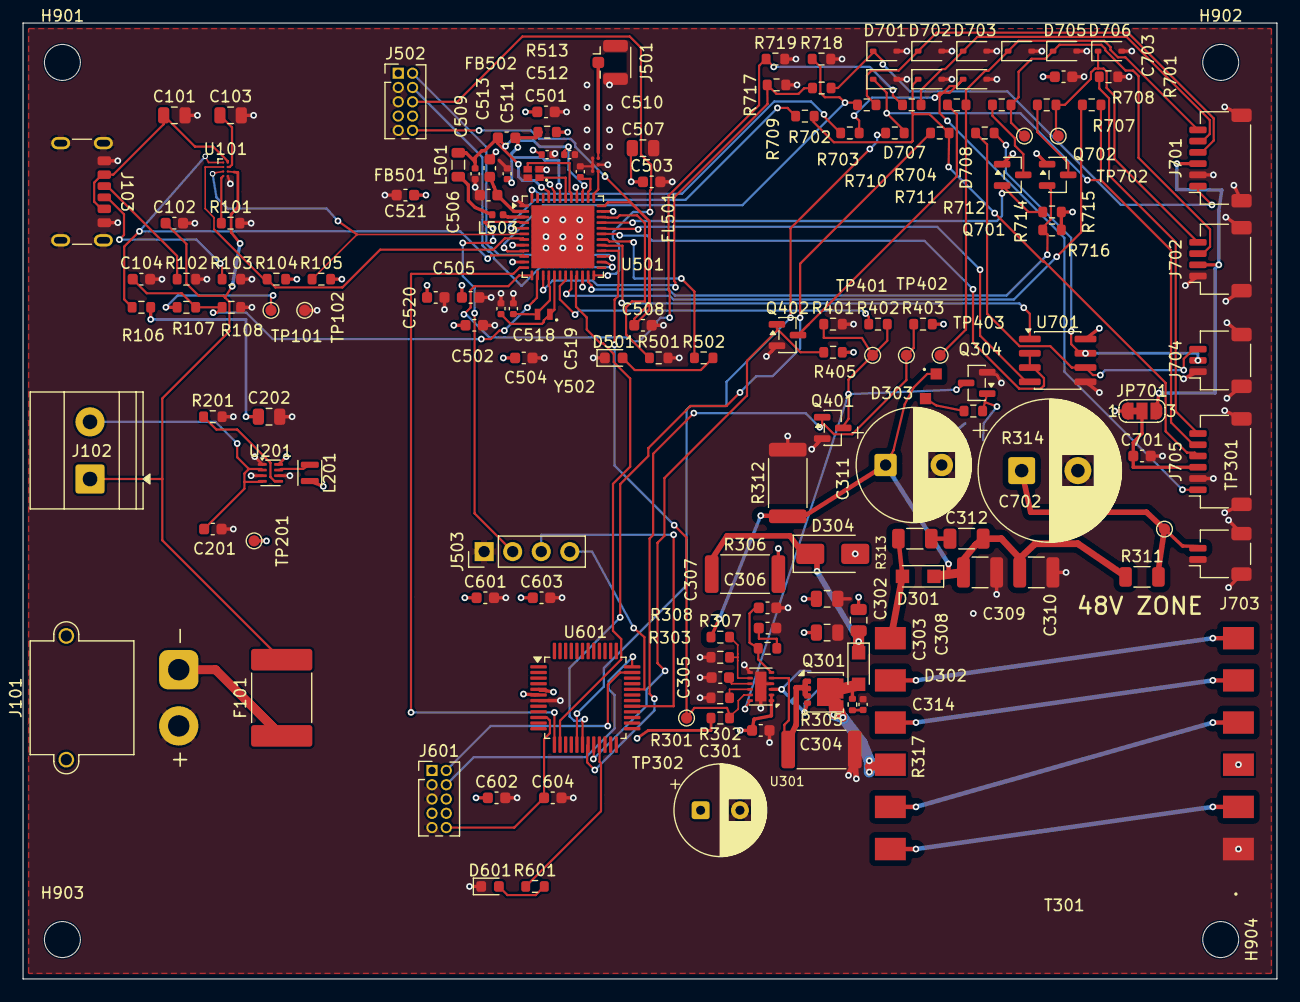
[picture p37: board pump_v2.kicad_pcb from above]

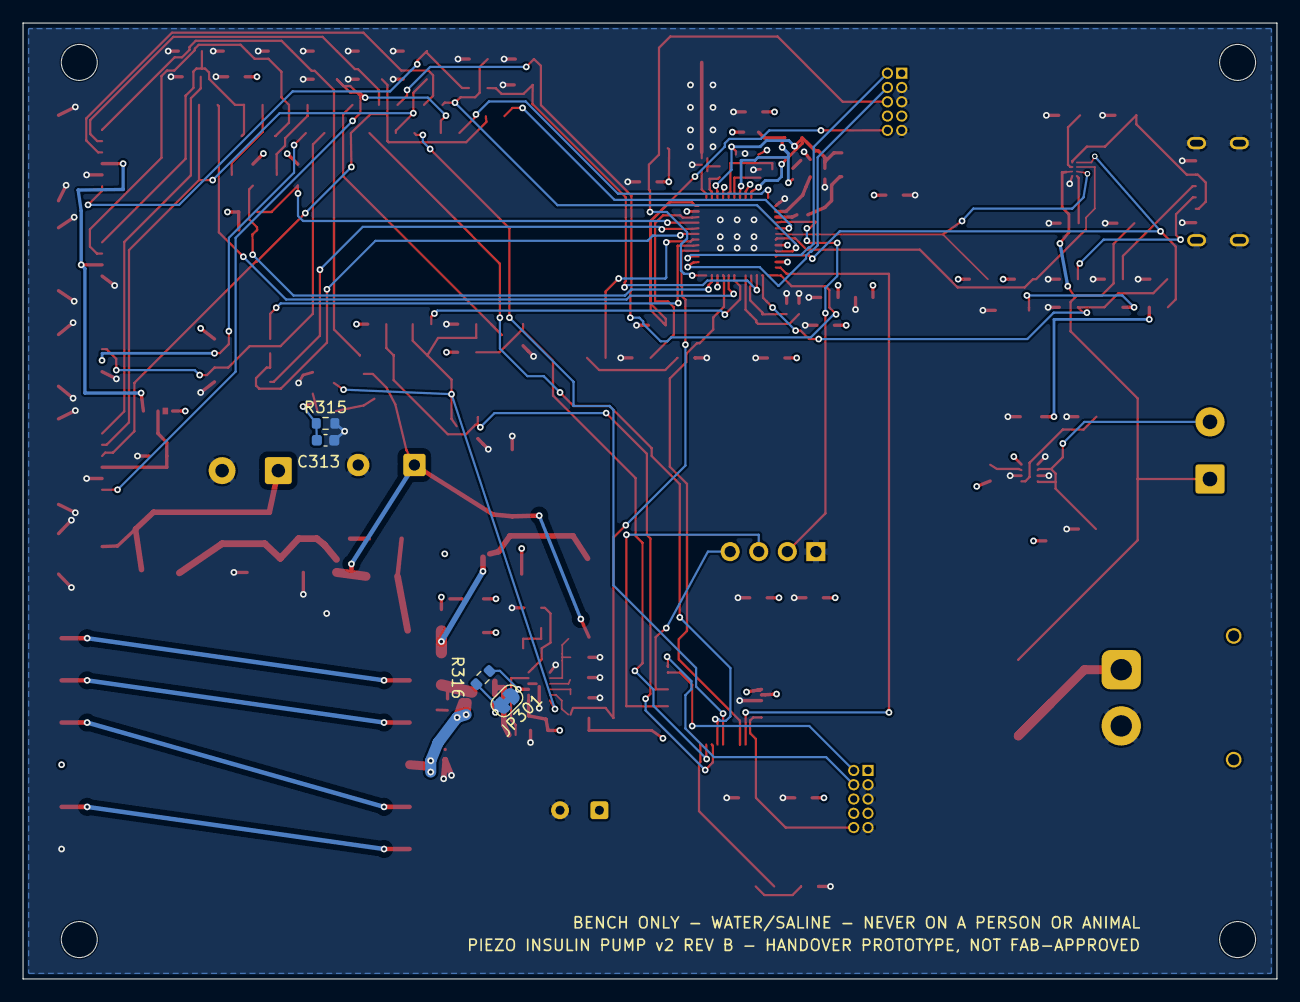
[picture p38: board pump_v2.kicad_pcb from below]

Board: 4 copper layers, 111.5 x 85.0 mm, 158 parts (4 on the bottom side), 101 nets.
