BigBiglinn/INSULIN_PUMP/scripts/gen_library.py

"""Generate the project symbol and footprint library for Piezo Insulin Pump v2.

Pin numbers and names come from the datasheets in docs/datasheets:
  LM51551   TI SNVSB75E Table 7-1, WSON-12 (DSS), EP = pad 13 (KiCad footprint numbering)
  BQ25188   TI SLUSFJ3 Table 5-1, DSBGA-8 (YBG) balls A1..D2
  TPS62840  TI SLVSEC6D Pin Functions, SON-8 (DLC)
Placeholder parts (flyback FET, transformer, output switch) carry no datasheet
claims; their pinout only matches the placeholder footprint.
"""
import os
import re

from kicadlib import FP_DIR, PROJECT_DIR, dump, get_symbol

LIB = "pump_v2"
F = '(effects (font (size 1.27 1.27)))'
FH = '(effects (font (size 1.27 1.27)) (hide yes))'


def pin(typ, x, y, ang, name, num, length=2.54):
    return (f'\t\t\t(pin {typ} line (at {x:g} {y:g} {ang}) (length {length:g})\n'
            f'\t\t\t\t(name "{name}" {F})\n\t\t\t\t(number "{num}" {F})\n\t\t\t)')


def box_symbol(name, ref, value, footprint, datasheet, desc, left, right, top=(), bottom=(),
               width=15.24, extra_props=()):
    """left/right/top/bottom: lists of (number, name, type) or None for a gap."""
    rows = max(len(left), len(right), 1)
    h = (rows + 1) * 2.54
    half_w = round(width / 2 / 2.54) * 2.54
    top_y = round(h / 2 / 2.54) * 2.54
    bot_y = top_y - (rows + 1) * 2.54
    pins = []
    for i, p in enumerate(left):
        if p:
            pins.append(pin(p[2], -half_w - 2.54, top_y - (i + 1) * 2.54, 0, p[1], p[0]))
    for i, p in enumerate(right):
        if p:
            pins.append(pin(p[2], half_w + 2.54, top_y - (i + 1) * 2.54, 180, p[1], p[0]))
    n = len(top)
    for i, p in enumerate(top):
        if p:
            x = (i - (n - 1) / 2) * 2.54
            pins.append(pin(p[2], x, top_y + 2.54, 270, p[1], p[0]))
    n = len(bottom)
    for i, p in enumerate(bottom):
        if p:
            x = (i - (n - 1) / 2) * 2.54
            pins.append(pin(p[2], x, bot_y - 2.54, 90, p[1], p[0]))
    props = [("Reference", ref, False, top_y + 5.08), ("Value", value, False, bot_y - 5.08),
             ("Footprint", footprint, True, 0), ("Datasheet", datasheet, True, 0),
             ("Description", desc, True, 0)] + [(k, v, True, 0) for k, v in extra_props]
    ptxt = "\n".join(
        f'\t\t(property "{k}" "{v}" (at 0 {y:g} 0) {FH if hide else F})' for k, v, hide, y in props)
    return f'''\t(symbol "{name}"
\t\t(pin_names (offset 1.016))
\t\t(exclude_from_sim no) (in_bom yes) (on_board yes)
{ptxt}
\t\t(symbol "{name}_0_1"
\t\t\t(rectangle (start {-half_w:g} {top_y:g}) (end {half_w:g} {bot_y:g})
\t\t\t\t(stroke (width 0.254) (type default)) (fill (type background)))
\t\t)
\t\t(symbol "{name}_1_1"
{chr(10).join(pins)}
\t\t)
\t\t(embedded_fonts no)
\t)'''


def mosfet_symbol(name, value, footprint, desc, pchan, gate_nums, source_nums, drain_nums):
    """Simple box-style MOSFET with numbered pins (stacked pins share a name)."""
    left = [(n, "G", "input") for n in gate_nums]
    right = [(n, "D", "passive") for n in drain_nums] + [None] + [(n, "S", "passive") for n in source_nums]
    return box_symbol(name, "Q", value, footprint, "", desc, left, right, width=10.16)


def symbols():
    out = []
    out.append(box_symbol(
        "LM51551", "U", "LM51551DSSR", "Package_SON:WSON-12-1EP_3x2mm_P0.5mm_EP1x2.65",
        "https://www.ti.com/lit/ds/symlink/lm51551.pdf",
        "Boost/SEPIC/flyback controller, hiccup OCP, WSON-12 (TI SNVSB75E)",
        left=[("1", "BIAS", "power_in"), ("2", "VCC", "passive"), ("12", "UVLO/EN/SYNC", "input"),
              ("10", "RT", "passive"), ("9", "SS", "passive"), ("11", "PGOOD", "open_collector")],
        right=[("3", "GATE", "output"), ("5", "CS", "input"), ("8", "FB", "input"),
               ("6", "COMP", "passive"), ("4", "PGND", "power_in"), ("7", "AGND", "power_in")],
        bottom=[("13", "EP", "passive")], width=20.32,
        extra_props=[("MPN", "LM51551DSSR")]))
    out.append(box_symbol(
        "BQ25188", "U", "BQ25188YBGR", "pump_v2:TI_YBG0008_DSBGA-8_P0.4mm_UNVERIFIED",
        "https://www.ti.com/lit/ds/symlink/bq25188.pdf",
        "I2C 1-cell 1 A linear charger with power path, DSBGA-8 (TI SLUSFJ3)",
        left=[("A2", "IN", "power_in"), ("B1", "SCL", "input"), ("C1", "SDA", "bidirectional"),
              ("A1", "~{INT}", "open_collector"), ("D1", "TS/MR", "bidirectional")],
        right=[("B2", "SYS", "power_out"), ("C2", "BAT", "passive"), None, None, ("D2", "GND", "power_in")],
        width=17.78, extra_props=[("MPN", "BQ25188YBGR")]))
    out.append(box_symbol(
        "TPS62840DLC", "U", "TPS62840DLCR", "Package_SON:Texas_VSON-HR-8_1.5x2mm_P0.5mm",
        "https://www.ti.com/lit/ds/symlink/tps62840.pdf",
        "750 mA ultra-low-Iq step-down, VSET-programmed, SON-8 DLC (TI SLVSEC6D)",
        left=[("2", "VIN", "power_in"), ("4", "EN", "input"), ("3", "MODE", "input"),
              ("6", "STOP", "input"), ("5", "VSET", "passive")],
        right=[("7", "SW", "power_out"), ("8", "VOS", "input"), None, None, ("1", "GND", "power_in")],
        width=15.24, extra_props=[("MPN", "TPS62840DLCR")]))
    # placeholders ------------------------------------------------------
    out.append(mosfet_symbol(
        "Q_NMOS_TDSON8_TBD", "NMOS_TBD", "Package_TO_SOT_SMD:TDSON-8-1",
        "PLACEHOLDER flyback switch, logic-level N-MOSFET, part and package TBD",
        False, ["4"], ["1", "2", "3"], ["5"]))
    out.append(mosfet_symbol(
        "Q_PMOS_SOT23_TBD", "PMOS_TBD", "Package_TO_SOT_SMD:SOT-23",
        "PLACEHOLDER high-side P-MOSFET (>=100 V class), part and package TBD",
        True, ["1"], ["2"], ["3"]))
    out.append(mosfet_symbol(
        "CSD16340Q3", "CSD16340Q3", "Package_SON:VSON-8_3.3x3.3mm_P0.65mm_NexFET",
        "TI CSD16340Q3 25 V N-channel NexFET, SON 3.3x3.3 (pins 1-3 S, 4 G, 5-8 D = pad 5)",
        False, ["4"], ["1", "2", "3"], ["5"]))
    out.append(mosfet_symbol(
        "Q_NMOS_SOT23_TBD", "NMOS_TBD", "Package_TO_SOT_SMD:SOT-23",
        "PLACEHOLDER level-shift N-MOSFET (>=100 V class), part and package TBD",
        False, ["1"], ["2"], ["3"]))
    out.append(box_symbol(
        "HPH6-0090L", "T", "HPH6-0090L", "pump_v2:Coilcraft_HPH6", "https://www.coilcraft.com/getmedia/936400ae-3cbc-4381-aed1-ae101ef7a35e/hexa-path.pdf",
        "Coilcraft Hexa-Path six 1:1 windings; dots on pins 1-6 (Doc 613-1)",
        left=[(str(i), f"{i}_DOT", "passive") for i in (1, 2, 3, 4, 5, 6)],
        right=[(str(i), str(i), "passive") for i in (12, 11, 10, 9, 8, 7)], width=15.24,
        extra_props=[("MPN", "HPH6-0090L")]))
    out.append(box_symbol(
        "MLPF-WB-04D3", "FL", "MLPF-WB-04D3", "pump_v2:ST_MLPF-WB-04D3", "https://www.st.com/resource/en/datasheet/mlpf-wb-04d3.pdf",
        "ST 2.4 GHz low-pass filter matched to STM32WBA QFN/BGA, 50 ohm output (DS14446)",
        left=[("A1", "IN", "passive"), ("A3", "OUT", "passive")],
        right=[("A2", "GND4", "passive"), ("B1", "GND3", "passive"), ("B2", "GND2", "passive"), ("B3", "GND1", "passive")],
        width=15.24, extra_props=[("MPN", "MLPF-WB-04D3")]))
    return out


def max3485_symbol():
    """KiCad's MAX3485 is a derived symbol; a flattened project copy keeps the schematic and library in step."""
    sym = get_symbol("Interface_UART:MAX3485")
    sym[1] = '"MAX3485"'
    return dump(sym, 1)


def write_symbol_lib():
    os.makedirs(PROJECT_DIR, exist_ok=True)
    txt = ('(kicad_symbol_lib\n\t(version 20241209)\n\t(generator "pump_v2_gen")\n'
           '\t(generator_version "10.0")\n' + "\n".join(list(symbols()) + [max3485_symbol()]) + "\n)\n")
    with open(os.path.join(PROJECT_DIR, LIB + ".kicad_sym"), "w", encoding="utf8") as f:
        f.write(txt)


# ---------------------------------------------------------------- footprints
def fp_header(name, descr, attr="smd"):
    return [f'(footprint "{name}"', '\t(version 20241229)', '\t(generator "pump_v2_gen")',
            '\t(layer "F.Cu")', f'\t(descr "{descr}")', f'\t(attr {attr})']


def fp_prop(name, value, x, y, layer, hide=False):
    h = " (hide yes)" if hide else ""
    return (f'\t(property "{name}" "{value}" (at {x:g} {y:g} 0) (layer "{layer}"){h}\n'
            f'\t\t(effects (font (size 1 1) (thickness 0.15))))')


def fp_rect(x1, y1, x2, y2, layer, w):
    return (f'\t(fp_rect (start {x1:g} {y1:g}) (end {x2:g} {y2:g}) '
            f'(stroke (width {w:g}) (type solid)) (fill no) (layer "{layer}"))')


def write_xfmr_placeholder(d):
    s = 6.0
    lines = fp_header("XFMR_PLACEHOLDER_4P",
                      "PLACEHOLDER 12x12 mm flyback transformer outline. NOT a real land pattern: "
                      "replace once the transformer part is chosen (OPEN B.16)")
    lines += [fp_prop("Reference", "REF**", 0, -s - 1.5, "F.SilkS"),
              fp_prop("Value", "XFMR_PLACEHOLDER_4P", 0, s + 1.5, "F.Fab"),
              fp_rect(-s, -s, s, s, "F.Fab", 0.1), fp_rect(-s - 0.25, -s - 0.25, s + 0.25, s + 0.25, "F.CrtYd", 0.05),
              fp_rect(-s - 0.12, -s - 0.12, s + 0.12, s + 0.12, "F.SilkS", 0.12),
              '\t(fp_text user "PLACEHOLDER" (at 0 0 0) (layer "F.SilkS") (effects (font (size 1 1) (thickness 0.15))))',
              '\t(fp_circle (center -4.5 -1.2) (end -4.2 -1.2) (stroke (width 0.12) (type solid)) (fill yes) (layer "F.SilkS"))']
    pads = {"1": (-4.5, -3.5), "2": (-4.5, 3.5), "3": (4.5, -3.5), "4": (4.5, 3.5)}
    for n, (x, y) in pads.items():
        lines.append(f'\t(pad "{n}" smd rect (at {x:g} {y:g}) (size 2.5 2.5) (layers "F.Cu" "F.Paste" "F.Mask"))')
    lines += ["\t(embedded_fonts no)", ")"]
    with open(os.path.join(d, "XFMR_PLACEHOLDER_4P.kicad_mod"), "w", encoding="utf8") as f:
        f.write("\n".join(lines) + "\n")


def write_ybg_placeholder(d):
    """Copy the 2x4, 0.4 mm-pitch ball pads from KiCad's Texas DSBGA-8 footprint.

    The BQ25188 YBG mechanical drawing could not be text-extracted, so the 0.4 mm
    pitch is an inference from the 1.6 x 1.1 mm body (0.5 mm would leave 0.05 mm
    edge margin). Marked UNVERIFIED in the name.
    """
    src = os.path.join(FP_DIR, "Package_BGA.pretty", "Texas_DSBGA-8_0.705x1.468mm_Layout2x4_P0.4mm.kicad_mod")
    with open(src, encoding="utf8") as f:
        txt = f.read()
    pads = re.findall(r'\(pad "[A-D][12]".*?\n\t\)', txt, re.S)
    if not pads:
        raise RuntimeError("could not copy DSBGA pads")
    w, h = 1.1 / 2, 1.6 / 2
    lines = fp_header("TI_YBG0008_DSBGA-8_P0.4mm_UNVERIFIED",
                      "BQ25188 YBG 1.1x1.6 mm body; ball pads copied from KiCad Texas_DSBGA-8 2x4 P0.4mm. "
                      "Pitch NOT verified against TI YBG0008 drawing")
    lines += [fp_prop("Reference", "REF**", 0, -h - 1.0, "F.SilkS"),
              fp_prop("Value", "TI_YBG0008_UNVERIFIED", 0, h + 1.0, "F.Fab"),
              fp_rect(-w, -h, w, h, "F.Fab", 0.1), fp_rect(-w - 0.25, -h - 0.25, w + 0.25, h + 0.25, "F.CrtYd", 0.05),
              f'\t(fp_line (start {-w-0.12:g} {-h-0.12:g}) (end {-w+0.3:g} {-h-0.12:g}) (stroke (width 0.12) (type solid)) (layer "F.SilkS"))',
              f'\t(fp_line (start {-w-0.12:g} {-h-0.12:g}) (end {-w-0.12:g} {-h+0.3:g}) (stroke (width 0.12) (type solid)) (layer "F.SilkS"))']
    lines += ["\t" + p.replace("\n", "\n") for p in pads]
    lines += ["\t(embedded_fonts no)", ")"]
    with open(os.path.join(d, "TI_YBG0008_DSBGA-8_P0.4mm_UNVERIFIED.kicad_mod"), "w", encoding="utf8") as f:
        f.write("\n".join(lines) + "\n")


def write_simple_fp(d, name, descr, w, h, pad_lines, crt=0.25):
    """Footprint with a body outline and courtyard. w and h are half sizes."""
    lines = fp_header(name, descr)
    lines += [fp_prop("Reference", "REF**", 0, -h - 1.0, "F.SilkS"),
              fp_prop("Value", name, 0, h + 1.0, "F.Fab"),
              fp_rect(-w, -h, w, h, "F.Fab", 0.1), fp_rect(-w - crt, -h - crt, w + crt, h + crt, "F.CrtYd", 0.05),
              f'\t(fp_circle (center {-w - 0.35:g} {-h:g}) (end {-w - 0.25:g} {-h:g}) (stroke (width 0.1) (type solid)) (fill yes) (layer "F.SilkS"))']
    lines += pad_lines + ["\t(embedded_fonts no)", ")"]
    with open(os.path.join(d, name + ".kicad_mod"), "w", encoding="utf8") as f:
        f.write("\n".join(lines) + "\n")


def smd(n, x, y, sx, sy):
    return f'\t(pad "{n}" smd rect (at {x:g} {y:g}) (size {sx:g} {sy:g}) (layers "F.Cu" "F.Paste" "F.Mask"))'


def write_eco1_footprints(d):
    # Coilcraft Doc 613-5 recommended land: pads 2.75 x 2.00, 28.2 mm between inner edges, 3.75 mm pitch
    x = 28.2 / 2 + 2.75 / 2
    ys = [-9.375, -5.625, -1.875, 1.875, 5.625, 9.375]
    pads = [smd(i + 1, -x, ys[i], 2.75, 2.0) for i in range(6)] + [smd(12 - i, x, ys[i], 2.75, 2.0) for i in range(6)]
    write_simple_fp(d, "Coilcraft_HPH6", "Coilcraft HP6/HPH6 land per Doc 613-5; body 32.65 x 26.75 x 13.6 mm max", 14.9, 13.375, pads, crt=0.1)
    # DS14446 Table 4 / Fig. 15: 0.32 mm copper, 0.22 mm solder-mask-defined opening and stencil
    e, f = 0.25, 0.577
    bumps = {"A1": (-e, -f), "B1": (e, -f), "A2": (-e, 0), "B2": (e, 0), "A3": (-e, f), "B3": (e, f)}
    pads = [f'\t(pad "{n}" smd circle (at {px:g} {py:g}) (size 0.32 0.32) (layers "F.Cu" "F.Paste" "F.Mask") '
            f'(solder_mask_margin -0.05) (solder_paste_margin -0.05))' for n, (px, py) in bumps.items()]
    write_simple_fp(d, "ST_MLPF-WB-04D3", "ST MLPF-WB-04D3 CSPG 6 bumps, land per DS14446 sec.3", 0.5, 0.8, pads)
    # Pad geometry read from ST's MB1803 B-01 board file (components X2 and X1)
    pads = [smd(1, -0.525, -0.375, 0.75, 0.6), smd(2, 0.525, -0.375, 0.75, 0.6),
            smd(3, 0.525, 0.375, 0.75, 0.6), smd(4, -0.525, 0.375, 0.75, 0.6)]
    write_simple_fp(d, "Crystal_NX1612SA", "NDK NX1612SA 1.6 x 1.2 mm, land from ST MB1803 B-01", 0.8, 0.6, pads)
    pads = [smd(1, -0.55, 0, 0.5, 1.0), smd(2, 0.55, 0, 0.5, 1.0)]
    write_simple_fp(d, "Crystal_NX1610SE", "NDK NX1610SE 1.6 x 1.0 mm, land from ST MB1803 B-01", 0.8, 0.5, pads)
    # BZX84 SOT-23: physical pin 3 = cathode, pin 1 = anode. Pads are numbered for Device:D_Zener (1 = K, 2 = A).
    pads = [smd(2, -0.95, 1.1, 1.0, 1.0), smd(1, 0, -1.1, 1.0, 1.0)]
    write_simple_fp(d, "SOT-23_Zener_A1_K3", "SOT-23 zener: pad 1 (K) at package pin 3, pad 2 (A) at package pin 1; package pin 2 NC", 0.7, 1.5, pads)


def write_footprints():
    d = os.path.join(PROJECT_DIR, LIB + ".pretty")
    os.makedirs(d, exist_ok=True)
    write_xfmr_placeholder(d)
    write_ybg_placeholder(d)
    write_eco1_footprints(d)


if __name__ == "__main__":
    write_symbol_lib()
    write_footprints()
    print("library written to", PROJECT_DIR)
