BigBiglinn/INSULIN_PUMP/(commit log)

2026-10-10 Baseline: Piezo Insulin Pump v2 handoff documents (10 Oct 2026)
2026-10-10 Stage 1: hierarchical Rev B handover schematic (8 sheets, 149 parts), project library, ERC report
    Generated by scripts/gen_schematic.py from scripts/design.py. ERC: 6 errors (WBA55 supply pins
    pending ST datasheet) + 1 library-sync warning; documented, not suppressed.
    [mcu_main.kicad_sch, mcu_supervisor.kicad_sch, pmd_interface.kicad_sch, power_3v3.kicad_sch, power_48v.kicad_sch, power_input.kicad_sch, pump_v2.kicad_sch, safety.kicad_sch]
2026-10-10 Stage 2: placed 4-layer PCB with planes and plane fan-out (unrouted); BOMs; handover docs draft
    - gen_pcb.py: netlist-driven board build, zone placement, edge connectors, In1 GND / In2 VBAT+3V3 planes,
    130 SMD plane pads fanned out to vias, Specctra DSN export (inner layers as power planes)
    - pump_v2.kicad_dru: J703 vendor-connector pitch exception (scoped)
    - Net classes corrected (planes and fine-pitch nets stay Default)
    - docs/bom.csv, docs/bom_detailed.csv, docs/handover/*, decision log section 6
    [bom.csv, bom_detailed.csv, power_48v.kicad_sch, pump_v2.kicad_pcb]
2026-10-10 Stage 3a: first autorouted board (Freerouting), DRC report
    [pump_v2.kicad_pcb]
2026-10-10 Stage 3b: incremental autoroute pass 2 (64 unconnected, 0 clearance errors)
    [pump_v2.kicad_pcb]
2026-10-10 Stage 3c: autoroute pass 3 (63 unconnected), run_checks.sh, stitch.py
    [pump_v2.kicad_pcb]
2026-10-10 Stage 4: final ERC/DRC reports, unrouted-net list, renders, schematic PDF, handover docs completed
    ERC: 6 errors (WBA55 supply pins pending ST datasheet, intentional) + 1 cosmetic warning.
    DRC: 0 copper violations, 0 parity issues; 63 unconnected items (routing incomplete, U-21).
2026-10-10 Design v2: veto pull-up + open-drain AEN (owner decisions), flyback power stage dimensioned and simulated, BQ25188 config, VBAT sense
    - R403 fitted (veto ON by default), R404 removed; Q402 BSS138 + R405 park AEN by default (R713 removed)
    - Flyback: RT 73.2k (298 kHz), SS 47n, Rs 22m, VCC 2.2u, prelim. compensation; Q301 TI CSD16340Q3;
    D301 Nexperia PNE20010ER 200 V + R313/C312 snubber; D302 PMEG10020ELR; clamp 390R/22n (LTspice open-loop runs)
    - T301 transformer still PLACEHOLDER with full specification (docs/handover/FLYBACK_DESIGN.md)
    - BQ25188: R101 10k per SLUSFJ3 (TS unused), defaults documented; VBAT divider 1M/1M + 100n fitted
    - verify_pinmap.py: both MCU pin maps checked against ST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
    [mcu_supervisor.kicad_sch, pmd_interface.kicad_sch, power_48v.kicad_sch, power_input.kicad_sch, safety.kicad_sch]
2026-10-10 PCB v2: regenerated for design v2, compact flyback loop placement, routing pass 1 (42 unconnected, 0 copper violations)
    [pump_v2.kicad_pcb]
2026-10-10 Routing pass 2 (37 unconnected), hand_route.py, zone island removal, docs registers updated
    [pump_v2.kicad_pcb]
2026-10-10 Checkpoint after hand_route.py (2 connections added: +3V3, RS485_B); FINAL_HANDOVER draft; guide updates
    State saved before re-running connectivity/DRC checks (session interrupted by network drop).
    [pump_v2.kicad_pcb]
2026-10-10 Re-run ERC/DRC after network interruption: classified unrouted report (35 items: 12 placeholder, 1 DNP-only, 22 genuine)
2026-10-10 Blocker-resolution report (docs only; schematic/PCB unchanged) and read-only unrouted-corridor analysis
2026-10-10 Apply approved v2 placement (no M8, R711/R712 and R312 unmoved); rip-up only, not re-routed
    - gen_pcb.py: new `move` sub-command (whole-net rip-up of signal nets on moved pads,
    plane-stub removal and restricted re-fan-out, refill); fanout() gains only/seed_existing.
    - compare_placement.py: read-only baseline comparison and unrouted classification.
    - ERC unchanged (6 intentional + 1 mismatch); DRC 0 copper violations, 0 parity;
    unconnected 35 -> 80 (53 opened by the rip-up, pending staged re-route).
    - Board is NOT fully connected and NOT fabrication-ready. Baseline: tag baseline-routing-e8d141c.
    [pump_v2.kicad_pcb]
2026-10-10 Re-export stale BOMs from the unchanged schematic (export refresh only) and document every difference
    Differences all originate in schematic commit 51575de (Design v2); schematic sheets are identical
    to tag baseline-routing-e8d141c. No component, value, footprint or status edited here.
    [bom.csv, bom_detailed.csv]
2026-10-10 Pre-routing reconciliation of the 80 unconnected pairs, topology gate, FLY_EN/HB_S2M intent (checkpoint before stage 1)
2026-10-11 Stage 1a checkpoint: explicit gate/Kelvin-sense/CS-path/VCC/PGND routes (validation/routing/stage1_hand.json); route_stage.py
    DRC after these routes: 0 copper violations, 0 parity, 75 unconnected (was 80). Freerouting part of stage 1 not yet run.
    Board NOT fully connected, NOT fabrication-ready.
    [pump_v2.kicad_pcb]
2026-10-11 Stage 1 routing: LM51551 controller nets (FB, SS, RT, COMP, COMP_RC, local PGOOD) with explicit DRC-checked routes
    - ERC unchanged (6 intentional + 1 cosmetic); DRC 0 copper violations, 0 parity; warnings identical
    - Unconnected 80 -> 67 (13 closures); no copper changed outside the stage nets (compare_stage.py)
    - FLY_PGOOD U301.11 -> R302 blocked: needs approval (rotation, FL-3 AGND tie, or FLY_EN escape trade)
    - Freerouting not used: it ignored -inc/-mp; its output was discarded
    - Board NOT fully connected, NOT fabrication-ready
    [pump_v2.kicad_pcb]
2026-10-11 Living handoff CURRENT_STATUS.md: net-by-net audit of the 67 unconnected pairs, proposed routing order, decision gates D1-D6 (docs only, no copper change)
2026-10-11 Stage 2 routing: ENC_VCC, PMD_5V, CON_SUP_TX/RX (explicit DRC-checked routes); handoff doc updated with owner rulings D1-D6
    - Unconnected 67 -> 61 (6 closures); no copper changed outside the stage nets (compare_stage.py)
    - +3V3 to R302 moved to the approved D1 milestone (rotation moves that pad); SW48 concern documented (D2 deferred)
    - Freerouting not used (ignored settings-file limits too); no electrical testing performed
    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
    [pump_v2.kicad_pcb]
2026-10-11 D1 milestone: rotate R301/R302/C305/R308 180 deg; re-route FB/SS/RT and GND fan-outs; FLY_PGOOD U301.11-R302 and +3V3 to R302
    - Owner-approved option 1; explicit routes (validation/routing/d1_rotation.json), no Freerouting
    - ERC unchanged (6 intentional + 1 cosmetic); DRC 0 copper violations, 0 parity; dangling unchanged
    - Unconnected 61 -> 59; only the four rotated footprints changed; copper changed only on FB/SS/RT/PGOOD and local GND/+3V3 stubs
    - Grounding topology unchanged (each GND pad keeps its own plane via); FLY_EN escape site verified still free
    - Silkscreen 82/73 -> 83/71: rotated reference text only (cosmetic)
    - Board incomplete, electrically untested, NOT fabrication-ready
    [pump_v2.kicad_pcb]
2026-10-11 Stage 3 routing: safety-control nets FLY_EN (without DNP Q303) and HB_S2M, explicit DRC-checked routes
    - Pre-routing review: LM51551 UVLO/EN/SYNC (SNVSB75E), BSS138 pinout (Nexperia), CubeMX pin map; Q303 left unconnected (U-06)
    - ERC unchanged (6 intentional + 1 cosmetic); DRC 0 copper violations, 0 parity; warnings identical; no footprint changes
    - Unconnected 59 -> 54; copper added only on FLY_EN / HB_S2M; full-route margins >= 0.199 mm (rule 0.15)
    - HB_S2M routed around the WBA55 supply-placeholder block (64.9 mm) to avoid pre-empting D5
    - Routing proves continuity only: SG-03/SG-05 and heartbeat behaviour untested; board NOT fabrication-ready
    [pump_v2.kicad_pcb]
2026-10-11 Stage 4 routing: encoder connections ENC_B x3, ENC_I, ENC_A_S, ENC_B_S (explicit, DRC-checked)
    - New scripts/grid_route.py: deterministic one-connection two-layer router with existing copper fixed and
    owner keep-outs (WBA55/RF/crystal region, flyback/48 V block); keep-out bug found and fixed before use
    - Unconnected 54 -> 48; copper added only on the four encoder nets; margins >= 0.199 mm on new copper
    - RS485_B -> R714 untouched (owner decision pending)
    - New concern recorded: Stage 3 HB_S2M passes 0.60 mm from LSE crystal Y502 and crosses LSE_OUT (opposite layer)
    - Bo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
    [pump_v2.kicad_pcb]
2026-10-11 Stage 5a: verify MAIN_SWCLK, PMD_READY_M, FLY_PGOOD->U501.28; all three left open with blockers (no copper change)
    - FLY_PGOOD: electrically confirmed (PA12, open-drain to +3V3) but U501 pin 28 is boxed in by pre-existing
    RS485_RO/LED_MAIN escapes; needs approval to re-route them (D7)
    - PMD_READY_M: PMD401 Ready pull-up rail not stated; PB15 5 V tolerance unverified (U-10, needs DS14127) (D8)
    - MAIN_SWCLK: completion must cross the LSE pin-escape area (crystal layout, D5) or re-route approved SWD copper
    - Board identical to route-stage4-done: ERC 6+1, DRC 0 copper / 0 parity, 48 unconnected
    - HB_S2M/Y502 proximity recorded as outstanding pending ST crystal-layout documentation
    - Board elec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
2026-10-11 D7 investigation (scratch only, no copper change): re-routing U501 pin 29/30 escapes cannot free pin 28
    - Pin 28 boxed by RS485_RO (0.163 mm) and LED_MAIN diagonals; no legal via position east of the pad
    - Root cause: 2.2 mm escape pocket bounded by MAIN_BOOT0/MAIN_NRST/WBA_VDDHPA/MAIN_SWO verticals, with
    RS485_DI/RS485_DE vias in front of pins 30/29, and enclosed by the RF_ANT placeholder feed
    - Scratch variants A-D (evidence in validation/routing/d7_investigation/): none DRC-clean / fully connected
    - Recommendation: fold D7 into a single U501 fan-out review with D5/D9 once ST documents arrive
    - Owner rulings D8 (voltage-incompatible inputs unrouted) and D9 (MAIN_SWCLK deferred) recorded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
    [grid_route.py]
2026-10-11 D7 deferral: FLY_PGOOD->U501.28 folded into a U501 pin 24-38 fan-out review (docs only, no copper change)
    - ROUTING_STAGES.md section 8: deferred connections, pin 24-38 scope table read from the PCB,
    review method (escape order, vias, layer transitions, RF clearances, switching-sensitive routes),
    controlled cleanup plan for duplicate LED_MAIN / zero-length RS485_RO segments, pin-move gate,
    documents and decisions still needed.
    - CURRENT_STATUS.md: D7 deferred, D8/D9 blocked, audit rows marked.
    - DECISION_LOG.md section 7: routing rulings D1-D9.
    Board unchanged from route-stage5a-done. Incomplete, electrically untested, not fabrication-ready.
2026-10-31 Schematic ECO1: WBA55 supplies, RF filter, HPH6-0090L, soft start, 48 V protection, READY/FAULT shifters (no PCB change)
    Verified against DS14127, AN6373, AN5948, DS14446, SNVSB75E and Coilcraft Doc 613; record and
    evidence in docs/handover/ECO1_SCHEMATIC.md and validation/sim. No MCU pin assignments changed.
    PCB copper is unchanged from route-stage5a-done, so schematic parity reports expected differences
    until the owner approves the PCB update. ERC: 5 power_pin_not_driven left visible (no PWR_FLAGs
    added). Incomplete, electrically untested, not fabrication-ready.
    [bom.csv, bom_detailed.csv, mcu_main.kicad_sch, pmd_interface.kicad_sch, power_3v3.kicad_sch, power_48v.kicad_sch, power_input.kicad_sch]
2026-10-31 Schematic ECO2: independent 48 V trip, 30 V FET with clamp ceiling, SPI protection (no PCB change)
    Replaces SMBJ48A with a zener and BSS138 trip on FLY_EN; Q301 AONR34332C, R306 330R, C308 100nF,
    D304 SMAJ15A; R702-R704 1k with R717-R719 dividers; R312 on the RAW side; C510-C513 0402.
    PCB still at route-stage5a-done. Incomplete, electrically untested, not fabrication-ready.
    [bom.csv, bom_detailed.csv, mcu_main.kicad_sch, pmd_interface.kicad_sch, power_48v.kicad_sch]
2026-10-31 PCB stage P1: update footprints and placement to ECO2, preserving routing (no new signal routing)
    In-place update with scripts/pcb_eco.py; parity 0, DRC errors 0, 81 unconnected pairs expected at
    this stage. Removed copper and cuts are itemised in validation/routing/pcb_p1_log.txt.
    Incomplete, electrically untested, not fabrication-ready.
    [pcb_p1_plan.json, pump_v2.kicad_pcb]
2026-10-31 PCB stage P1b: placement corrections from the review (T301 margins, right edge +1.5 mm, clamp parts closer)
    No signal routing. Records in validation/routing/pcb_p1b_*.txt. Incomplete, untested, not fabrication-ready.
    [pcb_p1b_plan.json, pcb_p1c_plan.json, pump_v2.kicad_pcb]
2026-10-31 P2 tooling and route specifications (no board change)
2026-10-31 PCB stage P2: RF, WBA55 supplies, crystals, U501 pins 24-40 and FLY_PGOOD routed
    Hand-nested fan-out plus deterministic router, no flyback routing. DRC errors 0, parity 0, 50 unconnected.
    RF path is 11 mm with no vias and no crossings. Incomplete, electrically untested, not fabrication-ready.
    [pump_v2.kicad_pcb]
2026-10-31 Schematic ECO3: Q301 gate bridge with optional resistor, optional drain snubber (both unfitted)
    JP301 is a copper bridge so the gate stays connected while R316 is unfitted. Q301 stays open:
    margin not established. PCB updated in the next commit. Not fabrication-ready.
    [bom.csv, bom_detailed.csv, power_48v.kicad_sch]
2026-10-31 PCB stage P4: independent signals routed, ECO3 parts placed; flyback and U101 left open
    DRC errors 0, parity 0. Q301 margin, T301 leakage and PMD401 voltage protection remain open.
    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
    [pump_v2.kicad_pcb]
2026-10-31 PCB stage P4: remove isolated top-layer pour islands; refresh checks and images
    [pump_v2.kicad_pcb]
2026-10-31 PCB stage P5 work in progress: routing, F.Mask rework land support, Q301 sim decks
    route_stage.py hand specs can now add F.Mask rectangles. DRC report: 305 violations,
    34 unconnected pads. Incomplete, electrically untested, not fabrication-ready.
    Q301 .raw waveform outputs (about 500 MB) are not committed; decks and logs are.
    [pump_v2.kicad_pcb]
2026-11-01 Schematic: PWR_FLAG on WBA55 rails fed through passives or the on-chip SMPS (ERC errors 5 -> 0)
    [mcu_main.kicad_sch]
2026-11-01 PCB stage P6: flyback, 48 V rail, OVP group (moved clear of C311/C702), charger pins routed; 33 of 34 pairs closed
    [pump_v2.kicad_pcb]
2026-11-01 PCB stage P6: ENC_I_M routed (B.Cu crossing under RF line, VDD11 jog moved); rework land removed
    [pump_v2.kicad_pcb]
2026-11-01 Silkscreen cleanup driven by DRC (no footprint or copper change), MAX3485 flattened into project library; DRC and ERC 0 violations
    [pmd_interface.kicad_sch, pump_v2.kicad_pcb]
2026-11-01 PCB stage P6 complete: TVS parts assigned, ERC and DRC 0 violations, 0 unconnected, parity 0; docs, report figures
    Software validation only; not built or measured.
    [bom.csv, bom_detailed.csv, pmd_interface.kicad_sch, pump_v2.kicad_pcb]
2026-11-01 Independent design review: report, reproducible check scripts and outputs
    Docs and tooling only; schematic, PCB and design.py are unchanged.
    - docs/review/INDEPENDENT_DESIGN_REVIEW.md: 5 critical, 15 major and 10 minor
    findings with fixes. New: no LM51551 slope compensation, a 0.2 mm FLY_CS
    track inside the sense path (Ilim(min) ~2.5 A), the RCD clamp ~25 mm from
    the switch node (sim Vds 26-28 V on a 25 V FET), a 0.2 mm battery-path
    track, stale BOMs, and fail-unsafe READY/FAULT.
    - scripts/review: own geometric PCB connectivity/clearance check, schematic
    netlist extraction vs design.py, design calculations, ngspice flyback
    layout-sensitivity netlist.
    - validation/review: outputs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
2026-11-01 Q301 simulation completed: AONR34332C 25.8-28.9 V with 3-5 nH loop, margin still open
    Re-ran the six short decks to completion and added make3.py check decks
    (settling, loop inductance, Coss from datasheet Fig. 8, TVS junction power).
    Worst corner 28.9 V, about 29.9 V with the TVS heating estimate; TVS about 3 W
    at 10 % leakage and the 4.9 A limit, rating not checked. Simulation only.
    Results in validation/sim/q301/RESULTS.md; handover docs updated. BUK decks are
    not evidence (datasheet not retrieved). Q301 .raw and new .db outputs git-ignored.
    No schematic, PCB or generator change.
2026-11-01 Ignore KiCad local history folder
